SPARC-Auburn/IEEE-SoutheastCon-2009/Mechanical/Sorting Rack/SR-ASSY.jpg

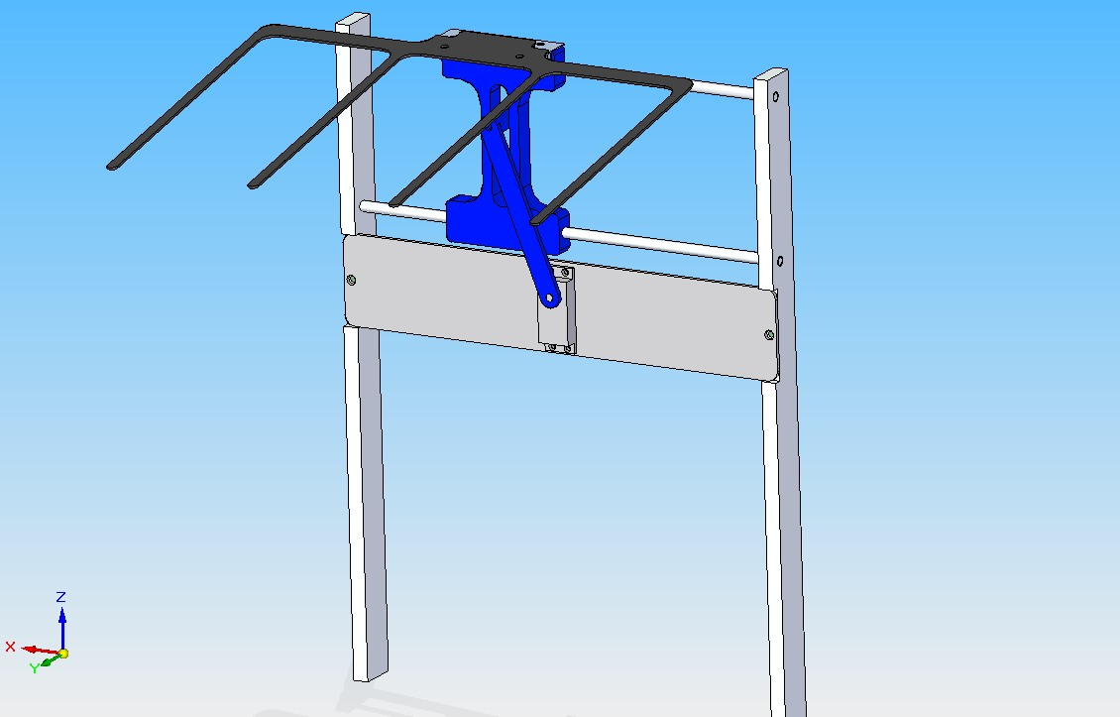
Mechanical/Sorting Rack/SR-ASSY.jpg
