SPARC-Auburn/IEEE-SoutheastCon-2009/README.md

# IEEE-SoutheastCon-2009


</br>
2009 IEEE Southeastern Conference Hardware Competition
Auburn wins First Place. Completely autonomous (no human control) robots pick up and sort plastic bottles, glass bottles, and aluminum cans. </br> </br>
<h3>Youtube links</h3>
Finals Rounds 1 and 2: https://www.youtube.com/watch?v=hqzZF7xkqyw&ab_channel=ThaddeusRoppel</br>
Finals Round 2: https://www.youtube.com/watch?v=y-UYFPOnJFw&ab_channel=SoutheastCon2009</br><br/>

<br/>
For more photos visit: https://www.flickr.com/photos/jckhamken/sets/72157614361313436/
