SPARC-Auburn/IEEE-SoutheastCon-2009/Mechanical/Sorting Rack/Sorting Rack Movement.xlsx

 | Total Servo Rotation
Crank Length (in) | degrees | radians | Block Traversal (in) | Distance from center (in)
4.00 | 140.00 | 2.44 | 7.52 | 3.76
