SPARC-Auburn/IEEE-SoutheastCon-2009/Code/Utilities/Dashboard/sorterImageA.gif

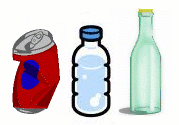
Code/Utilities/Dashboard/sorterImageA.gif
