SPARC-Auburn/IEEE-SoutheastCon-2009/Mechanical/ARM CONCEPT - ALUMINUM CAN.jpg

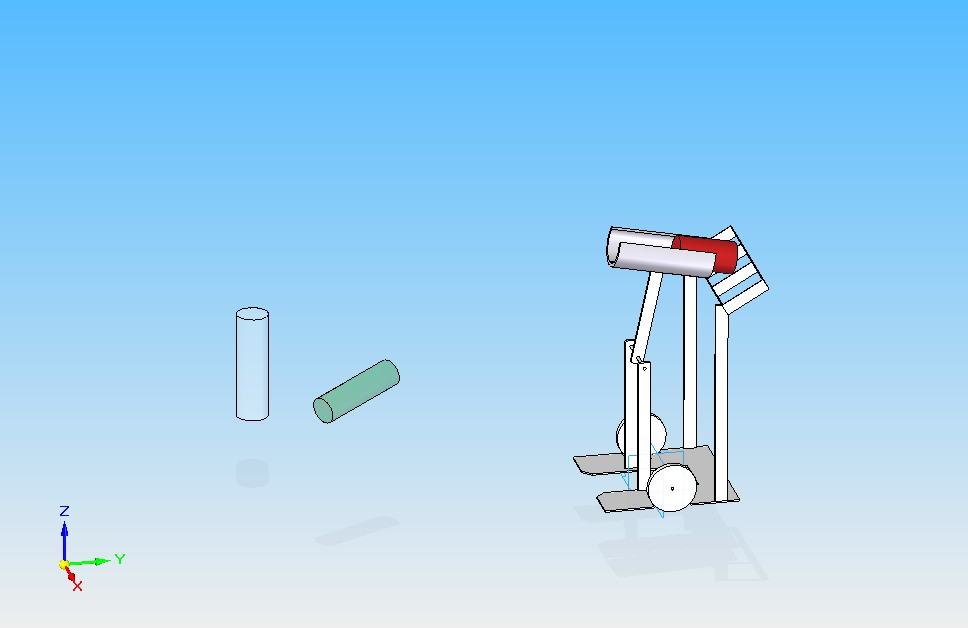
Mechanical/ARM CONCEPT - ALUMINUM CAN.jpg
