SPARC-Auburn/IEEE-SoutheastCon-2009/Mechanical/ARM CONCEPT - CLOSED.jpg

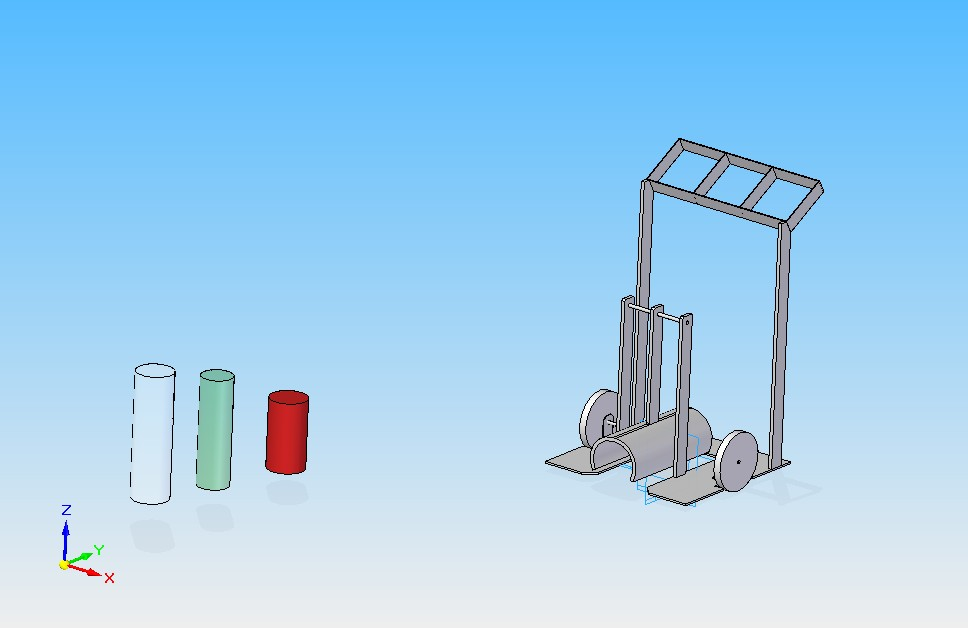
Mechanical/ARM CONCEPT - CLOSED.jpg
