SPARC-Auburn/IEEE-SoutheastCon-2009/Mechanical/ARM CONCEPT - EXTENDED.jpg

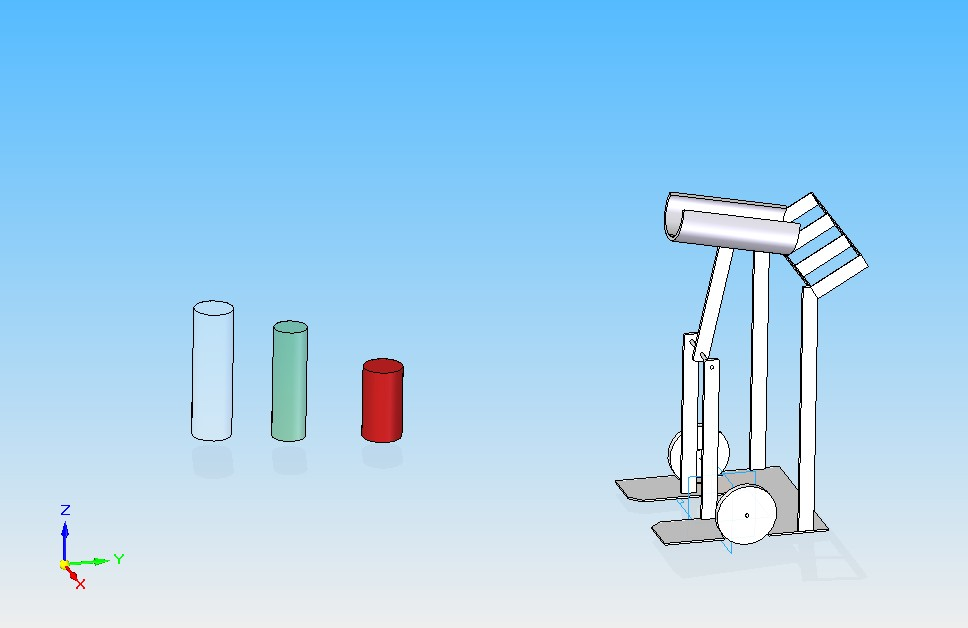
Mechanical/ARM CONCEPT - EXTENDED.jpg
