SPARC-Auburn/IEEE-SoutheastCon-2009/Mechanical/ARM CONCEPT - GLASS BOTTLE.jpg

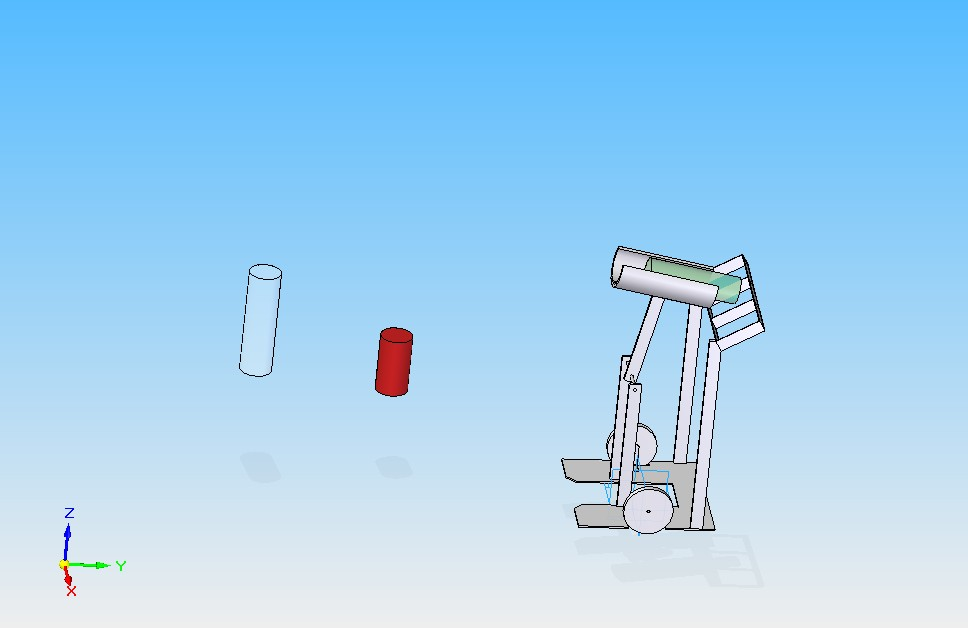
Mechanical/ARM CONCEPT - GLASS BOTTLE.jpg
