SPARC-Auburn/IEEE-SoutheastCon-2009/Mechanical/Chassis/Chassis Model Images/CHAS-SR-ASSY-BOARDMOUNTED.jpg

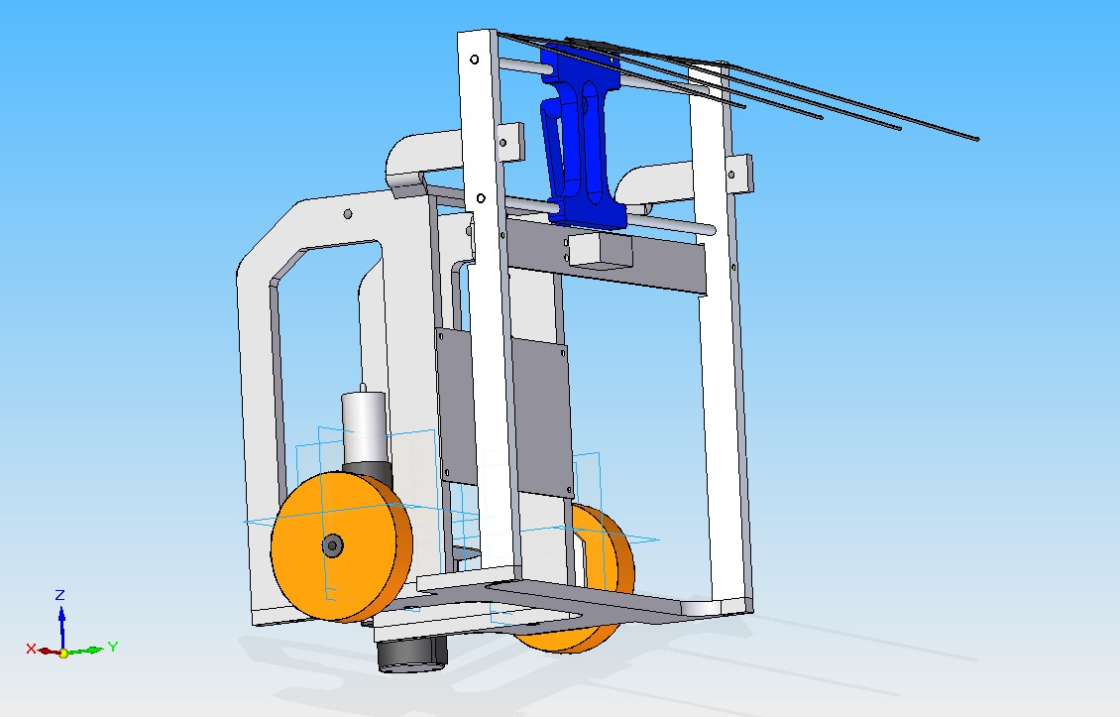
Mechanical/Chassis/Chassis Model Images/CHAS-SR-ASSY-BOARDMOUNTED.jpg
