SPARC-Auburn/IEEE-SoutheastCon-2009/Mechanical/Chassis/Chassis Model Images/CHAS-SR-ASSY-BOTTOM.jpg

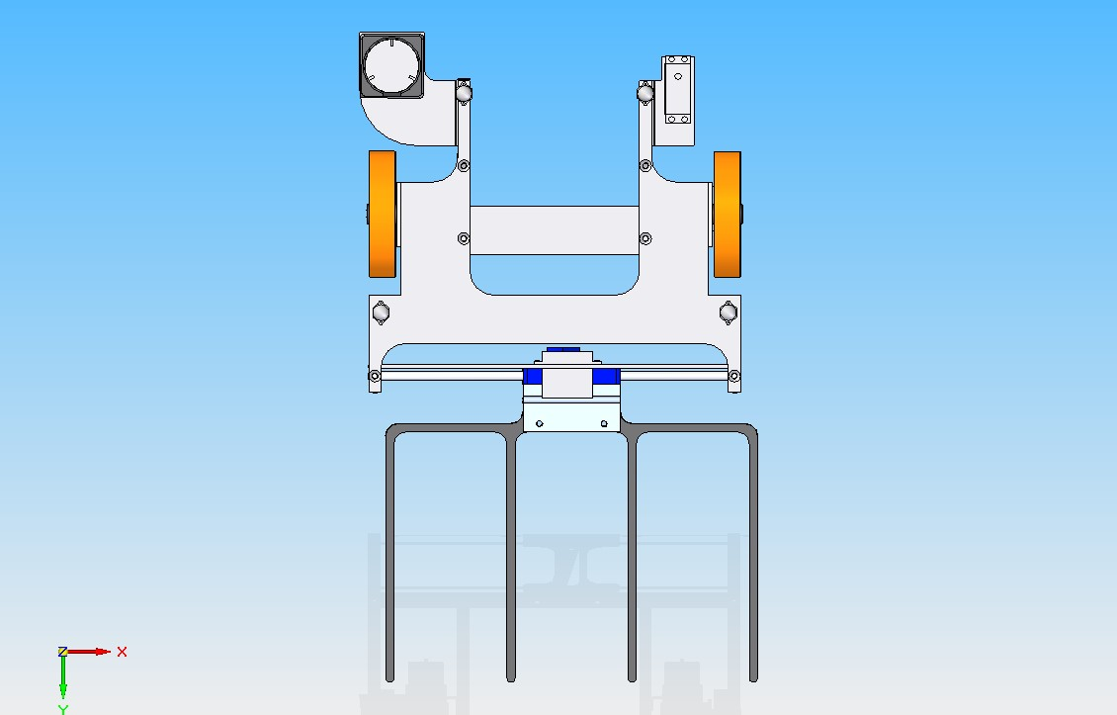
Mechanical/Chassis/Chassis Model Images/CHAS-SR-ASSY-BOTTOM.jpg
