SPARC-Auburn/IEEE-SoutheastCon-2009/Mechanical/Chassis/Hardware References/IG32RGMa.gif

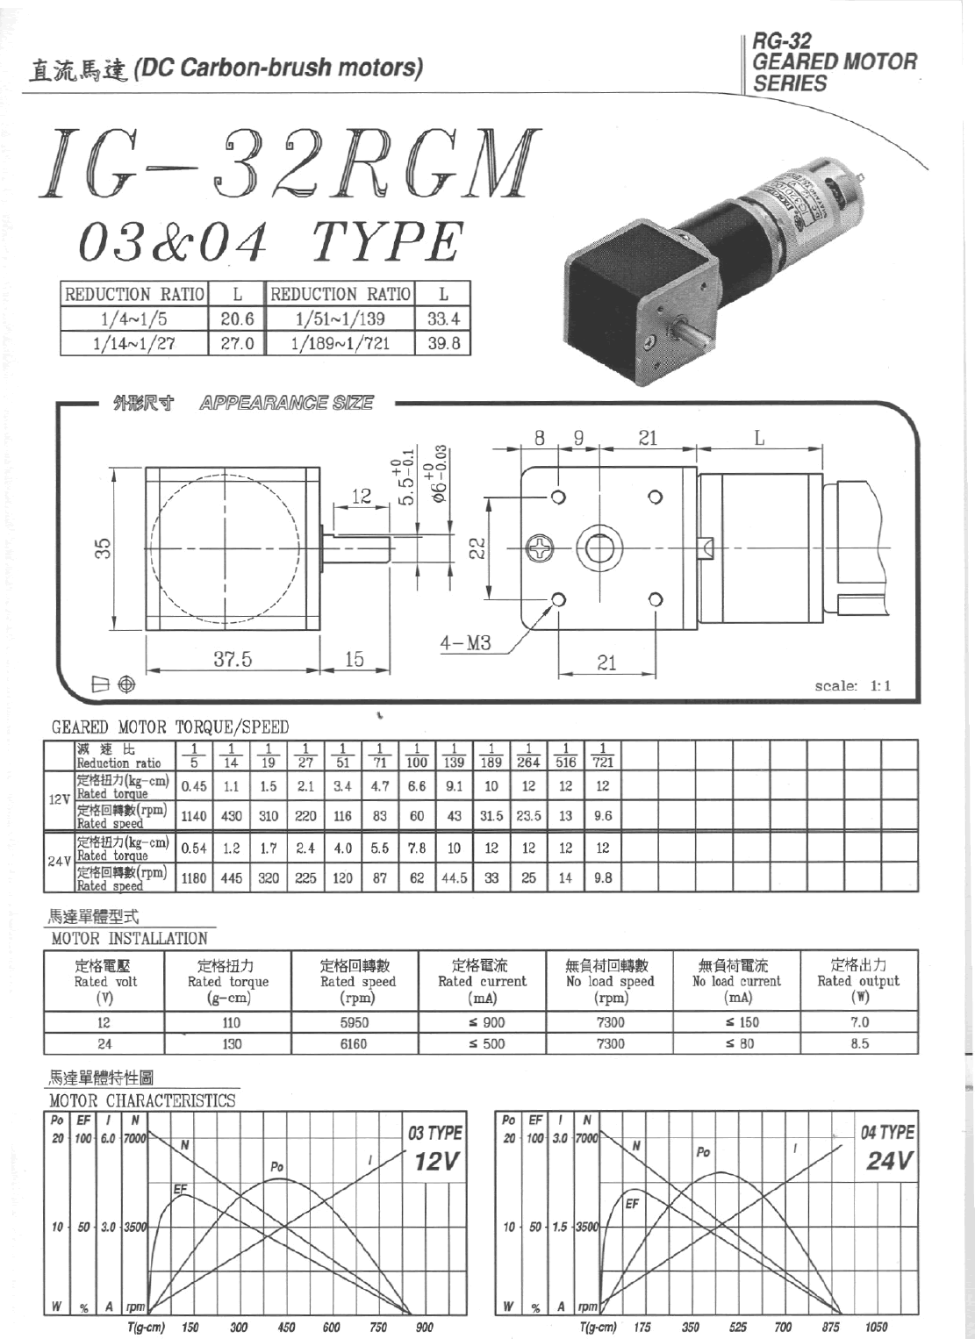
Mechanical/Chassis/Hardware References/IG32RGMa.gif
