SPARC-Auburn/IEEE-SoutheastCon-2009/Mechanical/Chassis/Hardware References/PololuCasters.jpg

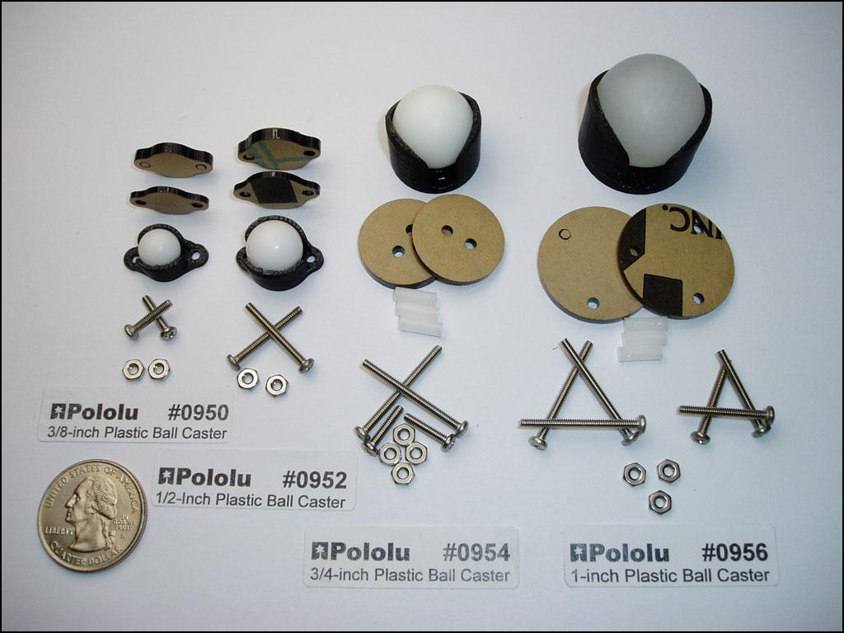
Mechanical/Chassis/Hardware References/PololuCasters.jpg
