SPARC-Auburn/IEEE-SoutheastCon-2009/Mechanical/Chassis/OBJECT DETECTION 1.jpg

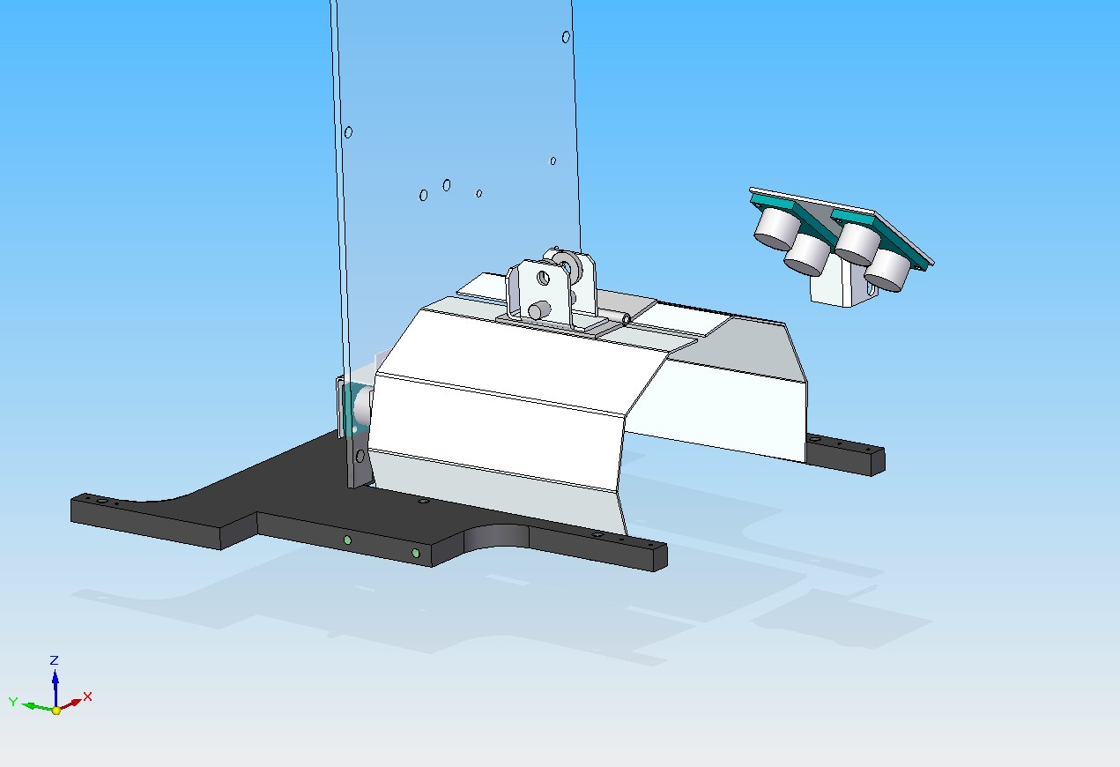
Mechanical/Chassis/OBJECT DETECTION 1.jpg
