SPARC-Auburn/IEEE-SoutheastCon-2009/Mechanical/Chassis/OBJECT DETECTION 2.jpg

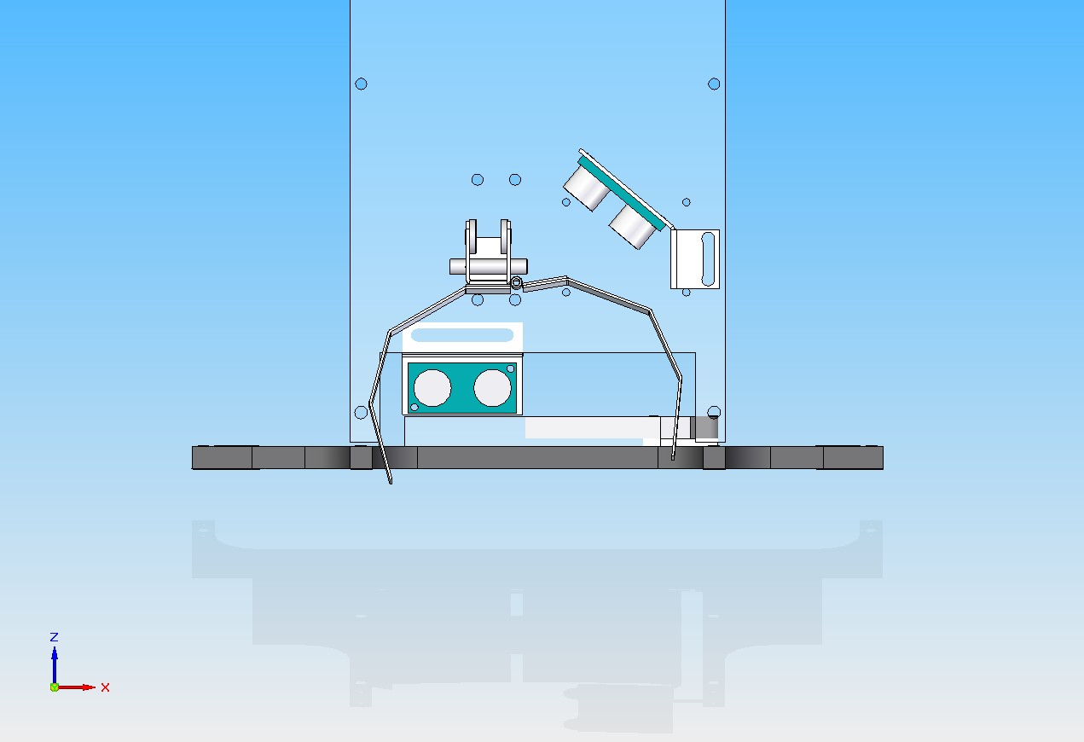
Mechanical/Chassis/OBJECT DETECTION 2.jpg
