SPARC-Auburn/IEEE-SoutheastCon-2009/Mechanical/Chassis/OBJECT DETECTION 5.jpg

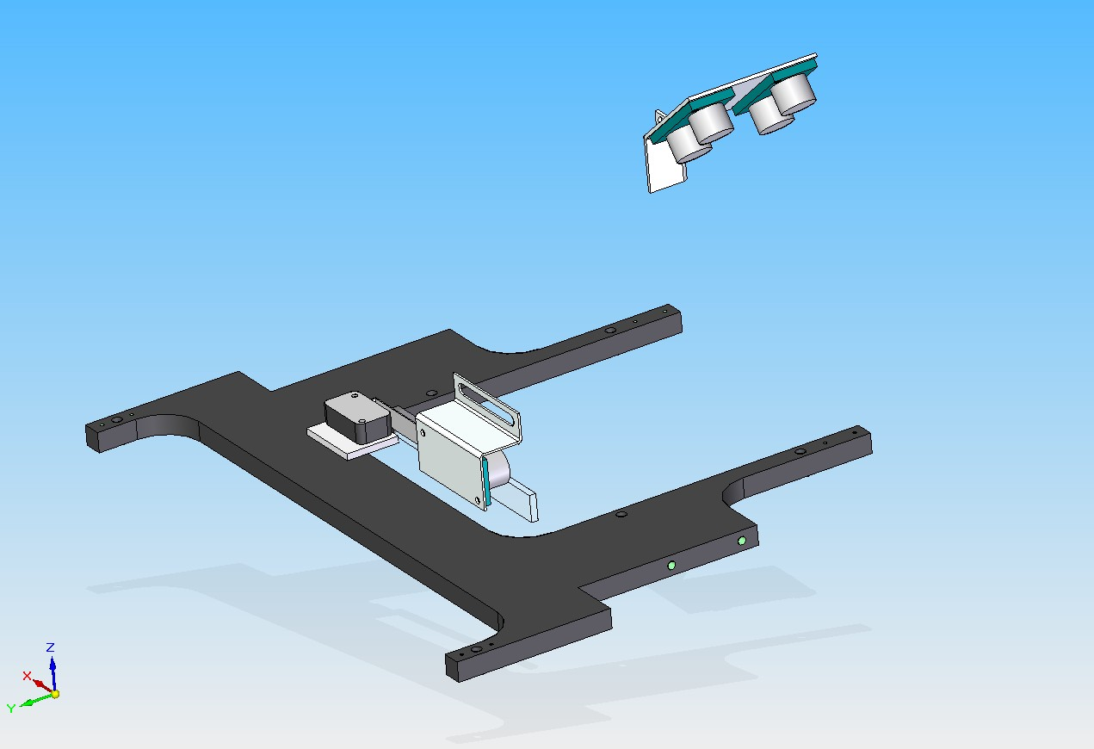
Mechanical/Chassis/OBJECT DETECTION 5.jpg
