SPARC-Auburn/IEEE-SoutheastCon-2009/Mechanical/Chassis/OBJECT DETECTION 6.jpg

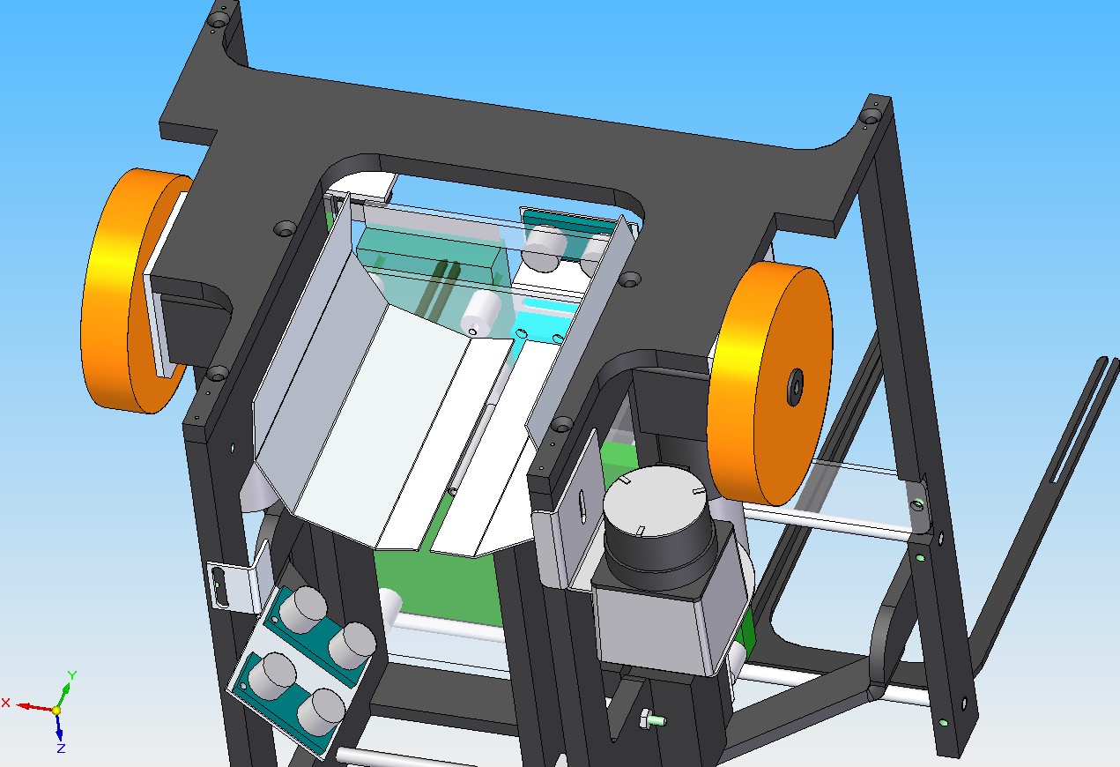
Mechanical/Chassis/OBJECT DETECTION 6.jpg
