SPARC-Auburn/IEEE-SoutheastCon-2009/Mechanical/Concepts/Arm-Gripper/gripper-closed.jpg

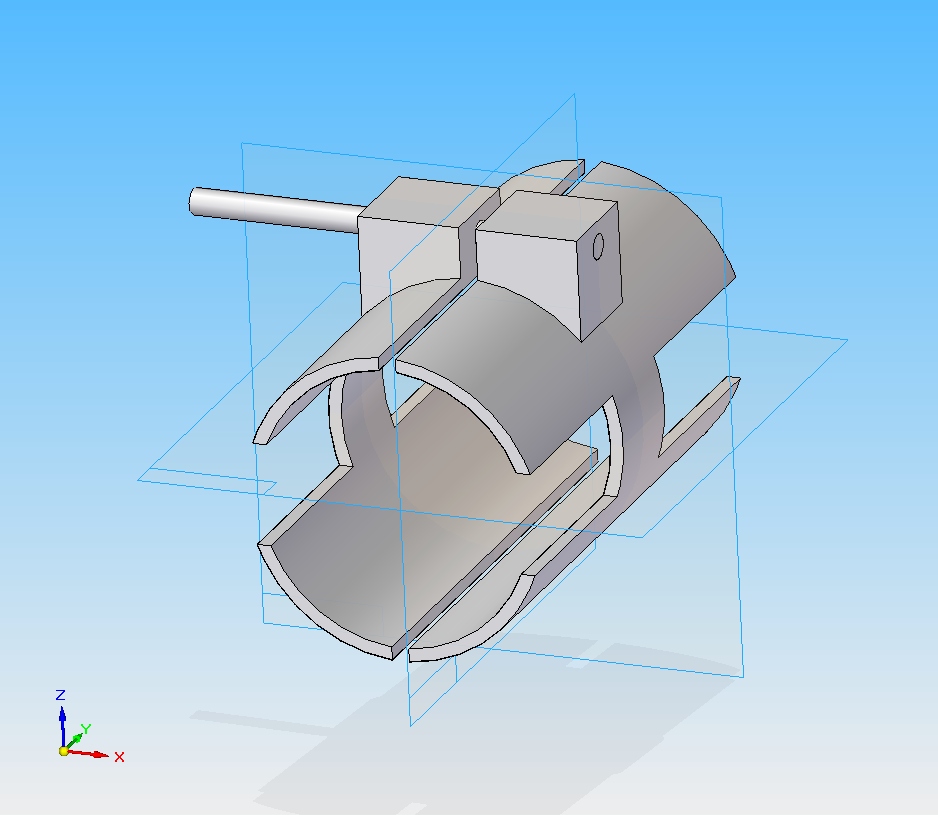
Mechanical/Concepts/Arm-Gripper/gripper-closed.jpg
