SPARC-Auburn/IEEE-SoutheastCon-2009/Mechanical/Concepts/Arm-Gripper/gripper-open.jpg

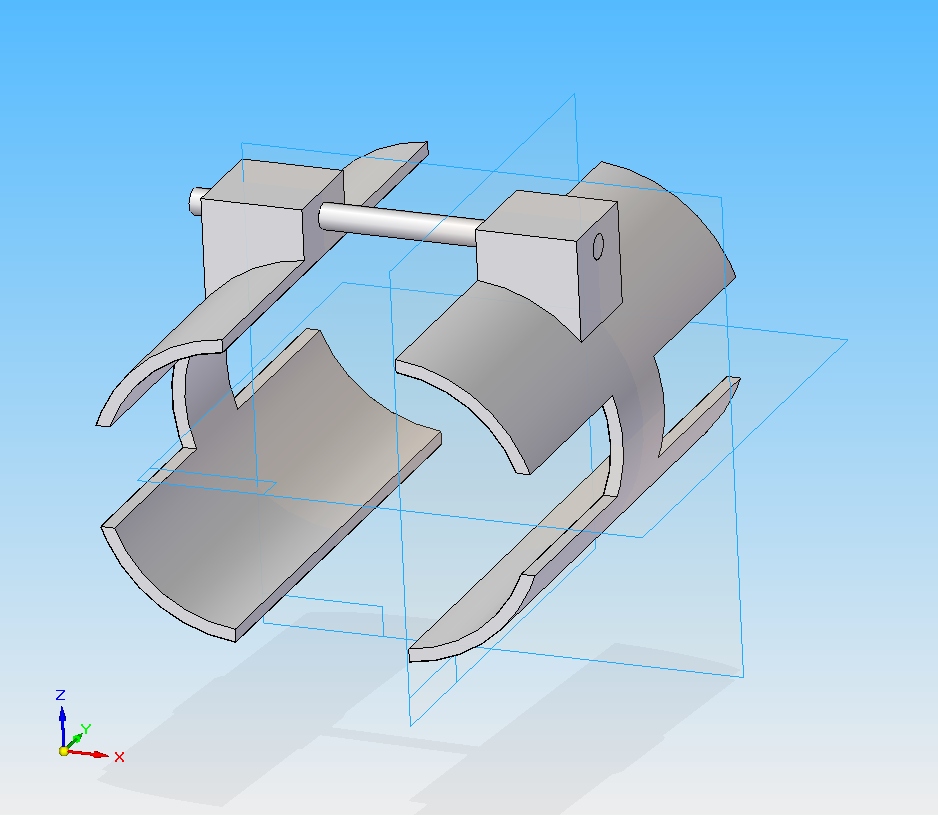
Mechanical/Concepts/Arm-Gripper/gripper-open.jpg
