SPARC-Auburn/IEEE-SoutheastCon-2009/Mechanical/Concepts/End Effector/Scoop.jpg

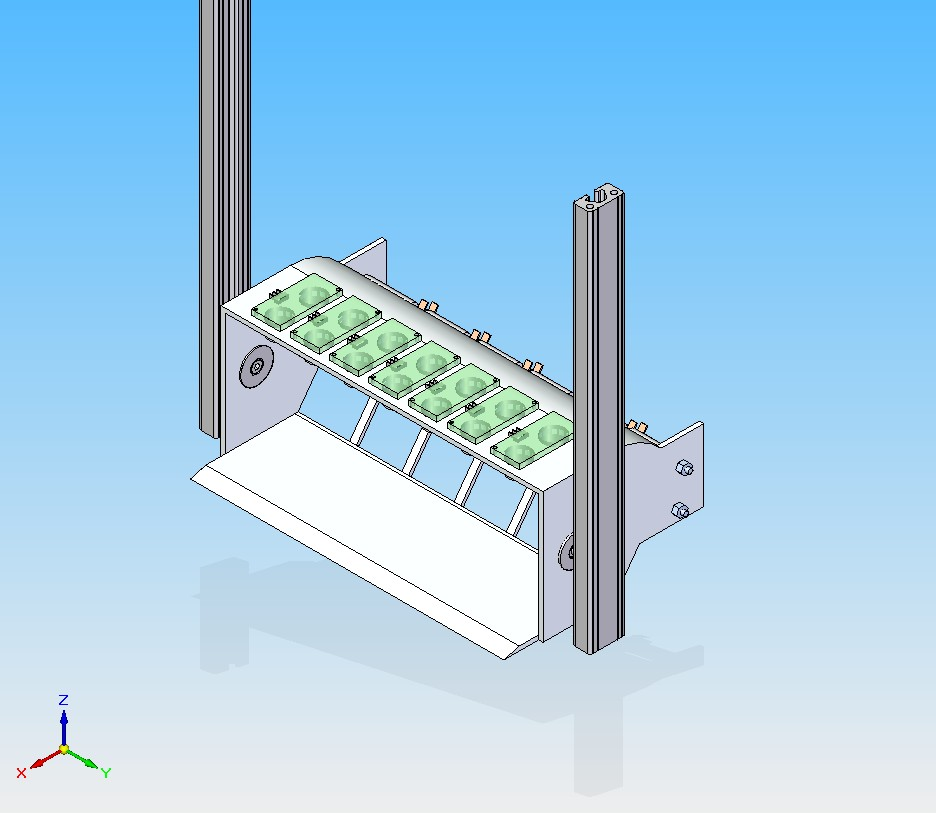
Mechanical/Concepts/End Effector/Scoop.jpg
