SPARC-Auburn/IEEE-SoutheastCon-2009/Mechanical/Concepts/End Effector/Scoop_back.jpg

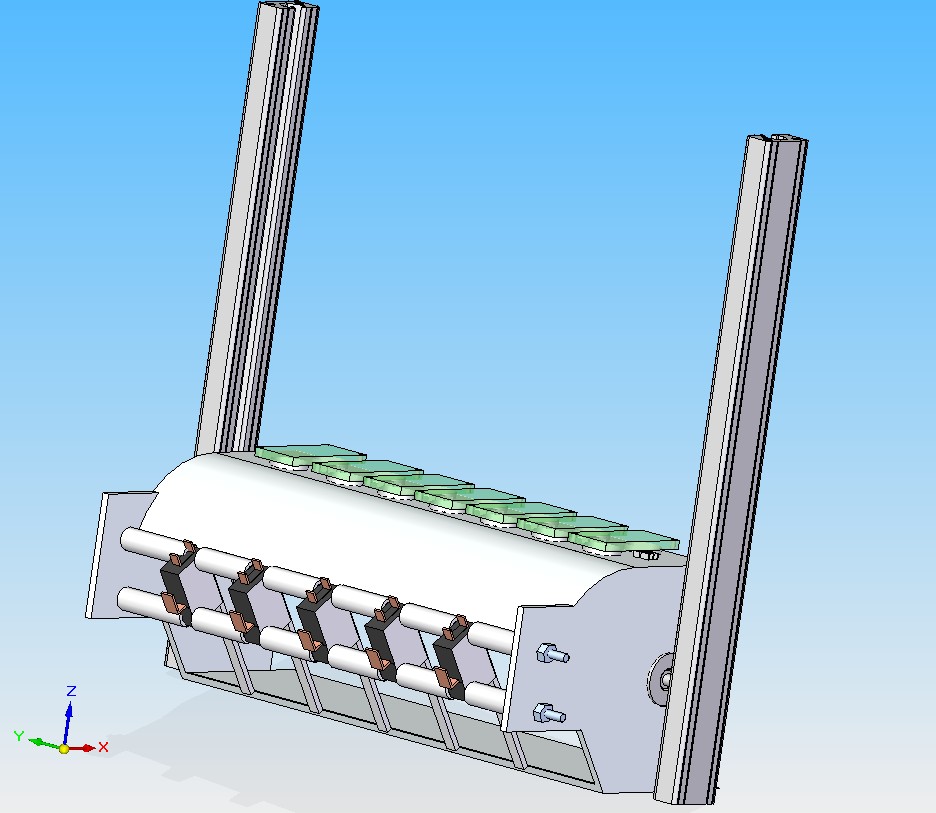
Mechanical/Concepts/End Effector/Scoop_back.jpg
