SPARC-Auburn/IEEE-SoutheastCon-2009/Mechanical/Sorting Rack/SR-5-ASSY.jpg

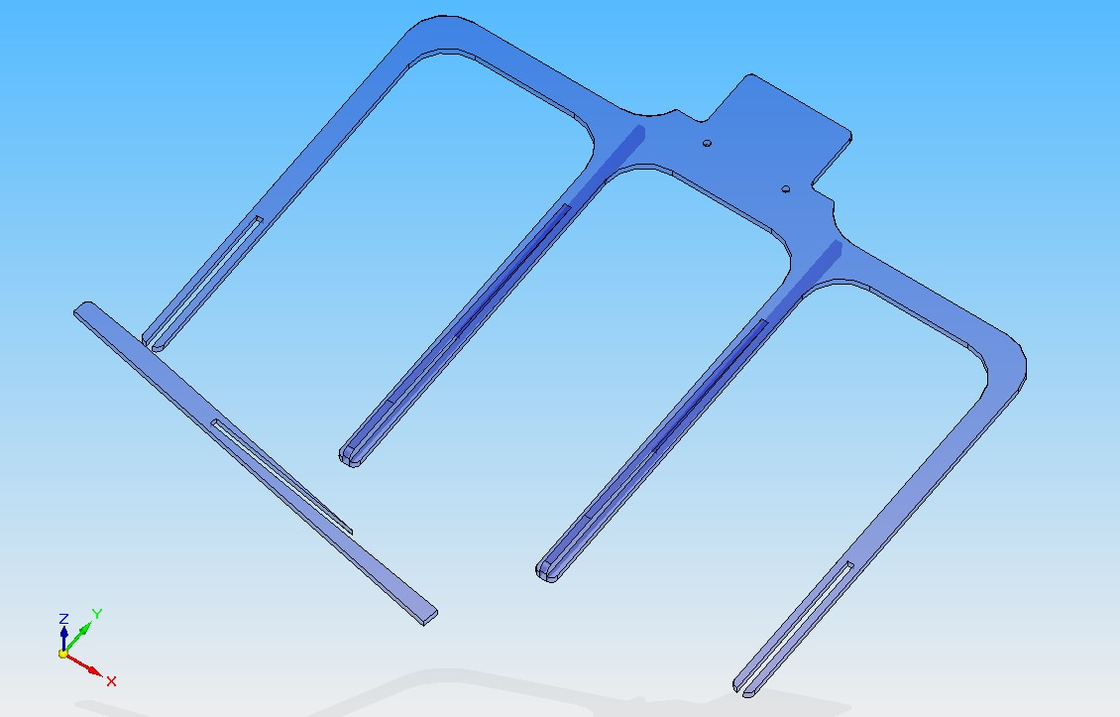
Mechanical/Sorting Rack/SR-5-ASSY.jpg
