SPARC-Auburn/IEEE-SoutheastCon-2009/Mechanical/Sorting Rack/SR-15.jpg

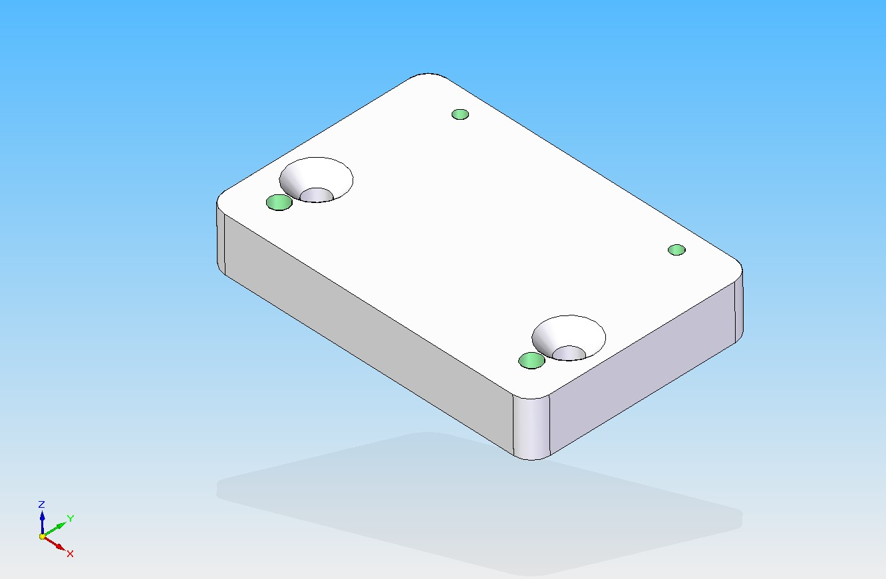
Mechanical/Sorting Rack/SR-15.jpg
