SPARC-Auburn/IEEE-SoutheastCon-2009/Mechanical/Sorting Rack/SR-17.jpg

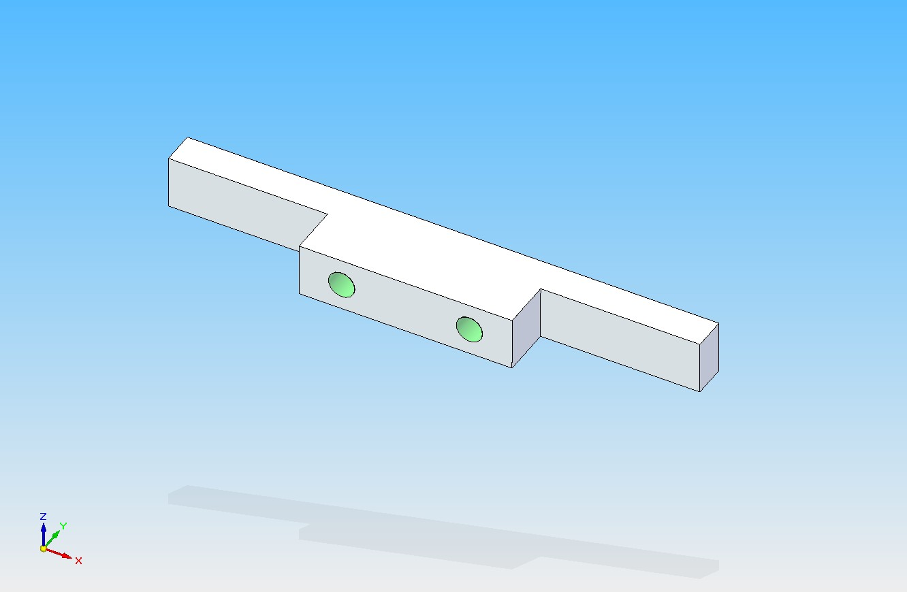
Mechanical/Sorting Rack/SR-17.jpg
