SPARC-Auburn/IEEE-SoutheastCon-2009/Mechanical/Sorting Rack/SR-chassis-2.jpg

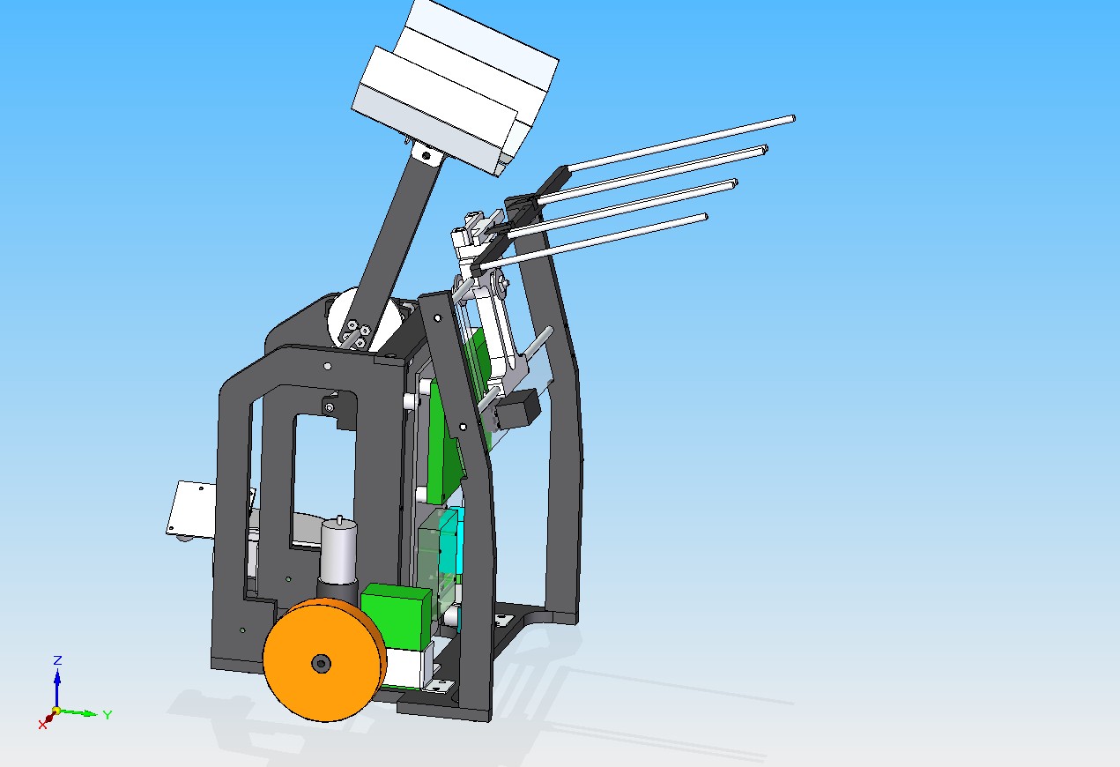
Mechanical/Sorting Rack/SR-chassis-2.jpg
