SPARC-Auburn/IEEE-SoutheastCon-2009/Mechanical/Sorting Rack/SR-chassis.jpg

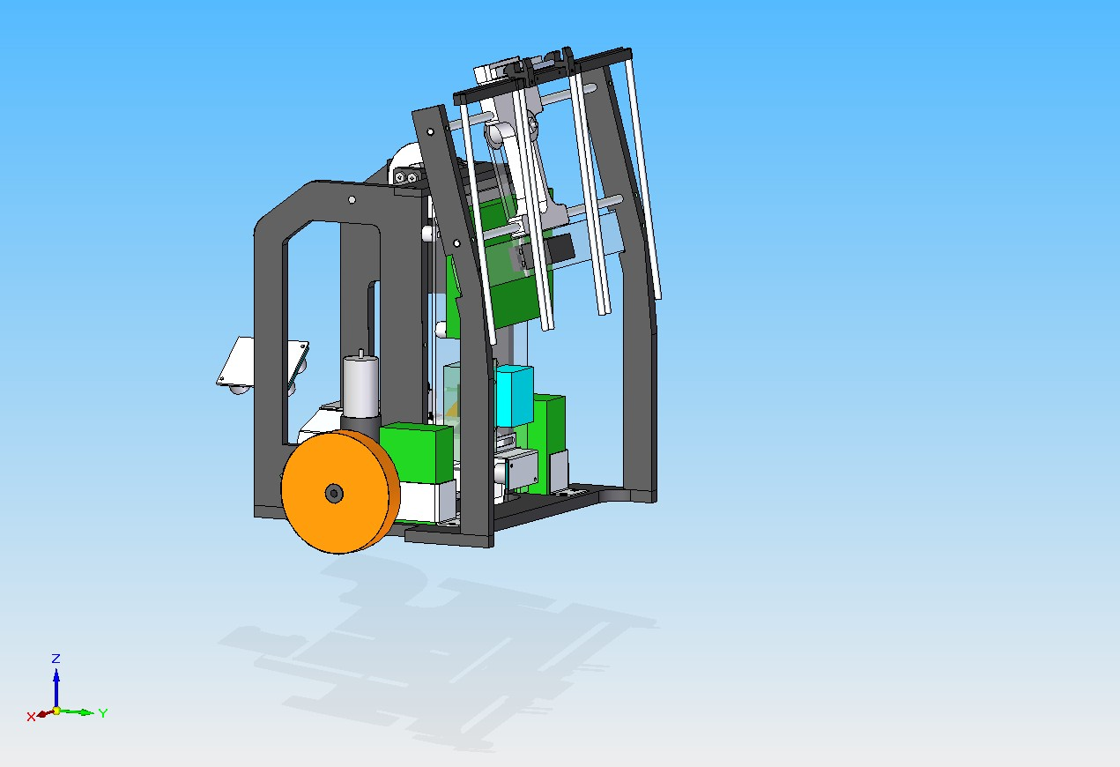
Mechanical/Sorting Rack/SR-chassis.jpg
