SPARC-Auburn/IEEE-SoutheastCon-2009/Mechanical/Sorting Rack/SR-LOCKING.jpg

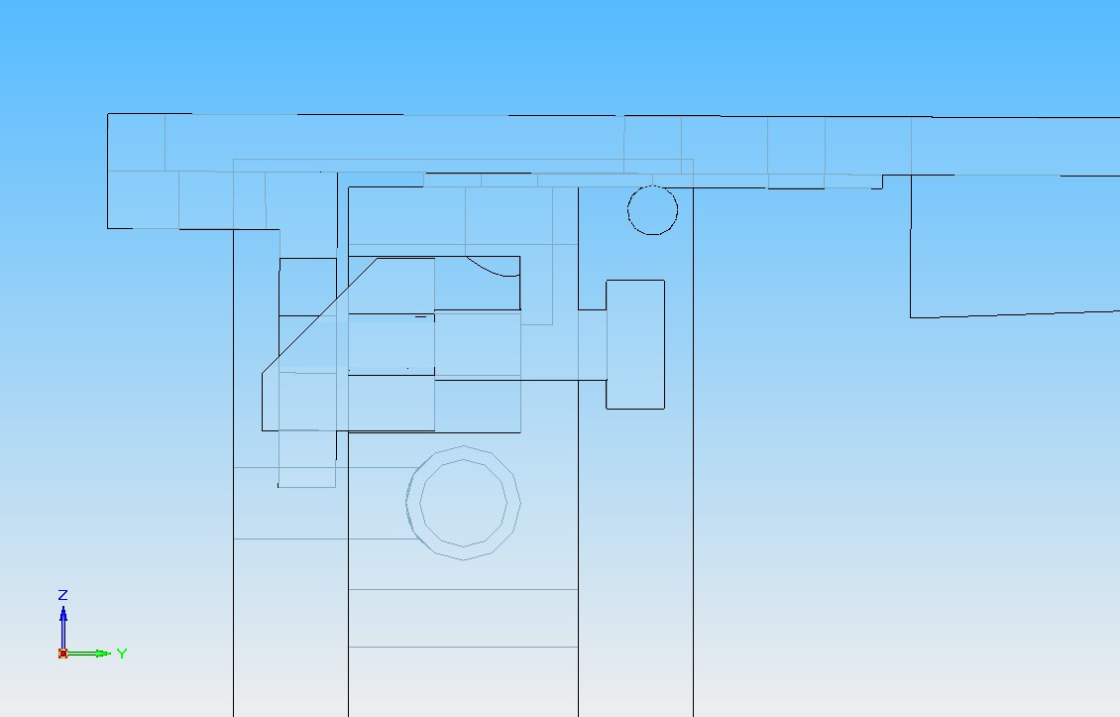
Mechanical/Sorting Rack/SR-LOCKING.jpg
