SPARC-Auburn/IEEE-SoutheastCon-2009/Mechanical/Sorting Rack/SR-strut.jpg

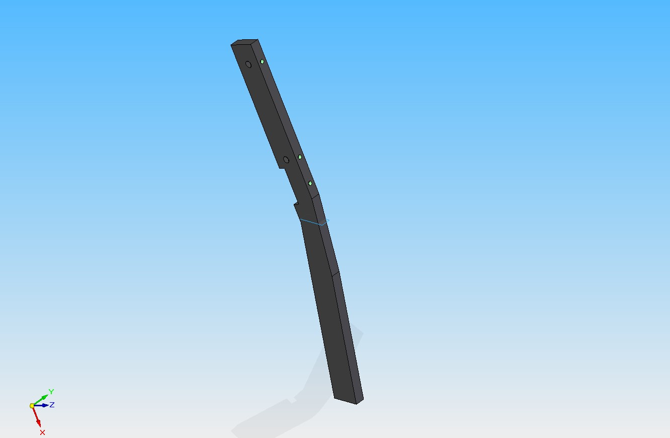
Mechanical/Sorting Rack/SR-strut.jpg
