SPARC-Auburn/IEEE-SoutheastCon-2009/Photos/3046214849_23b4dd4981_o.jpg

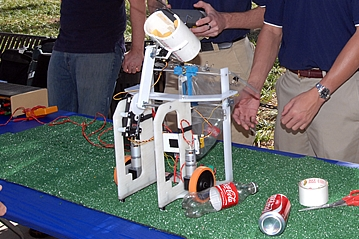
Photos/3046214849_23b4dd4981_o.jpg
