SPARC-Auburn/IEEE-SoutheastCon-2009/Photos/3047049482_58ed21244e_o.jpg

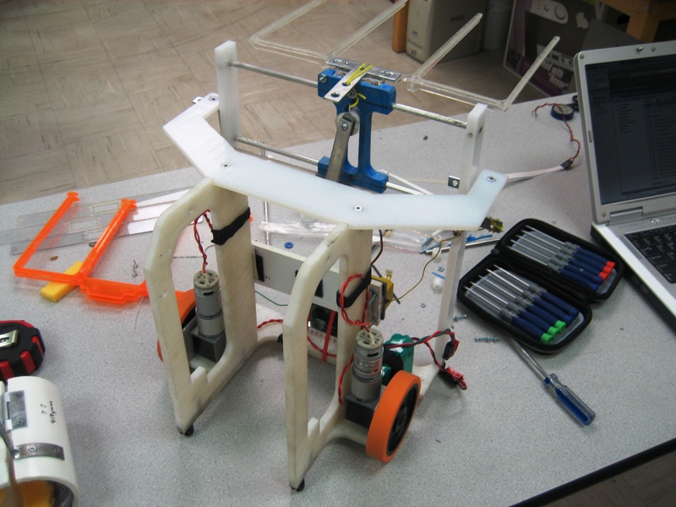
Photos/3047049482_58ed21244e_o.jpg
