SPARC-Auburn/IEEE-SoutheastCon-2009/Photos/3309738992_0ff4b380c9_o.jpg

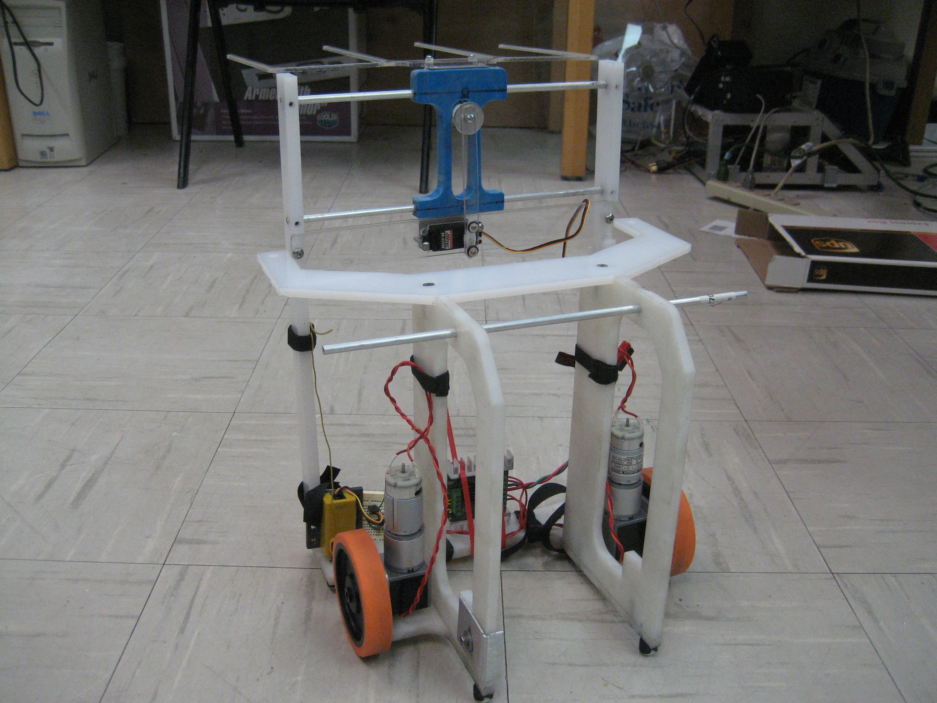
Photos/3309738992_0ff4b380c9_o.jpg
