SPARC-Auburn/IEEE-SoutheastCon-2009/Photos/3341780934_8ddb304d2c_o.jpg

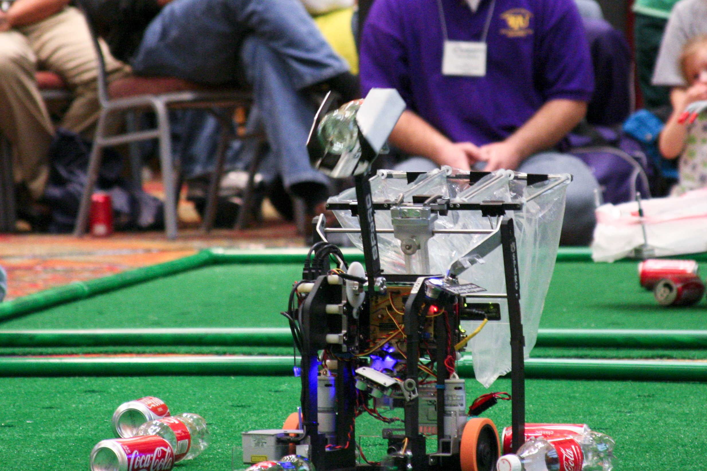
Photos/3341780934_8ddb304d2c_o.jpg
