SPARC-Auburn/IEEE-SoutheastCon-2009/Mechanical/BOMs/Chassis BOM - Rev 2.xlsx

Bill of Materials for Chassis
Item |  | Part Number | Quantity | Unit Price | Shipping | Total Price | Vender | Website
Delrin Sheet - 3/8" x 24" x 12" Rectangle Sheet - Black |  | 8575K216 | 1 | $66.01 | $0.00 | $66.01 | McMaster-Carr
 |  |  | 1 | $0.00 | $0.00 | $0.00
 |  |  | 1 | $0.00 | $0.00 | $0.00
 |  |  | 1 | $0.00 | $0.00 | $0.00
 |  |  | 1 | $0.00 | $0.00 | $0.00
 |  |  | 1 | $0.00 | $0.00 | $0.00
 |  |  | 1 | $0.00 | $0.00 | $0.00
 |  |  | 1 | $0.00 | $0.00 | $0.00
 | TE-091-210 |  | 1 | $0.00 | $0.00 | $0.00
 |  |  | 1 | $0.00 | $0.00 | $0.00
GRAND TOTAL: |  |  |  |  |  | $66.01
