SPARC-Auburn/IEEE-SoutheastCon-2009/Mechanical/BOMs/Sorting Rack BOM - Rev 2.xlsx

Bill of Materials for Sorting Rack
Item | Part Number | Quantity | Unit Price | Shipping | Total Price | Vender
Alloy Steel Precision Hex Socket Shoulder Screw 5/32" Shoulder Dia, 3/8" Shoulder Length, 6-32 Thread | 92012A527 | 2 | $3.40 | $0.00 | $6.80 | McMaster-Carr
Music wire torsion springe 270 deg angle, 0.187 coil OD, 0.023 wire, CW,LH; pack of 6 | 9271K452 | 1 | $5.90 | $0.00 | $5.90 | McMaster-Carr
 |  | 1 | $0.00 | $0.00 | $0.00
 |  | 1 | $0.00 | $0.00 | $0.00
GRAND TOTAL: |  |  |  |  | $12.70
