SPARC-Auburn/IEEE-SoutheastCon-2009/Mechanical/BOMs/Arm and End Effector BOM.xls

Bill of Materials for Arm and End Effector (TENTATIVE)
Item | Part Number | Quantity | Unit Price | Shipping | Total Price | Vender | Website
#6 x .750" PLASTIC SPACER | 94639A515 | 6 | $10.68 | $0.00 | $10.68 | MCMASTER-CARR | www.mcmaster.com
#6-32 x 1.625 PHMS | 91772A159 | 6 | $11.31 | $0.00 | $11.31 | MCMASTER-CARR | www.mcmaster.com
#6-32 HEX NUT | 90480A007 | 6 | $1.30 | $0.00 | $1.30 | MCMASTER-CARR | www.mcmaster.com
.375" ALUMINUM HUB | 3172CH | 1 | $7.95 | $0.00 | $7.95 | SERVOCITY | http://www.servocity.com/html/clamping_hubs.html
COTTER PIN, 1-9/32" TOTAL LENGTH | 93890A421 | 1 | $3.08 | $0.00 | $3.08 | MCMASTER-CARR | www.mcmaster.com
2" x 1.5" SURFACE MOUNT HINGE | 1624A62 | 1 | $3.08 | $0.00 | $3.08 | MCMASTER-CARR | www.mcmaster.com
NEOPRENE RUBBER STRIP, ADHESIVE BACKED, .5" X .375" X 25' | 8694K82 | 1 | $8.08 | $0.00 | $8.08 | MCMASTER-CARR | www.mcmaster.com
12" x 12" ALUMINUM SHEET | 1651T21 | 1 | $22.76 | $0.00 | $22.76 | MCMASTER-CARR | www.mcmaster.com
GRAND TOTAL: |  |  |  |  | $68.24
