SPARC-Auburn/IEEE-SoutheastCon-2009/Mechanical/End Effector/END-01.dxf

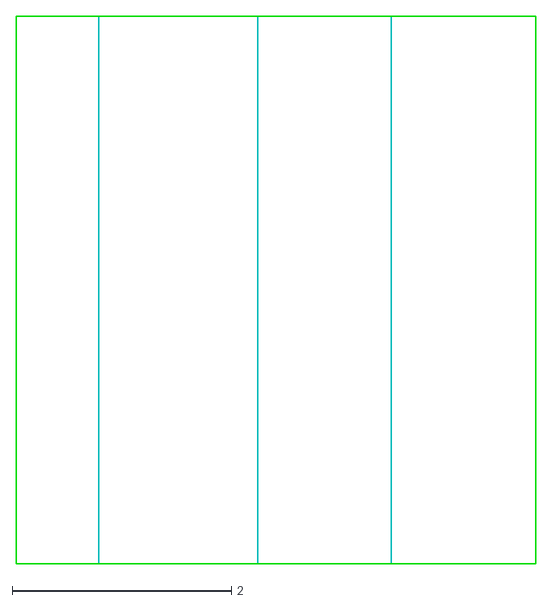
[picture p42: CAD file, 2008-11-13]
Mechanical/End Effector/END-01.dxf
4.74 x 5.00
