SPARC-Auburn/IEEE-SoutheastCon-2009/(list of files, cad)

Other CAD files:
Mechanical/CHASSIS - MOTOR BRACKET.psm
Mechanical/Chassis/BATTERY MOUNT L.psm
Mechanical/Chassis/BATTERY MOUNT R.psm
Mechanical/Chassis/CHAS-03a-L.psm
Mechanical/Chassis/CHAS-03a-R.psm
Mechanical/Chassis/CHAS-03a.psm
Mechanical/Chassis/CHAS-06.psm
Mechanical/Chassis/CHAS-07.psm
Mechanical/Chassis/REAR SONAR MOUNT.psm
Mechanical/Chassis/SONAR MOUNT.psm
Mechanical/Chassis/WHEEL ENCODER MOUNT.psm
Mechanical/End Effector/END-01.psm
Mechanical/End Effector/END-01a.psm
Mechanical/End Effector/END-02.psm
Mechanical/End Effector/END-02a.psm
Mechanical/End Effector/END-03.psm
Mechanical/End Effector/END-03a.psm
Mechanical/End Effector/END-04.psm
Mechanical/End Effector/END-04a.psm
