SPARC-Auburn/IEEE-SoutheastCon-2009/Mechanical/Chassis/ROBOT ASSEMBLY, ARM DEPOSITING ISO VIEW.jpg

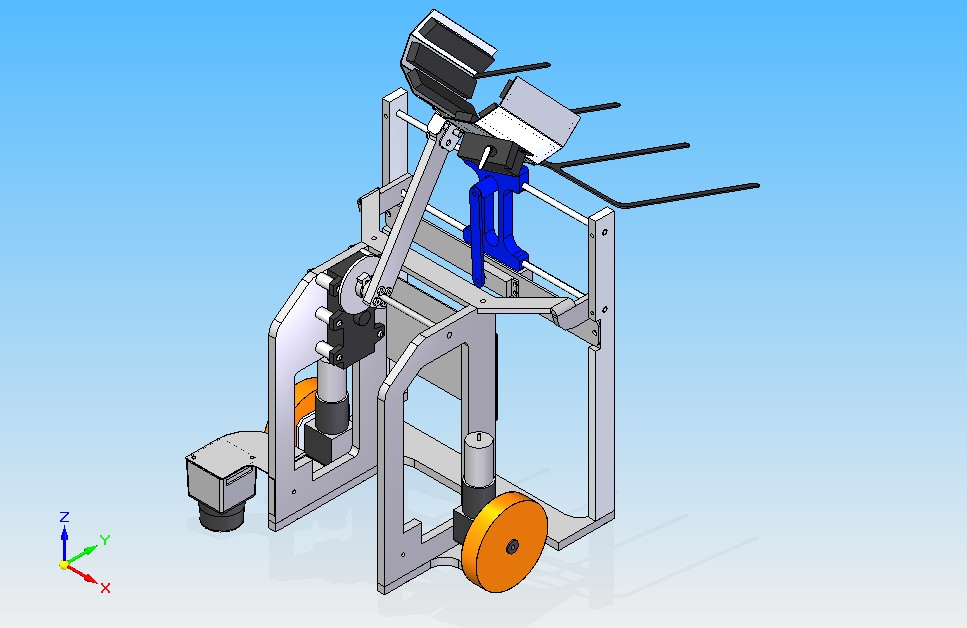
Mechanical/Chassis/ROBOT ASSEMBLY, ARM DEPOSITING ISO VIEW.jpg
