SPARC-Auburn/IEEE-SoutheastCon-2009/Mechanical/Chassis/ROBOT ASSEMBLY, ARM DEPOSITING SIDE VIEW.jpg

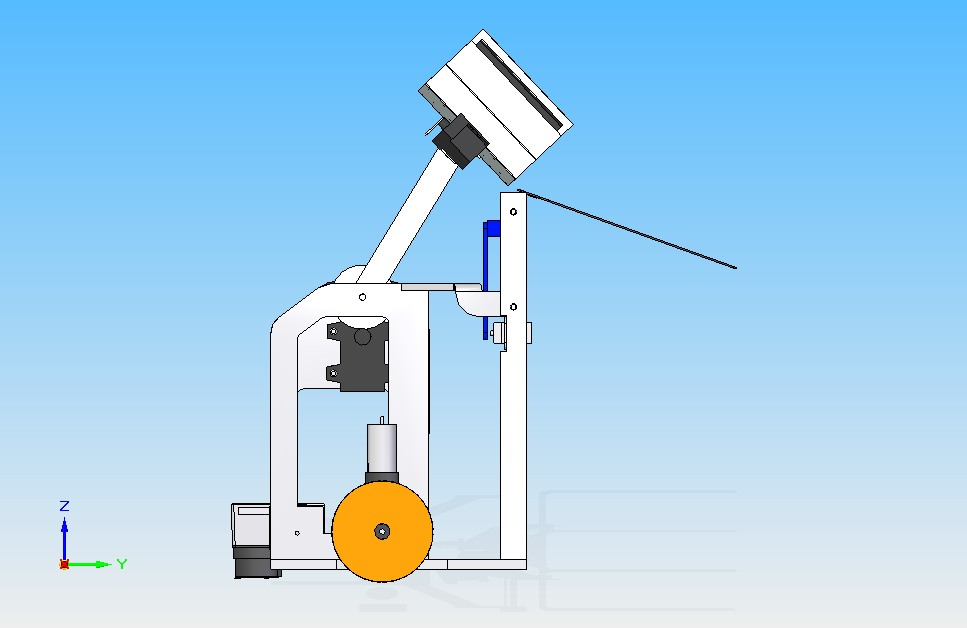
Mechanical/Chassis/ROBOT ASSEMBLY, ARM DEPOSITING SIDE VIEW.jpg
