SPARC-Auburn/IEEE-SoutheastCon-2009/Mechanical/Chassis/ROBOT ASSEMBLY, ARM STOWED.jpg

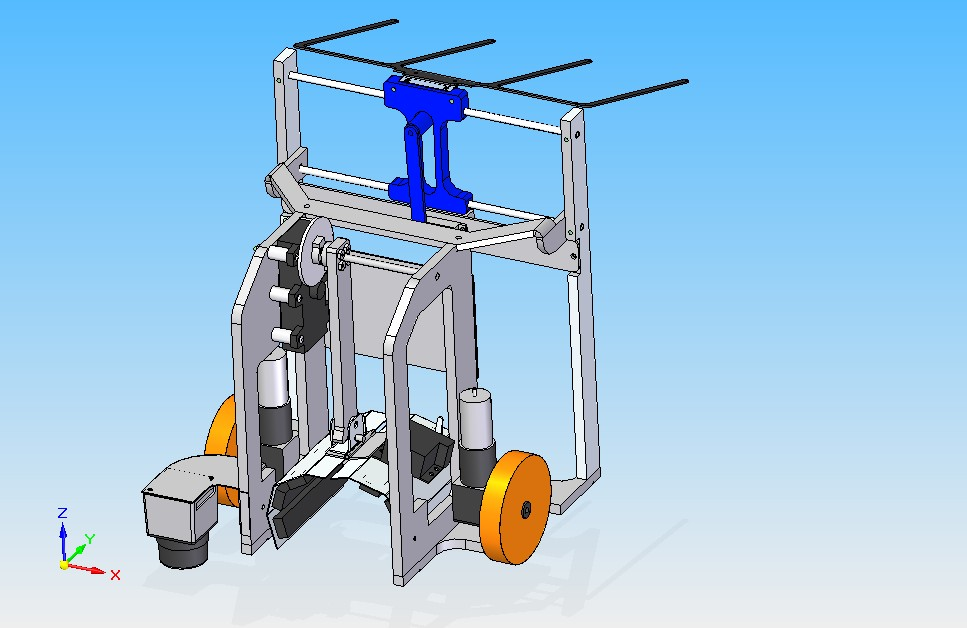
Mechanical/Chassis/ROBOT ASSEMBLY, ARM STOWED.jpg
