SPARC-Auburn/IEEE-SoutheastCon-2009/Code/Sensor Testing Documentation/Experimental Data from Antennas.xls

Experimental Data From Antenna Array Mounted on Robot (A-to-D Readings)
Front Antenna
 | Reading 1 | Reading 2 | Reading 3 | Reading 4 | Average Reading | difference from calibration
8" from front of ferrite | 153 | 170 | 168 | 166 | 164.25
1" from front of ferrite | 200 | 214 | 187 | 175 | 194 | 29.75
front edge of ferrite | 206 | 239 | 193 | 186 | 206 | 41.75
front edge of coil | 210 | 234 | 244 | 203 | 222.75 | 58.5
middle of coil | 247 | 274 | 300 | 262 | 270.75 | 106.5
back edge of coil | 205 | 233 | 248 | 206 | 223 | 58.75
back edge of ferrite | 184 | 170 | 166 | 198 | 179.5 | 15.25
1" from back of ferrite | 146 | 158 | 168 | 144 | 154 | -10.25
Left Antenna
 | Reading 1 | Reading 2 | Reading 3 | Reading 4 | Average Reading | difference from calibration
8" from left of ferrite | 143 | 138 | 144 | 137 | 140.5
1" from left of ferrite | 149 | 139 | 145 | 140 | 143.25 | 2.75
left edge of ferrite | 163 | 173 | 170 | 163 | 167.25 | 26.75
left edge of coil | 196 | 186 | 206 | 183 | 192.75 | 52.25
middle of coil | 243 | 256 | 259 | 243 | 250.25 | 109.75
right edge of coil | 187 | 192 | 201 | 184 | 191 | 50.5
right edge of ferrite | 163 | 173 | 171 | 158 | 166.25 | 25.75
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
