SPARC-Auburn/IEEE-SoutheastCon-2009/Mechanical/Concepts/End Effector/wheel problem.jpg

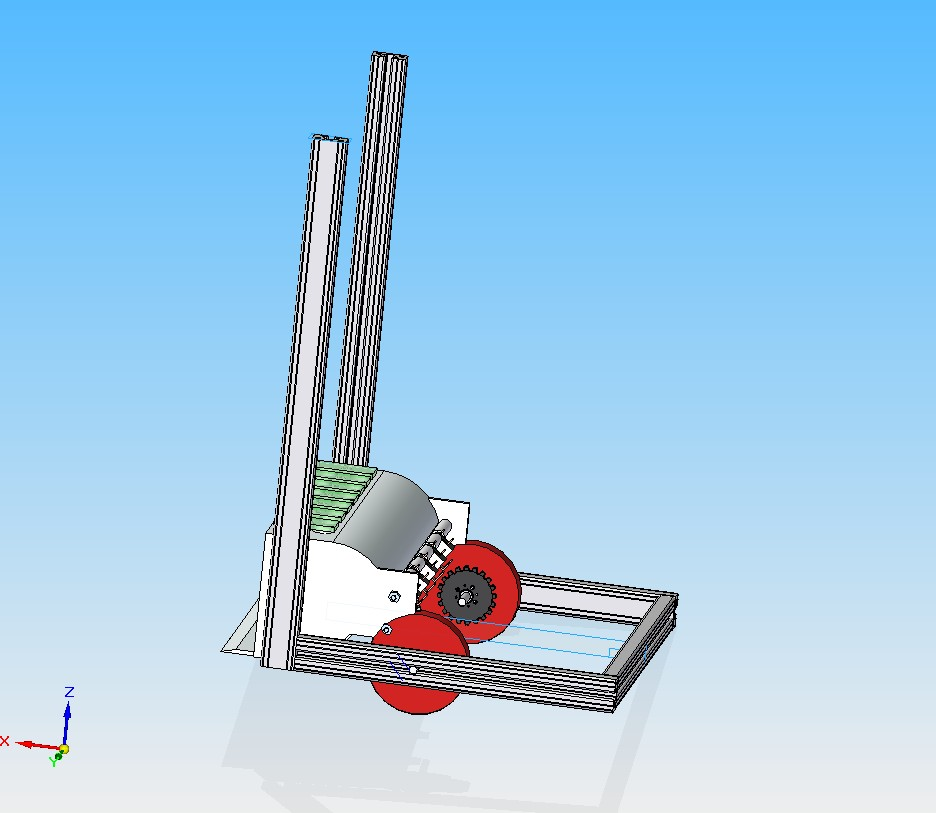
Mechanical/Concepts/End Effector/wheel problem.jpg
