SPARC-Auburn/IEEE-SoutheastCon-2009/Mechanical/End Effector/END-02a.pdf

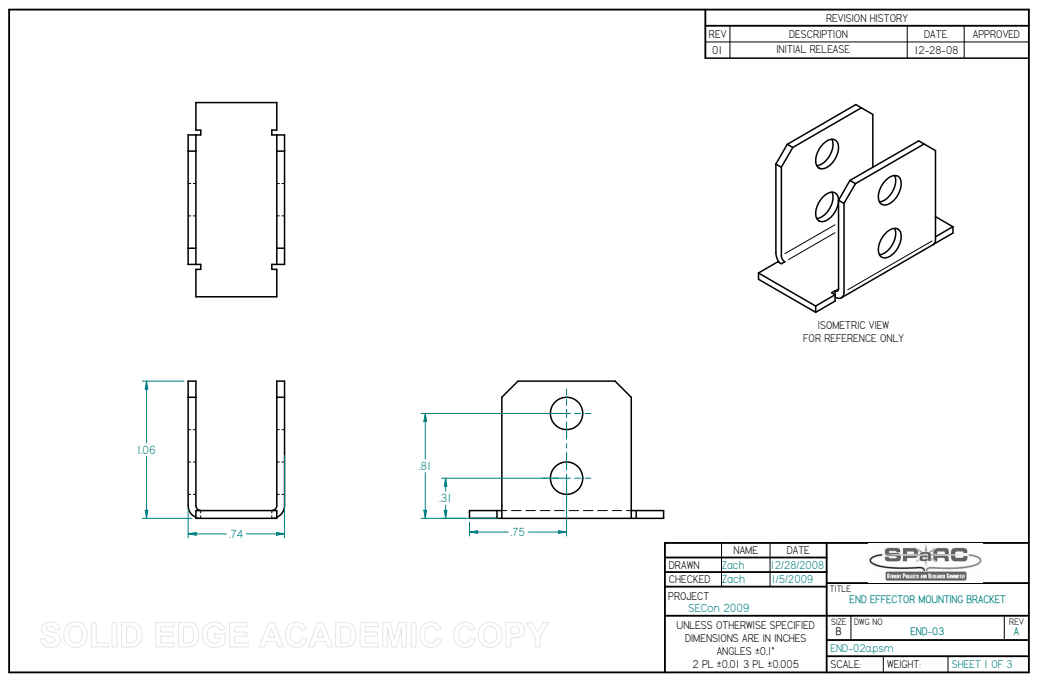
[picture p47: page 1]
SIZE B; DWG NO; END-03; REV A; END-02a.psm; SCALE:; WEIGHT:; SHEET 1 OF 3

REVISION HISTORY

REV | DESCRIPTION | DATE | APPROVED
01 | INITIAL RELEASE | 12-28-08

ISOMETRIC VIEW
FOR REFERENCE ONLY

NAME | DATE

DRAWN | Zach | 12/28/2008
CHECKED | Zach | 1/5/2009

TITLE
END EFFECTOR MOUNTING BRACKET

PROJECT
SECon 2009
UNLESS OTHERWISE SPECIFIED
DIMENSIONS ARE IN INCHES
ANGLES ±0.1°

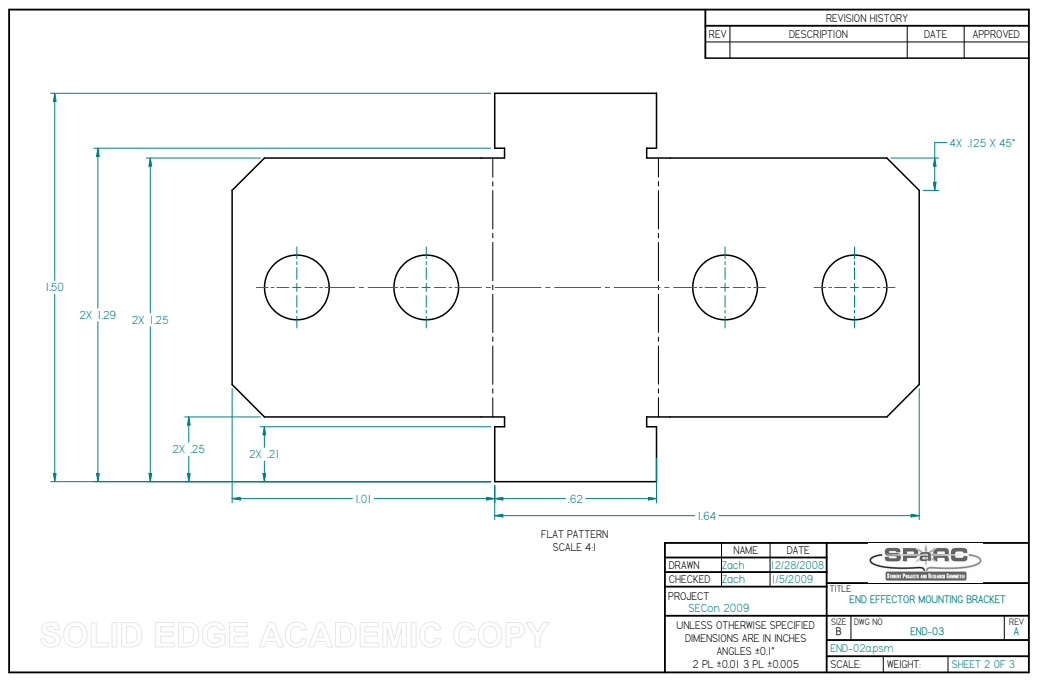
[picture p48: page 2]
SIZE B; DWG NO; END-03; REV A; FLAT PATTERN SCALE 4:1

NAME | DATE

DRAWN | Zach | 12/28/2008
CHECKED | Zach | 1/5/2009

TITLE
END EFFECTOR MOUNTING BRACKET

PROJECT
SECon 2009
UNLESS OTHERWISE SPECIFIED
DIMENSIONS ARE IN INCHES

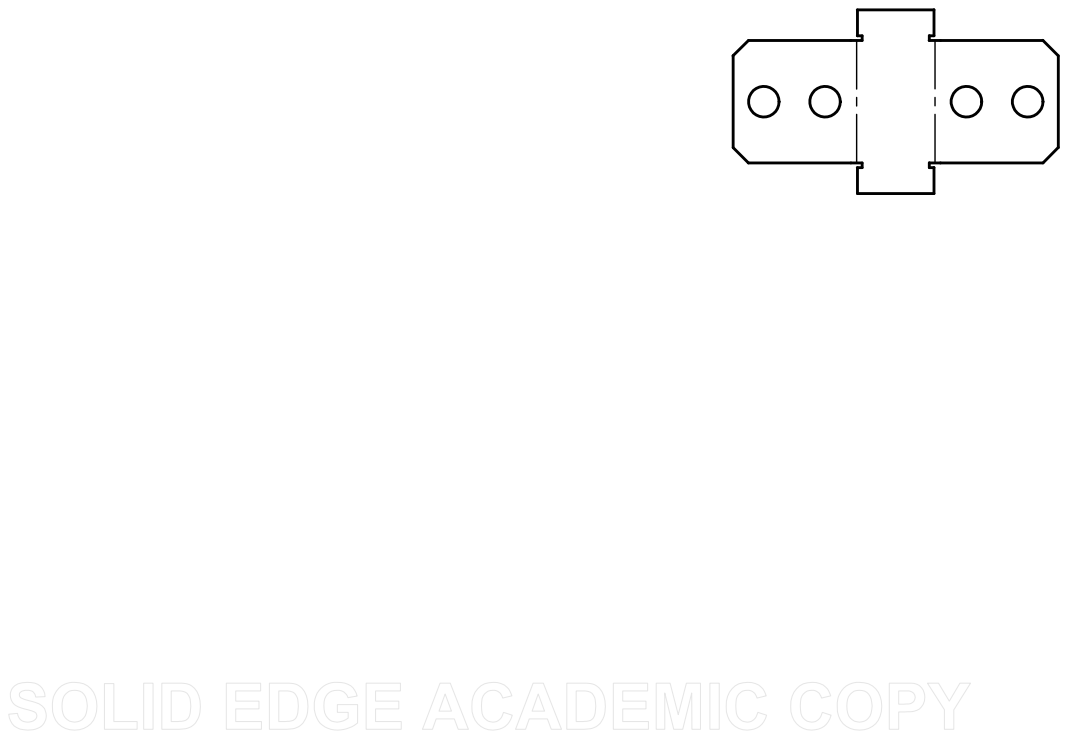
[picture p49: page 3]
SIZE B; DWG NO; END-03; REV A

NAME | DATE

DRAWN | Zach | 12/28/2008
CHECKED | Zach | 1/5/2009

TITLE
END EFFECTOR MOUNTING BRACKET

PROJECT
SECon 2009
UNLESS OTHERWISE SPECIFIED
DIMENSIONS ARE IN INCHES
