SPARC-Auburn/IEEE-SoutheastCon-2009/Mechanical/Chassis/REAR SONAR MOUNT.pdf

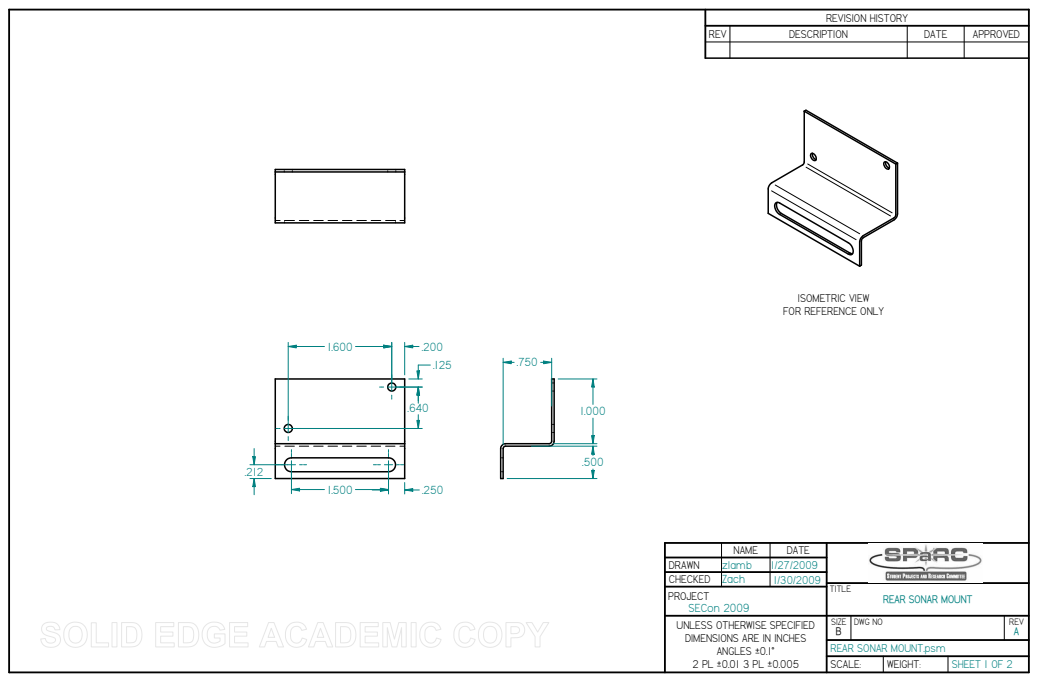
[picture p50: page 1]
TITLE; DWG NO; REV; SCALE:; WEIGHT:; SHEET 1 OF 2

REVISION HISTORY

REV | DESCRIPTION | DATE | APPROVED

ISOMETRIC VIEW
FOR REFERENCE ONLY

NAME | DATE

DRAWN | zlamb | 1/27/2009
CHECKED | Zach | 1/30/2009

PROJECT
SECon 2009
UNLESS OTHERWISE SPECIFIED
DIMENSIONS ARE IN INCHES
ANGLES ±0.1°

REAR SONAR MOUNT

SIZE
REAR SONAR MOUNT.psm

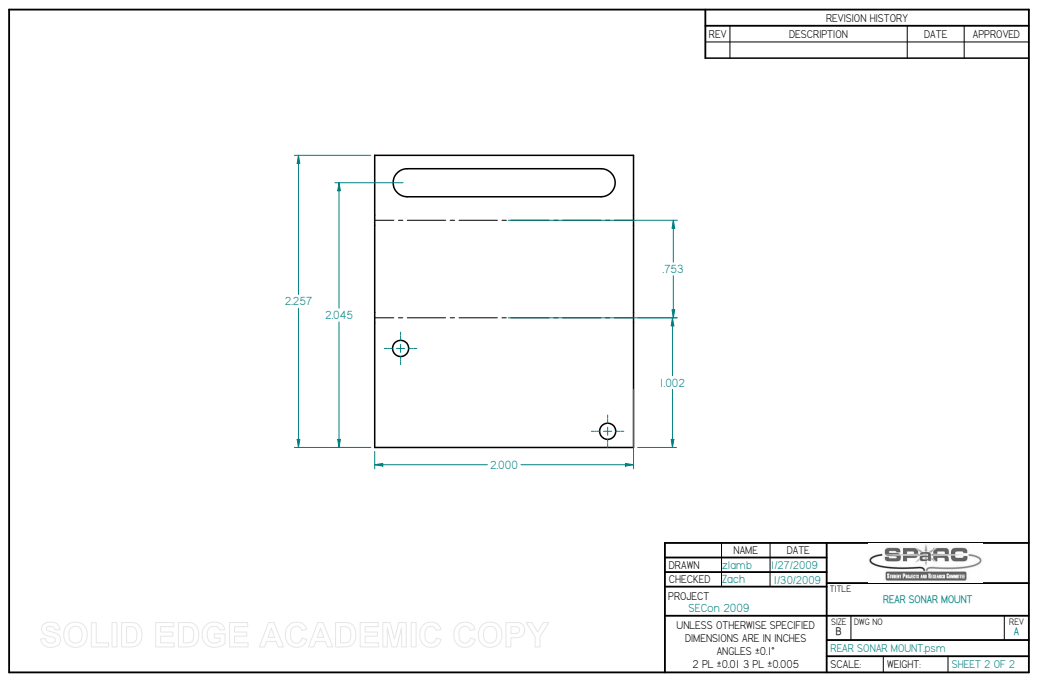
[picture p51: page 2]
TITLE; DWG NO; REV; SCALE:; WEIGHT:; SHEET 2 OF 2

REVISION HISTORY

REV | DESCRIPTION | DATE | APPROVED

NAME | DATE

DRAWN | zlamb | 1/27/2009
CHECKED | Zach | 1/30/2009

PROJECT
SECon 2009
UNLESS OTHERWISE SPECIFIED
DIMENSIONS ARE IN INCHES
ANGLES ±0.1°

REAR SONAR MOUNT

SIZE
REAR SONAR MOUNT.psm
