SPARC-Auburn/IEEE-SoutheastCon-2009/Mechanical/Chassis/SONAR MOUNT.pdf

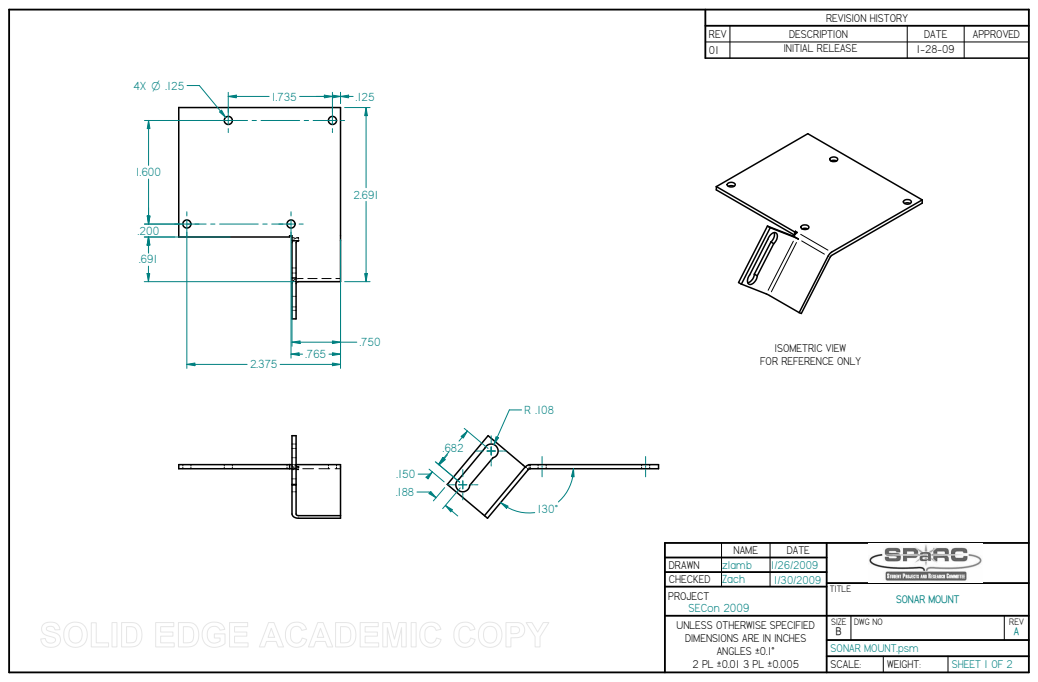
[picture p52: page 1]
TITLE; SONAR MOUNT; SIZE B; DWG NO; REV; SONAR MOUNT.psm; SCALE:; WEIGHT:; SHEET 1 OF 2

REVISION HISTORY

REV | DESCRIPTION | DATE | APPROVED
01 | INITIAL RELEASE | 1-28-09

ISOMETRIC VIEW
FOR REFERENCE ONLY

NAME | DATE

DRAWN | zlamb | 1/26/2009
CHECKED | Zach | 1/30/2009

PROJECT
SECon 2009
UNLESS OTHERWISE SPECIFIED
DIMENSIONS ARE IN INCHES
ANGLES ±0.1°

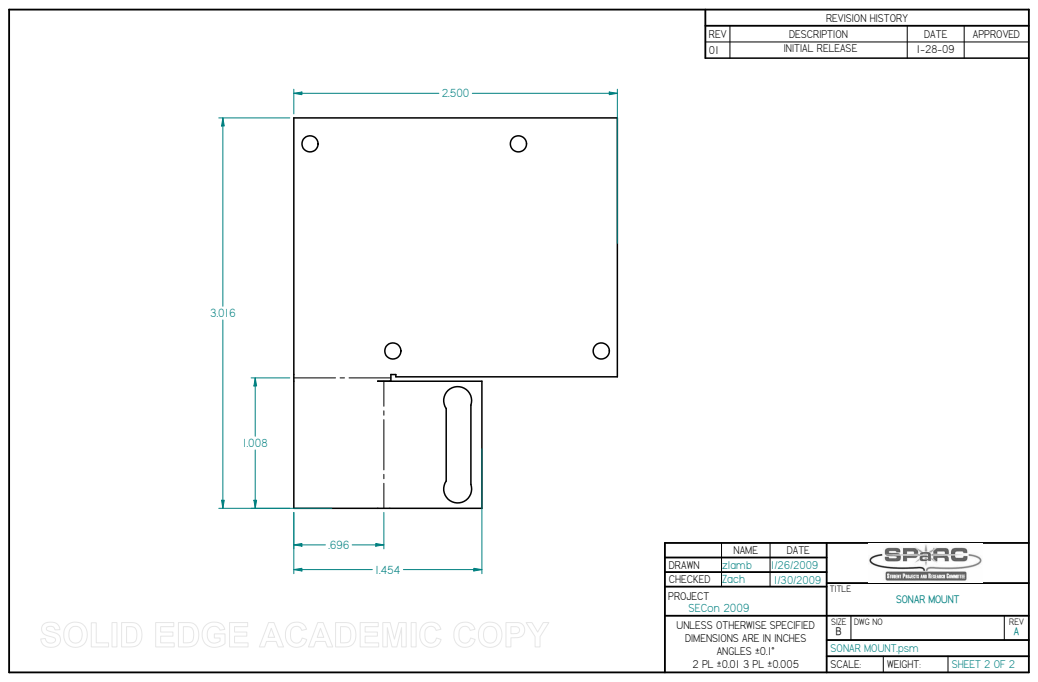
[picture p53: page 2]
TITLE; SONAR MOUNT; SIZE B; DWG NO; REV; SONAR MOUNT.psm; SCALE:; WEIGHT:; SHEET 2 OF 2

REVISION HISTORY

REV | DESCRIPTION | DATE | APPROVED
01 | INITIAL RELEASE | 1-28-09

NAME | DATE

DRAWN | zlamb | 1/26/2009
CHECKED | Zach | 1/30/2009

PROJECT
SECon 2009
UNLESS OTHERWISE SPECIFIED
DIMENSIONS ARE IN INCHES
ANGLES ±0.1°
