SPARC-Auburn/IEEE-SoutheastCon-2009/Mechanical/Chassis/DRAFTS -- PDF/CHAS-02b.pdf

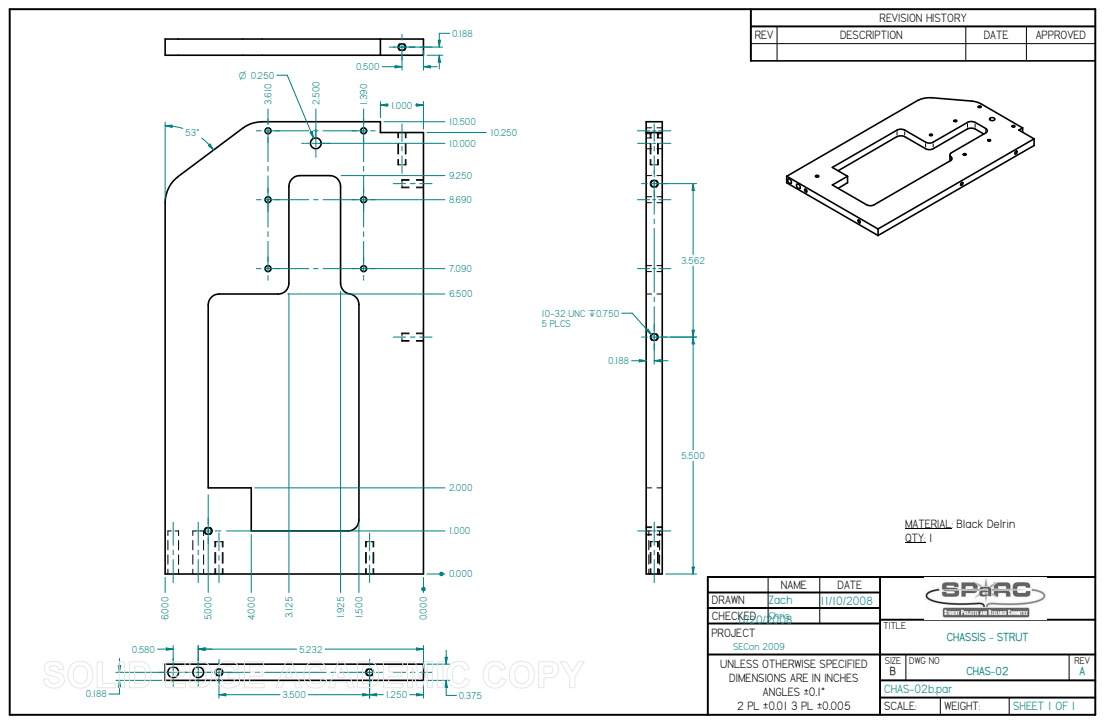
[picture p54: page 1]
TITLE; CHASSIS - STRUT; SIZE B; DWG NO; CHAS-02; REV A; CHAS-02b.par; SCALE:; WEIGHT:; SHEET 1 OF 1; 10-32 UNC `0.750 5 PLCS

REVISION HISTORY

REV | DESCRIPTION | DATE | APPROVED

MATERIAL: Black Delrin
QTY: 1

NAME | DATE

DRAWN | Zach | 11/10/2008
CHECKED | Chris 11/20/2008

PROJECT
SECon 2009
UNLESS OTHERWISE SPECIFIED
DIMENSIONS ARE IN INCHES
ANGLES ±0.1°
