SPARC-Auburn/IEEE-SoutheastCon-2009/Mechanical/Sorting Rack/DRAFTS -- PDF/SR-CRANK-ARM.pdf

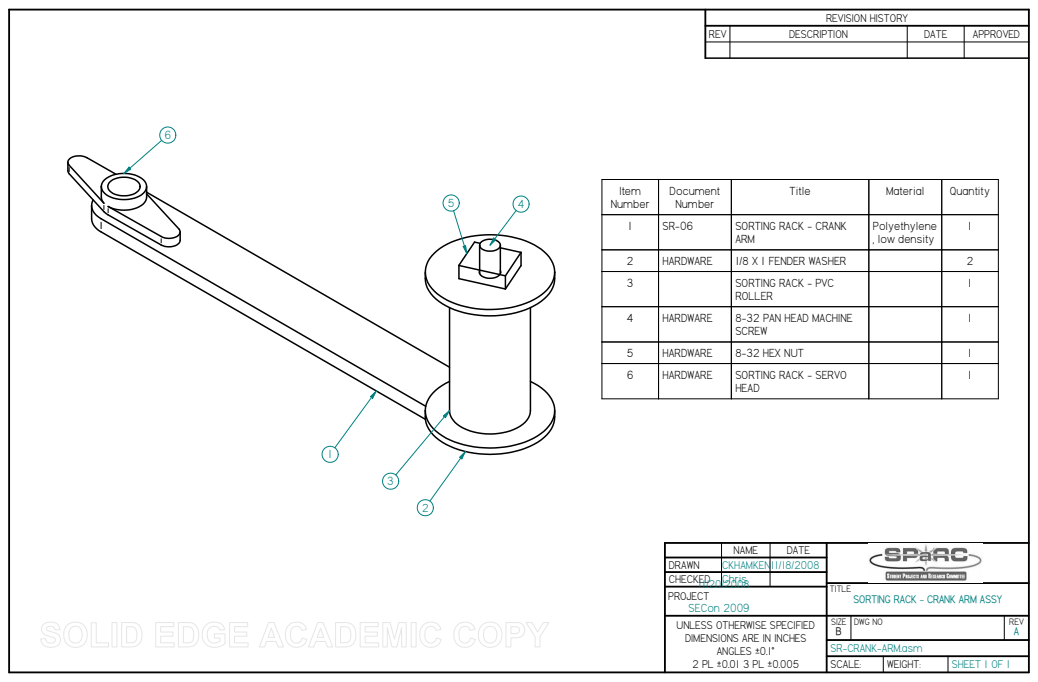
[picture p55: page 1]
DWG NO; REV; SCALE:; WEIGHT:; SHEET 1 OF 1

REVISION HISTORY

REV | DESCRIPTION | DATE | APPROVED

Item Number | Document Number | Title | Material | Quantity

1 | SR-06 | SORTING RACK - CRANK ARM | Polyethylene , low density | 1

2 | HARDWARE | 1/8 X 1 FENDER WASHER | | 2
3 | | SORTING RACK - PVC ROLLER | | 1

4 | HARDWARE | 8-32 PAN HEAD MACHINE SCREW | | 1

5 | HARDWARE | 8-32 HEX NUT | | 1
6 | HARDWARE | SORTING RACK - SERVO HEAD | | 1

NAME | DATE

DRAWN | CKHAMKEN | 11/18/2008
CHECKED | Chris 11/20/2008

TITLE
SORTING RACK - CRANK ARM ASSY

PROJECT
SECon 2009
UNLESS OTHERWISE SPECIFIED
DIMENSIONS ARE IN INCHES
ANGLES ±0.1°

SIZE
SR-CRANK-ARM.asm
