SPARC-Auburn/IEEE-SoutheastCon-2009/Mechanical/Sorting Rack/DRAFTS -- PDF/SR-02.pdf

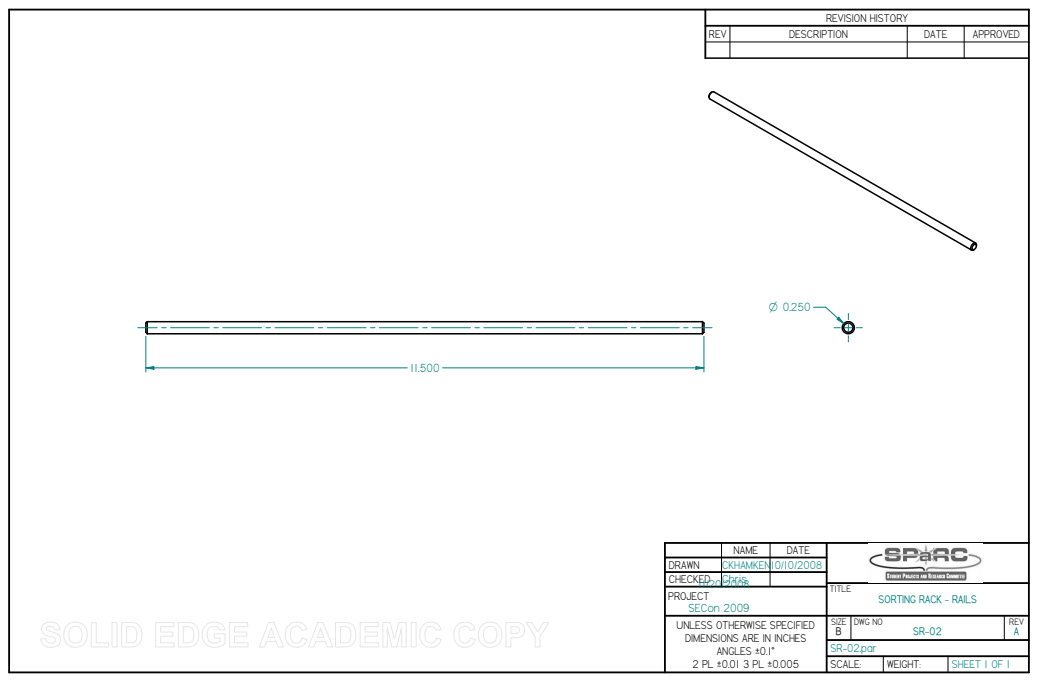
[picture p56: page 1]
TITLE; SIZE B; DWG NO; REV A; SR-02.par; SCALE:; WEIGHT:; SHEET 1 OF 1

REVISION HISTORY

REV | DESCRIPTION | DATE | APPROVED

NAME | DATE

DRAWN | CKHAMKEN | 10/10/2008
CHECKED | Chris 11/20/2008

PROJECT
SECon 2009
UNLESS OTHERWISE SPECIFIED
DIMENSIONS ARE IN INCHES
ANGLES ±0.1°

SORTING RACK - RAILS
