SPARC-Auburn/IEEE-SoutheastCon-2009/Mechanical/Sorting Rack/DRAFTS -- PDF/SR-04.pdf

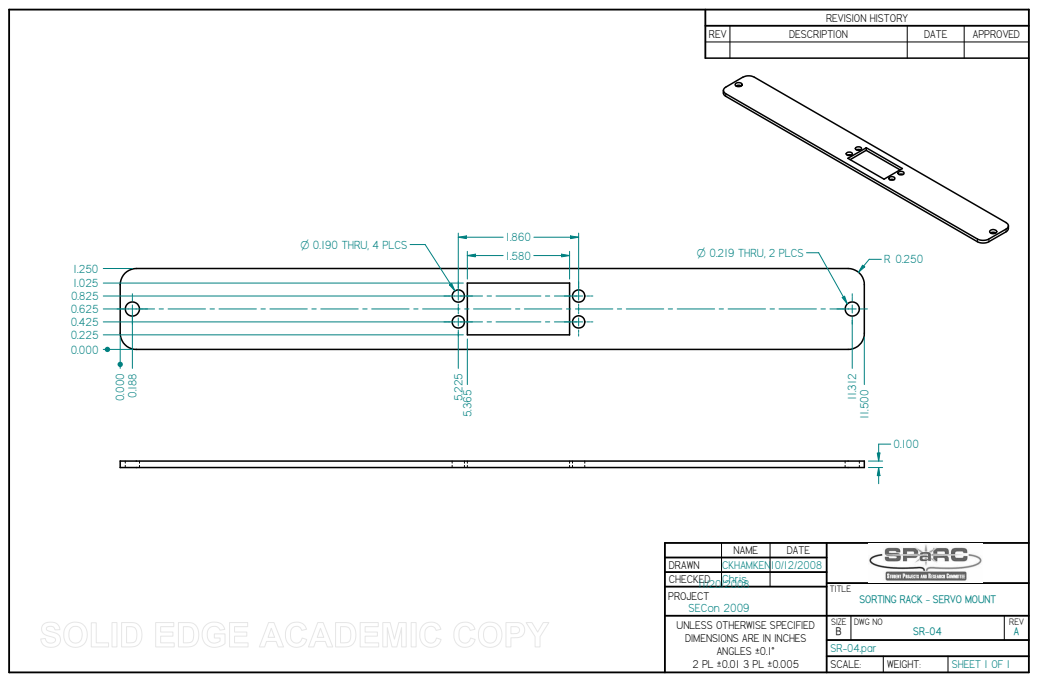
[picture p57: page 1]
SIZE B; DWG NO; REV A; SR-04.par; SCALE:; WEIGHT:; SHEET 1 OF 1; O 0.219 THRU, 2 PLCS; O 0.190 THRU, 4 PLCS

REVISION HISTORY

REV | DESCRIPTION | DATE | APPROVED

NAME | DATE

DRAWN | CKHAMKEN | 10/12/2008
CHECKED | Chris 11/20/2008

TITLE
SORTING RACK - SERVO MOUNT

PROJECT
SECon 2009
UNLESS OTHERWISE SPECIFIED
DIMENSIONS ARE IN INCHES
ANGLES ±0.1°
