SPARC-Auburn/IEEE-SoutheastCon-2009/Mechanical/Sorting Rack/DRAFTS -- PDF/SR-06.pdf

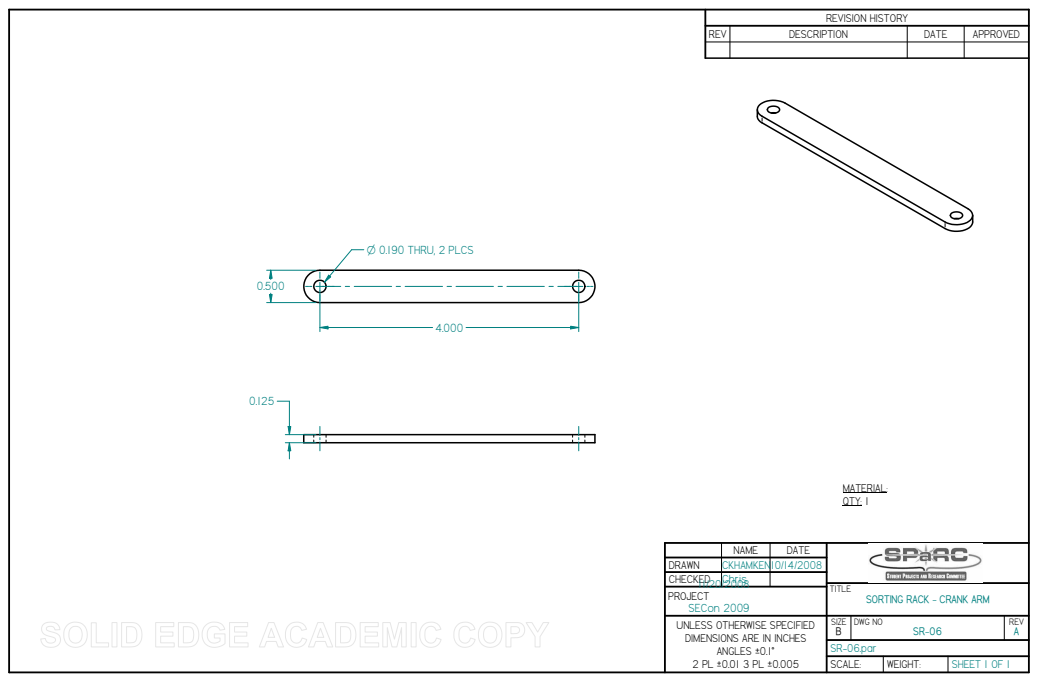
[picture p58: page 1]
TITLE; SIZE B; DWG NO; REV A; SR-06.par; SCALE:; WEIGHT:; SHEET 1 OF 1; O 0.190 THRU, 2 PLCS; MATERIAL: QTY: 1

REVISION HISTORY

REV | DESCRIPTION | DATE | APPROVED

NAME | DATE

DRAWN | CKHAMKEN | 10/14/2008
CHECKED | Chris 11/20/2008

PROJECT
SECon 2009
UNLESS OTHERWISE SPECIFIED
DIMENSIONS ARE IN INCHES
ANGLES ±0.1°

SORTING RACK - CRANK ARM
