SPARC-Auburn/IEEE-SoutheastCon-2009/Mechanical/Sorting Rack/DRAFTS -- PDF/SR-ASSY.pdf

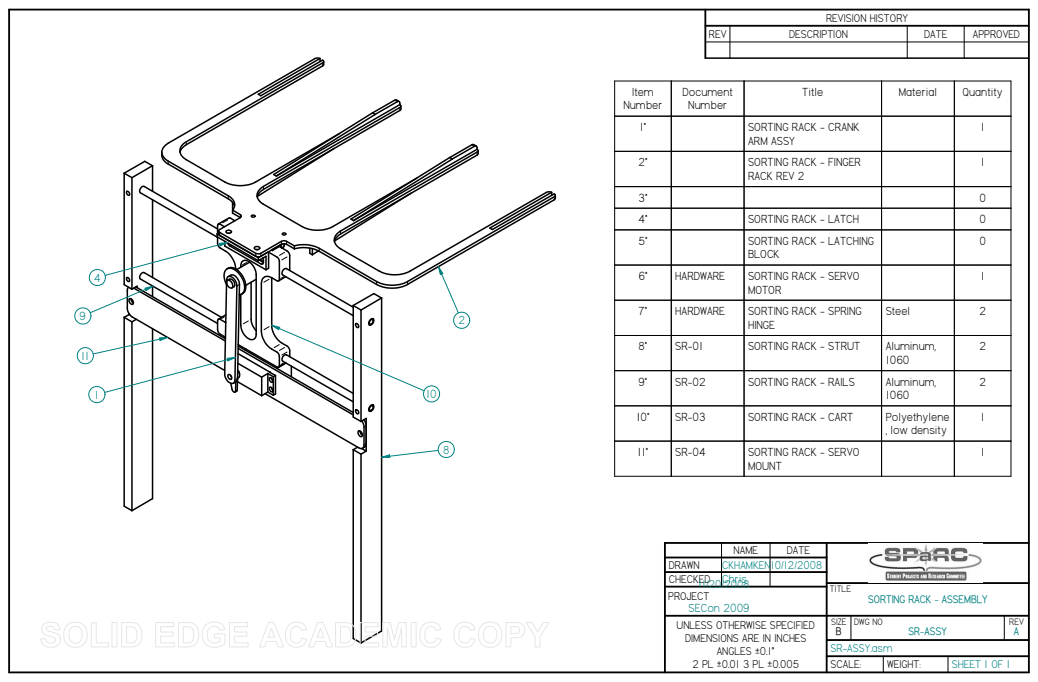
[picture p59: page 1]
TITLE; SIZE B; DWG NO; SR-ASSY; REV A; SR-ASSY.asm; SCALE:; WEIGHT:; SHEET 1 OF 1

REVISION HISTORY

REV | DESCRIPTION | DATE | APPROVED

Item Number | Document Number | Title | Material | Quantity

1* | | SORTING RACK - CRANK ARM ASSY | | 1

2* | | SORTING RACK - FINGER RACK REV 2 | | 1

3* | | | | 0
4* | | SORTING RACK - LATCH | | 0
5* | | SORTING RACK - LATCHING BLOCK | | 0

6* | HARDWARE | SORTING RACK - SERVO MOTOR | | 1

7* | HARDWARE | SORTING RACK - SPRING HINGE | Steel | 2

8* | SR-01 | SORTING RACK - STRUT | Aluminum, 1060 | 2

9* | SR-02 | SORTING RACK - RAILS | Aluminum, 1060 | 2

10* | SR-03 | SORTING RACK - CART | Polyethylene , low density | 1

11* | SR-04 | SORTING RACK - SERVO MOUNT

NAME | DATE

DRAWN | CKHAMKEN | 10/12/2008
CHECKED | Chris 11/20/2008

PROJECT
SECon 2009
UNLESS OTHERWISE SPECIFIED
DIMENSIONS ARE IN INCHES
ANGLES ±0.1°

SORTING RACK - ASSEMBLY
