SPARC-Auburn/IEEE-SoutheastCon-2009/Mechanical/Chassis/DRAFTS -- PDF/CHAS-01.pdf

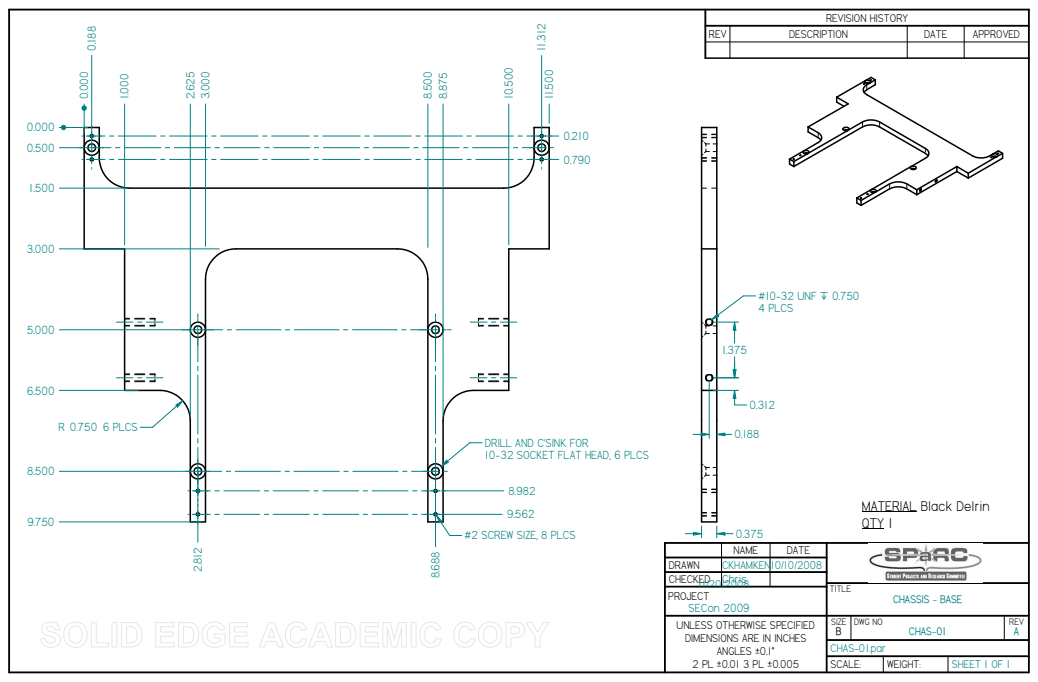
[picture p60: page 1]
TITLE; CHASSIS - BASE; SIZE B; DWG NO; CHAS-01; REV A; CHAS-01.par; SCALE:; WEIGHT:; SHEET 1 OF 1; #10-32 UNF ` 0.750 4 PLCS; R 0.750 6 PLCS

REVISION HISTORY

REV | DESCRIPTION | DATE | APPROVED

DRILL AND C'SINK FOR
10-32 SOCKET FLAT HEAD, 6 PLCS

MATERIAL Black Delrin
QTY 1

#2 SCREW SIZE, 8 PLCS

NAME | DATE

DRAWN | CKHAMKEN | 10/10/2008
CHECKED | Chris 11/20/2008

PROJECT
SECon 2009
UNLESS OTHERWISE SPECIFIED
DIMENSIONS ARE IN INCHES
ANGLES ±0.1°
