SPARC-Auburn/IEEE-SoutheastCon-2009/Mechanical/Chassis/DRAFTS -- PDF/CHAS-02.pdf

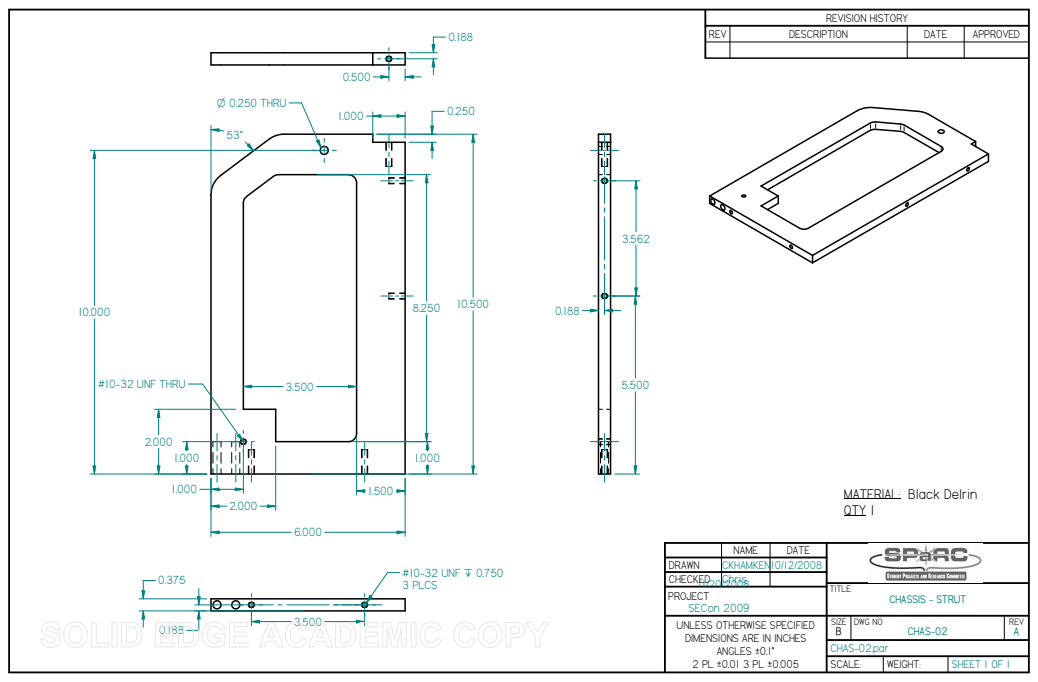
[picture p61: page 1]
TITLE; CHASSIS - STRUT; SIZE B; DWG NO; CHAS-02; REV A; CHAS-02.par; SCALE:; WEIGHT:; SHEET 1 OF 1; #10-32 UNF ` 0.750 3 PLCS; #10-32 UNF THRU; O 0.250 THRU

REVISION HISTORY

REV | DESCRIPTION | DATE | APPROVED

MATERIAL: Black Delrin
QTY 1

NAME | DATE

DRAWN | CKHAMKEN | 10/12/2008
CHECKED | Chris 11/20/2008

PROJECT
SECon 2009
UNLESS OTHERWISE SPECIFIED
DIMENSIONS ARE IN INCHES
ANGLES ±0.1°
