SPARC-Auburn/IEEE-SoutheastCon-2009/Mechanical/Chassis/DRAFTS -- PDF/CHAS-04.pdf

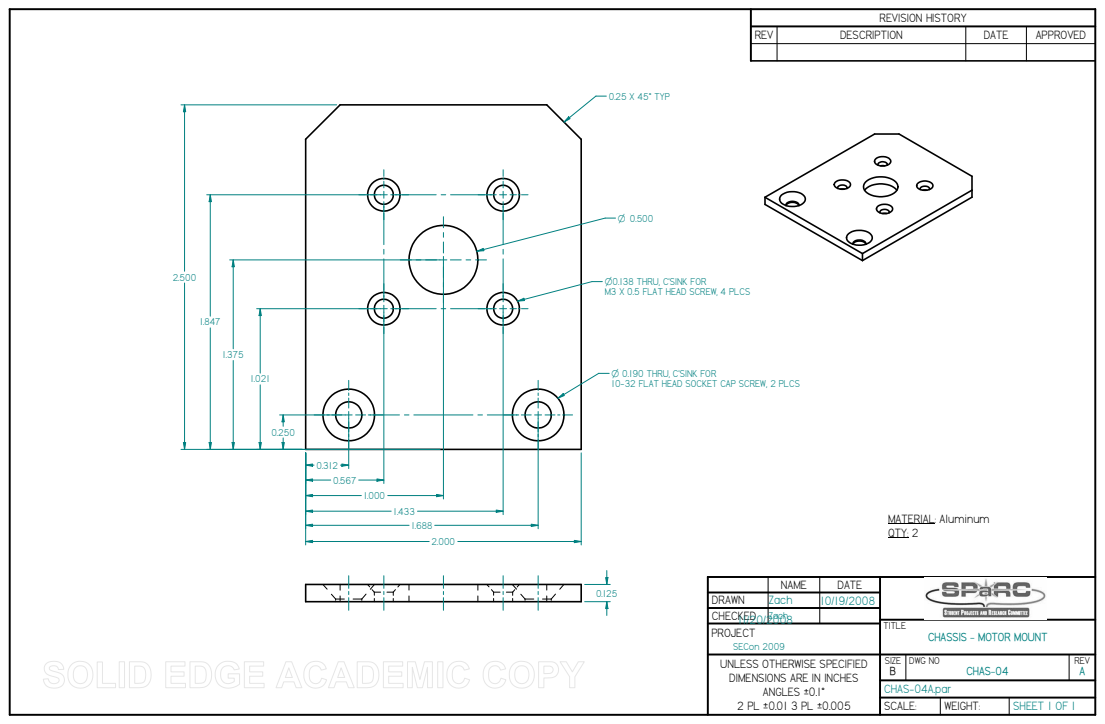
[picture p62: page 1]
TITLE; SIZE B; DWG NO; CHAS-04; REV A; CHAS-04A.par; SCALE:; WEIGHT:; SHEET 1 OF 1; 0.25 X 45v TYP; MATERIAL: Aluminum QTY: 2

REVISION HISTORY

REV | DESCRIPTION | DATE | APPROVED

O0.138 THRU, C'SINK FOR
M3 X 0.5 FLAT HEAD SCREW, 4 PLCS

O 0.190 THRU, C'SINK FOR
10-32 FLAT HEAD SOCKET CAP SCREW, 2 PLCS

NAME | DATE

DRAWN | Zach | 10/19/2008
CHECKED | Zach 11/20/2008

PROJECT
SECon 2009
UNLESS OTHERWISE SPECIFIED
DIMENSIONS ARE IN INCHES
ANGLES ±0.1°

CHASSIS - MOTOR MOUNT
