SPARC-Auburn/IEEE-SoutheastCon-2009/Mechanical/Chassis/DRAFTS -- PDF/CHAS-03.pdf

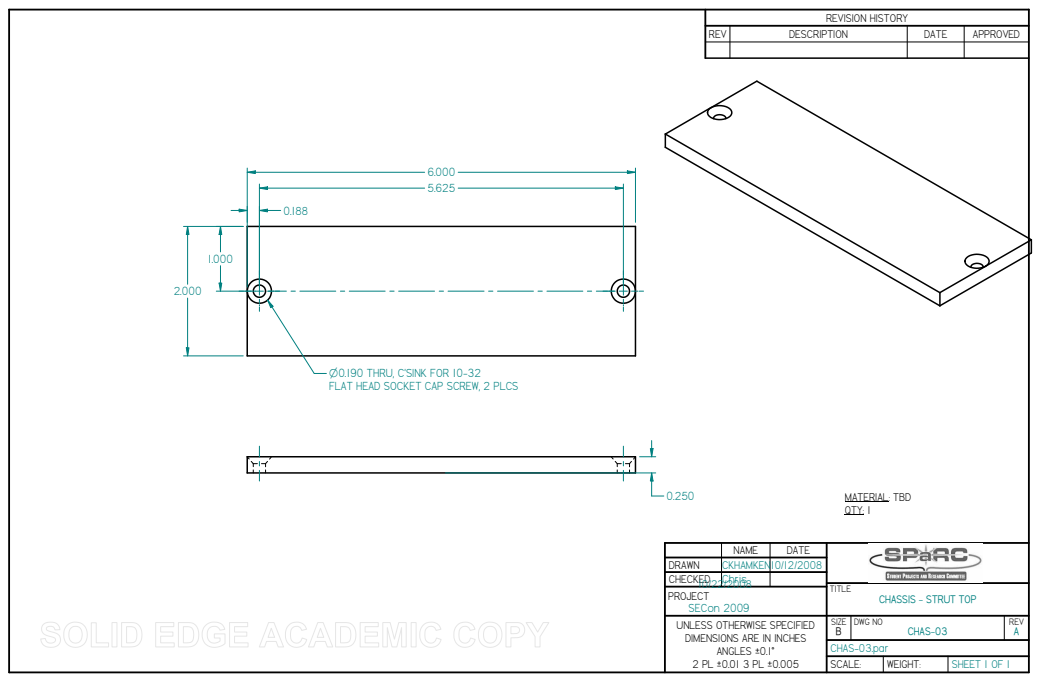
[picture p63: page 1]
TITLE; SIZE B; DWG NO; CHAS-03; REV A; CHAS-03.par; SCALE:; WEIGHT:; SHEET 1 OF 1; MATERIAL: TBD QTY: 1

REVISION HISTORY

REV | DESCRIPTION | DATE | APPROVED

O0.190 THRU, C'SINK FOR 10-32
FLAT HEAD SOCKET CAP SCREW, 2 PLCS

NAME | DATE

DRAWN | CKHAMKEN | 10/12/2008
CHECKED | Chris 10/22/2008

PROJECT
SECon 2009
UNLESS OTHERWISE SPECIFIED
DIMENSIONS ARE IN INCHES
ANGLES ±0.1°

CHASSIS - STRUT TOP
