SPARC-Auburn/IEEE-SoutheastCon-2009/Mechanical/Chassis/DRAFTS -- PDF/CHAS-06.pdf

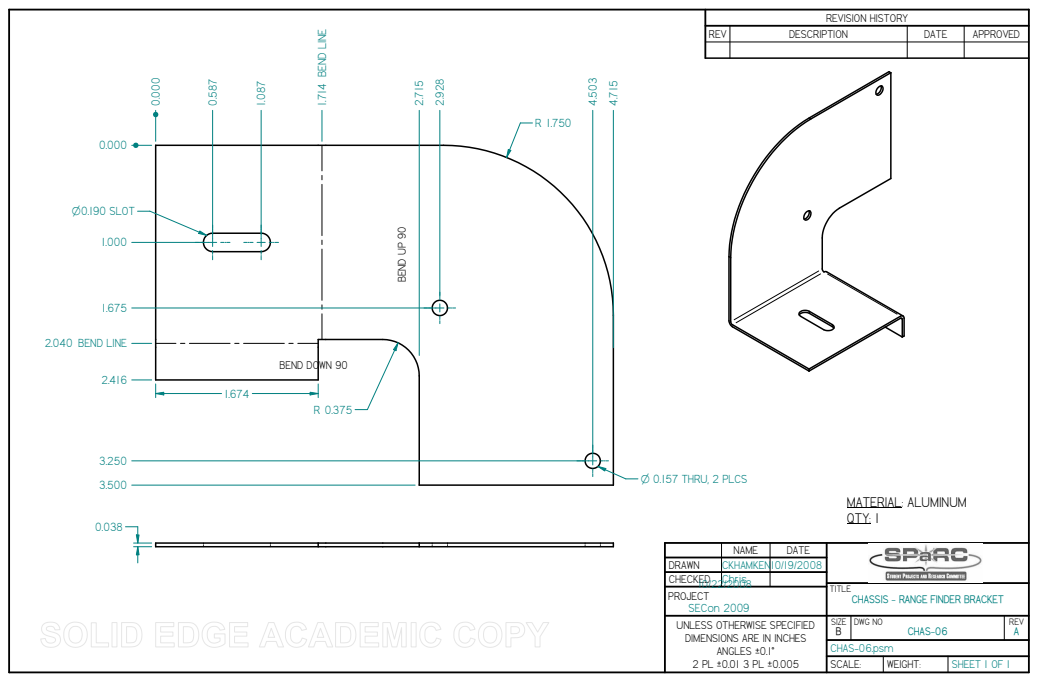
[picture p64: page 1]
SIZE B; DWG NO; CHAS-06; REV A; CHAS-06.psm; SCALE:; WEIGHT:; SHEET 1 OF 1; 1.714 BEND LINE; 2.040 BEND LINE; O 0.157 THRU, 2 PLCS; O0.190 SLOT; BEND DOWN 90; BEND UP 90; MATERIAL: ALUMINUM QTY: 1 0.038

REVISION HISTORY

REV | DESCRIPTION | DATE | APPROVED

NAME | DATE

DRAWN | CKHAMKEN | 10/19/2008
CHECKED | Chris 10/22/2008

TITLE
CHASSIS - RANGE FINDER BRACKET

PROJECT
SECon 2009
UNLESS OTHERWISE SPECIFIED
DIMENSIONS ARE IN INCHES
ANGLES ±0.1°
