SPARC-Auburn/IEEE-SoutheastCon-2009/Mechanical/Chassis/DRAFTS -- PDF/CHAS-ASSY.pdf

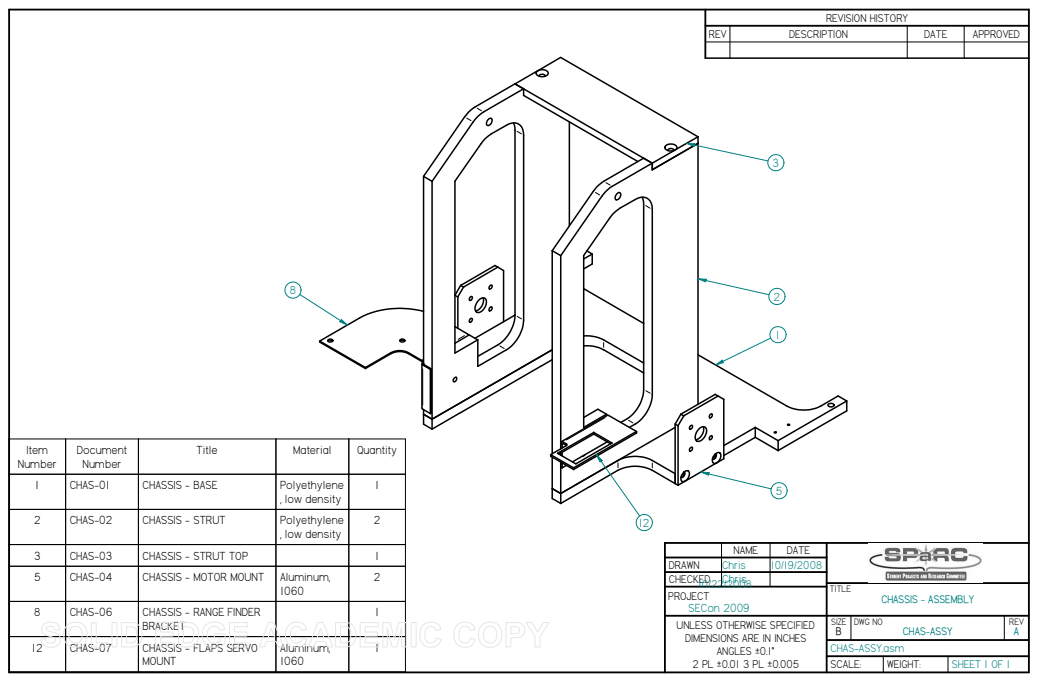
[picture p65: page 1]
NAME; DATE; TITLE; CHASSIS - ASSEMBLY; SIZE B; DWG NO; CHAS-ASSY; REV A; CHAS-ASSY.asm; CHAS-03; CHASSIS - STRUT TOP

REVISION HISTORY

REV | DESCRIPTION | DATE | APPROVED

Item Number | Document Number | Title | Material | Quantity

1 | CHAS-01 | CHASSIS - BASE | Polyethylene , low density | 1

2 | CHAS-02 | CHASSIS - STRUT | Polyethylene , low density | 2

DRAWN | Chris | 10/19/2008
CHECKED | Chris 10/22/2008

5 | CHAS-04 | CHASSIS - MOTOR MOUNT | Aluminum, 1060 | 2

PROJECT
SECon 2009
UNLESS OTHERWISE SPECIFIED
DIMENSIONS ARE IN INCHES
ANGLES ±0.1°

8 | CHAS-06 | CHASSIS - RANGE FINDER BRACKET | | 1

12 | CHAS-07 | CHASSIS - FLAPS SERVO MOUNT | Aluminum, 1060 | 1

SCALE: | WEIGHT: | SHEET 1 OF 1
