SPARC-Auburn/IEEE-SoutheastCon-2009/Mechanical/Sorting Rack/DRAFTS -- PDF/Sorting_Rack_Detail_Drawings.pdf

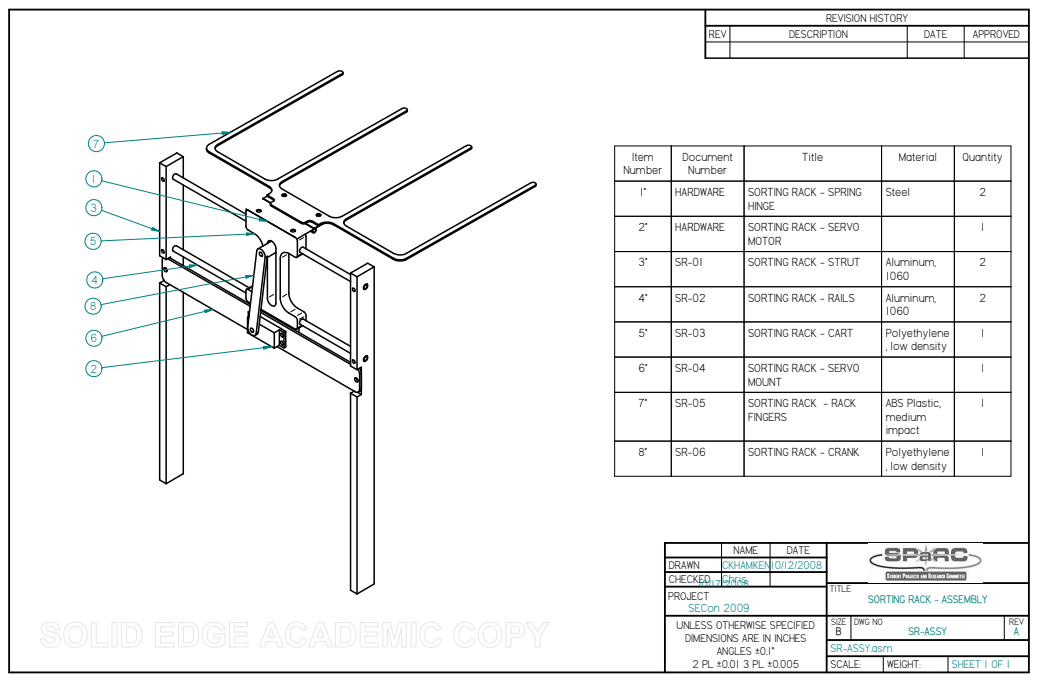
[picture p66: page 1]
TITLE; SIZE B; DWG NO; SR-ASSY; REV A; SR-ASSY.asm; SCALE:; WEIGHT:; SHEET 1 OF 1

REVISION HISTORY

REV | DESCRIPTION | DATE | APPROVED

Item Number | Document Number | Title | Material | Quantity

1* | HARDWARE | SORTING RACK - SPRING HINGE | Steel | 2

2* | HARDWARE | SORTING RACK - SERVO MOTOR | | 1

3* | SR-01 | SORTING RACK - STRUT | Aluminum, 1060 | 2

4* | SR-02 | SORTING RACK - RAILS | Aluminum, 1060 | 2

5* | SR-03 | SORTING RACK - CART | Polyethylene , low density | 1

6* | SR-04 | SORTING RACK - SERVO MOUNT | | 1

7* | SR-05 | SORTING RACK - RACK FINGERS | ABS Plastic, medium impact | 1

8* | SR-06 | SORTING RACK - CRANK | Polyethylene , low density | 1

NAME | DATE

DRAWN | CKHAMKEN | 10/12/2008
CHECKED | Chris 10/17/2008

PROJECT
SECon 2009
UNLESS OTHERWISE SPECIFIED
DIMENSIONS ARE IN INCHES
ANGLES ±0.1°

SORTING RACK - ASSEMBLY

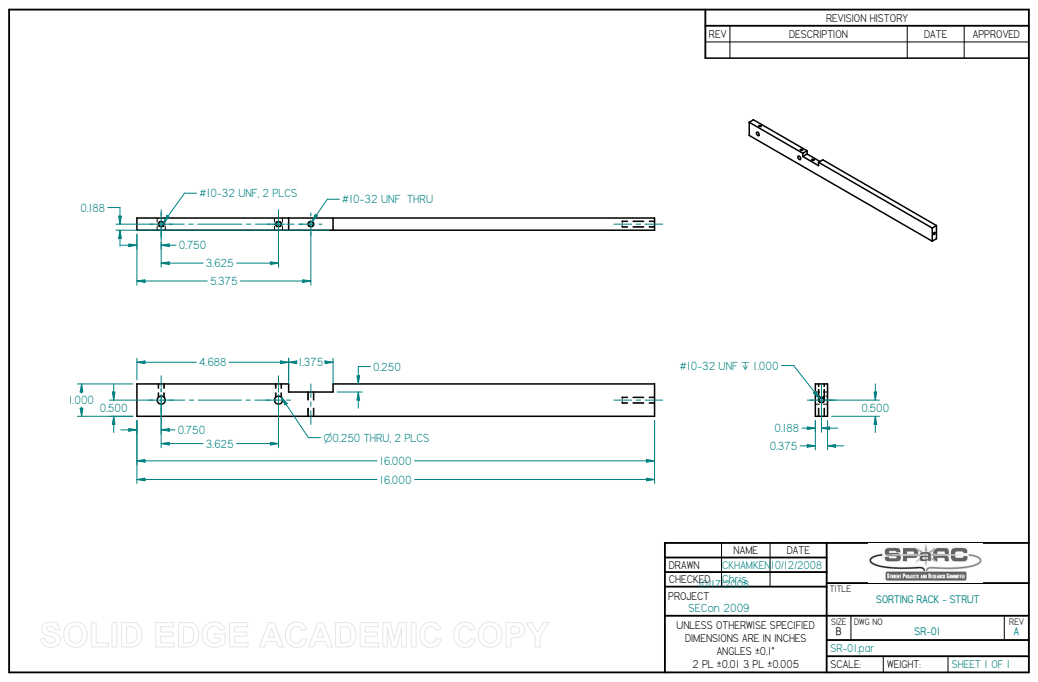
[picture p67: page 2]
TITLE; SIZE B; DWG NO; REV A; SR-01.par; O0.250 THRU, 2 PLCS; #10-32 UNF, 2 PLCS; #10-32 UNF ` 1.000; #10-32 UNF THRU

NAME | DATE

DRAWN | CKHAMKEN | 10/12/2008
CHECKED | Chris 10/17/2008

PROJECT
SECon 2009
UNLESS OTHERWISE SPECIFIED
DIMENSIONS ARE IN INCHES

SORTING RACK - STRUT

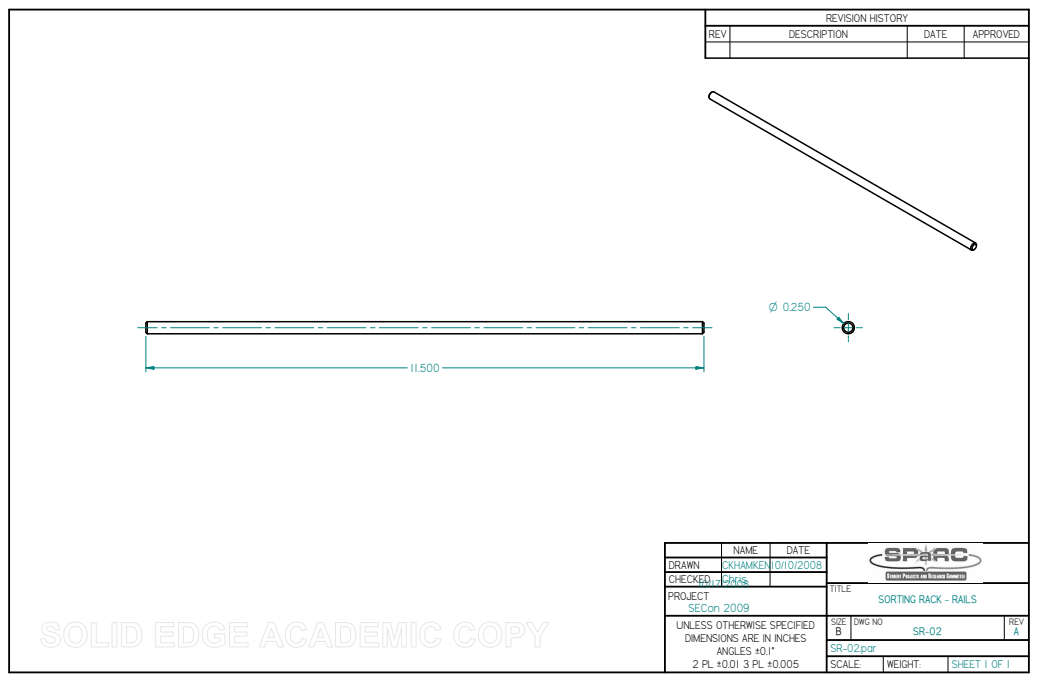
[picture p68: page 3]
TITLE; SIZE B; DWG NO; REV A; SR-02.par

NAME | DATE

DRAWN | CKHAMKEN | 10/10/2008
CHECKED | Chris 10/17/2008

PROJECT
SECon 2009
UNLESS OTHERWISE SPECIFIED
DIMENSIONS ARE IN INCHES

SORTING RACK - RAILS

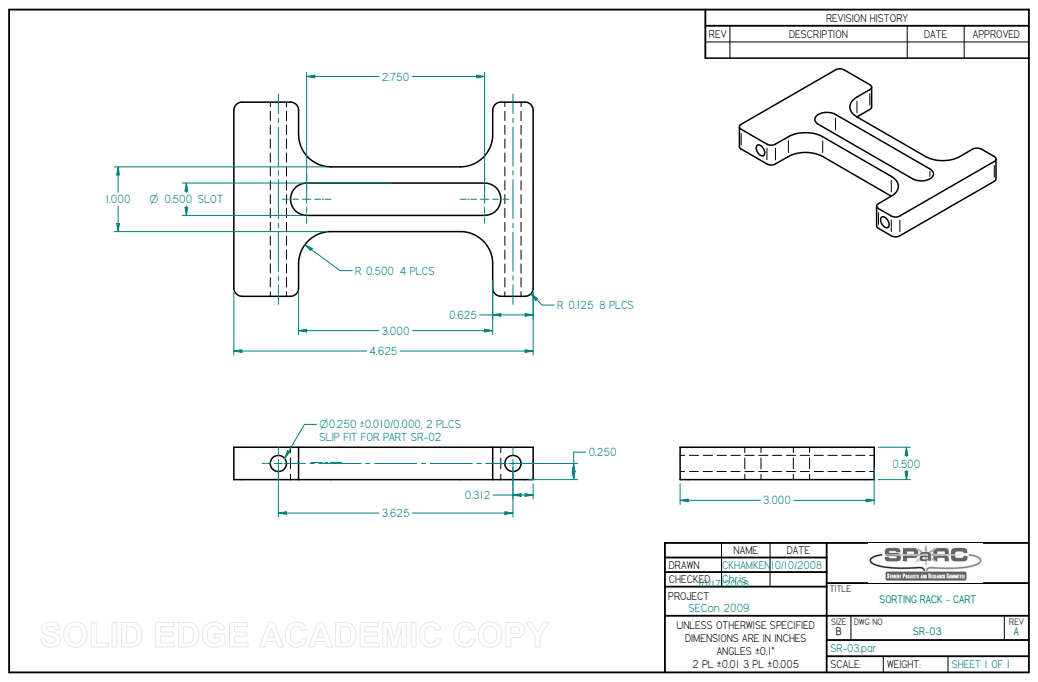
[picture p69: page 4]
TITLE; SIZE B; DWG NO; REV A; SR-03.par; O 0.500 SLOT; R 0.500 4 PLCS; R 0.125 8 PLCS

O0.250 u0.010/0.000, 2 PLCS
SLIP FIT FOR PART SR-02

NAME | DATE

DRAWN | CKHAMKEN | 10/10/2008
CHECKED | Chris 10/17/2008

PROJECT
SECon 2009
UNLESS OTHERWISE SPECIFIED
DIMENSIONS ARE IN INCHES

SORTING RACK - CART

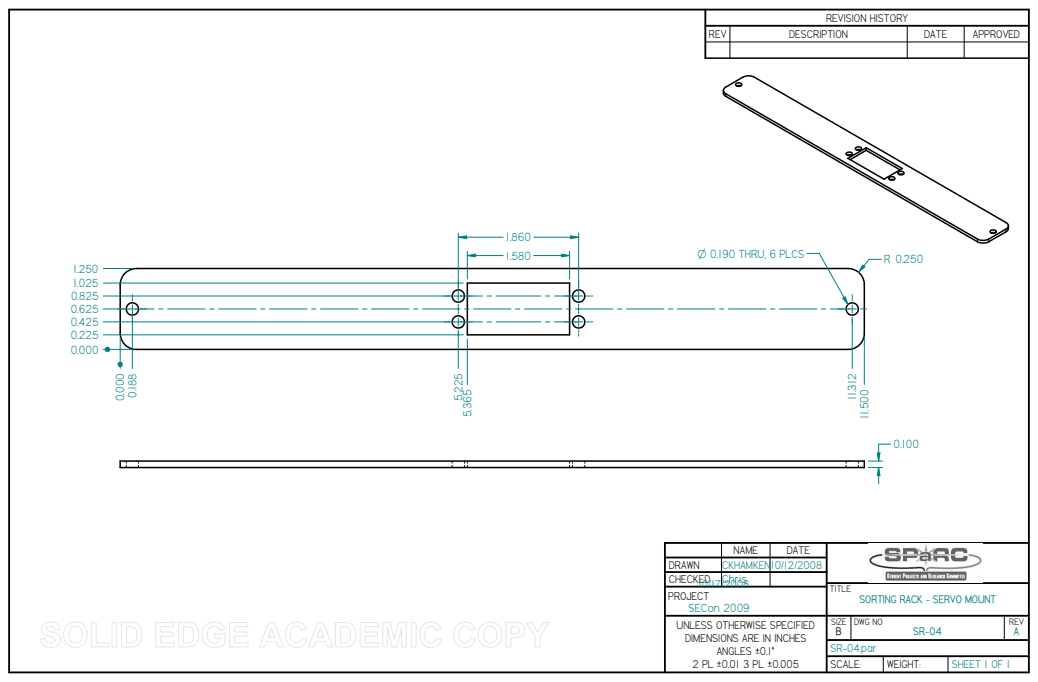
[picture p70: page 5]
SIZE B; DWG NO; REV A; SR-04.par; O 0.190 THRU, 6 PLCS

NAME | DATE

DRAWN | CKHAMKEN | 10/12/2008
CHECKED | Chris 10/17/2008

TITLE
SORTING RACK - SERVO MOUNT

PROJECT
SECon 2009
UNLESS OTHERWISE SPECIFIED
DIMENSIONS ARE IN INCHES

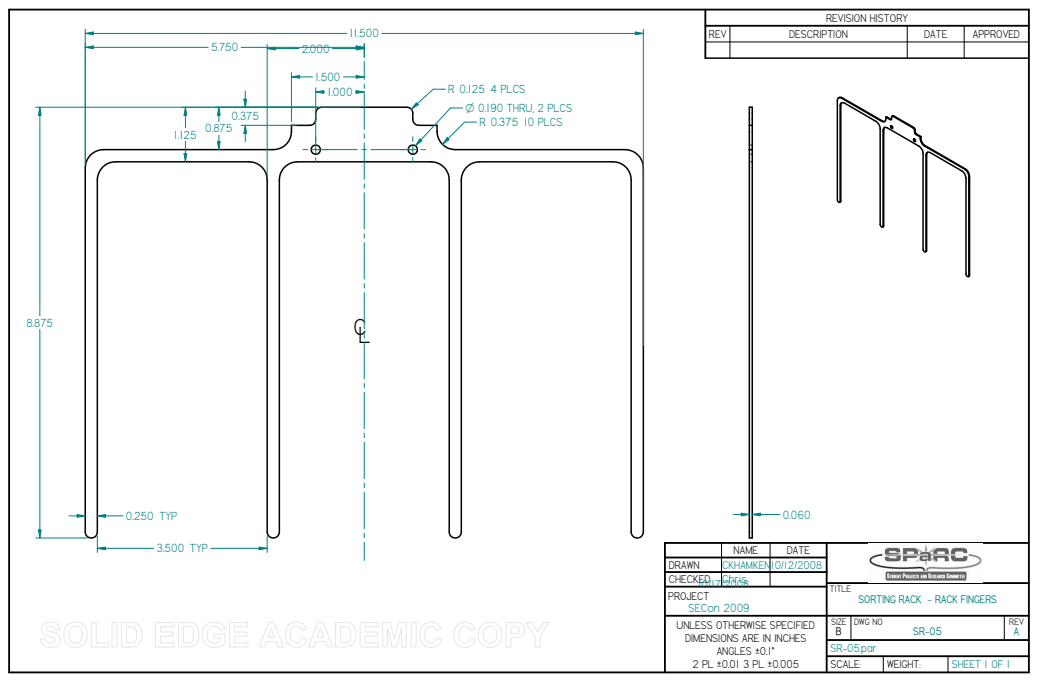
[picture p71: page 6]
SIZE B; DWG NO; REV A; SR-05.par; 0.250 TYP; 3.500 TYP; O 0.190 THRU, 2 PLCS R 0.375 10 PLCS; R 0.125 4 PLCS

NAME | DATE

DRAWN | CKHAMKEN | 10/12/2008
CHECKED | Chris 10/17/2008

TITLE
SORTING RACK - RACK FINGERS

PROJECT
SECon 2009
UNLESS OTHERWISE SPECIFIED
DIMENSIONS ARE IN INCHES

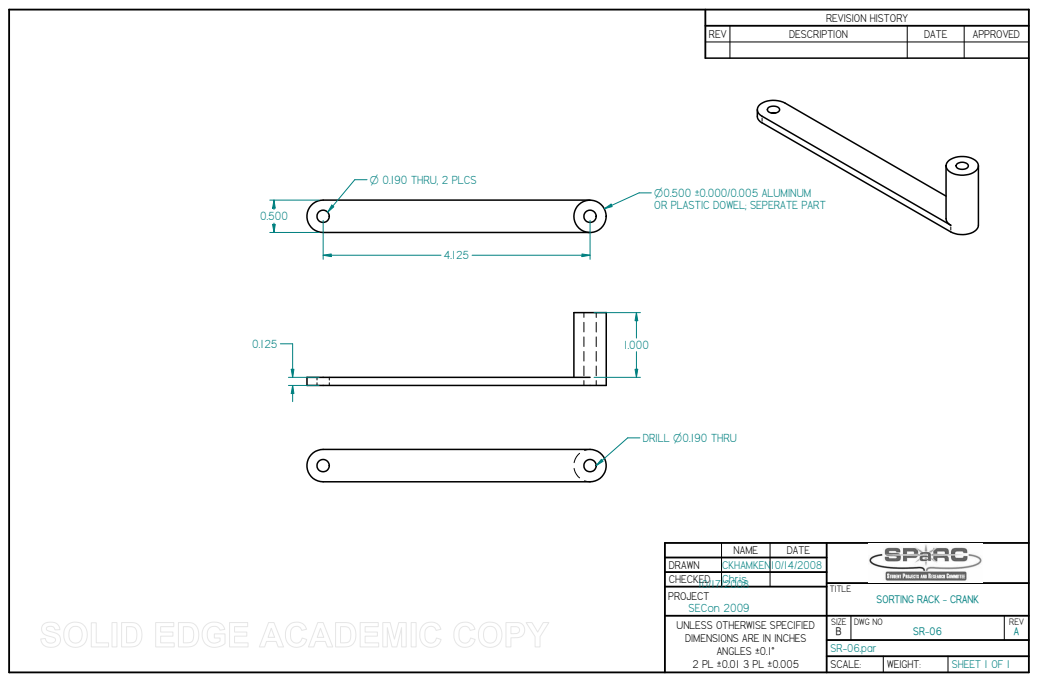
[picture p72: page 7]
TITLE; SIZE B; DWG NO; REV A; SR-06.par; O 0.190 THRU, 2 PLCS; DRILL O0.190 THRU

O0.500 u0.000/0.005 ALUMINUM
OR PLASTIC DOWEL; SEPERATE PART

NAME | DATE

DRAWN | CKHAMKEN | 10/14/2008
CHECKED | Chris 10/17/2008

PROJECT
SECon 2009
UNLESS OTHERWISE SPECIFIED
DIMENSIONS ARE IN INCHES

SORTING RACK - CRANK
