SPARC-Auburn/IEEE-SoutheastCon-2009/Mechanical/SPaRC Draft Template.pdf

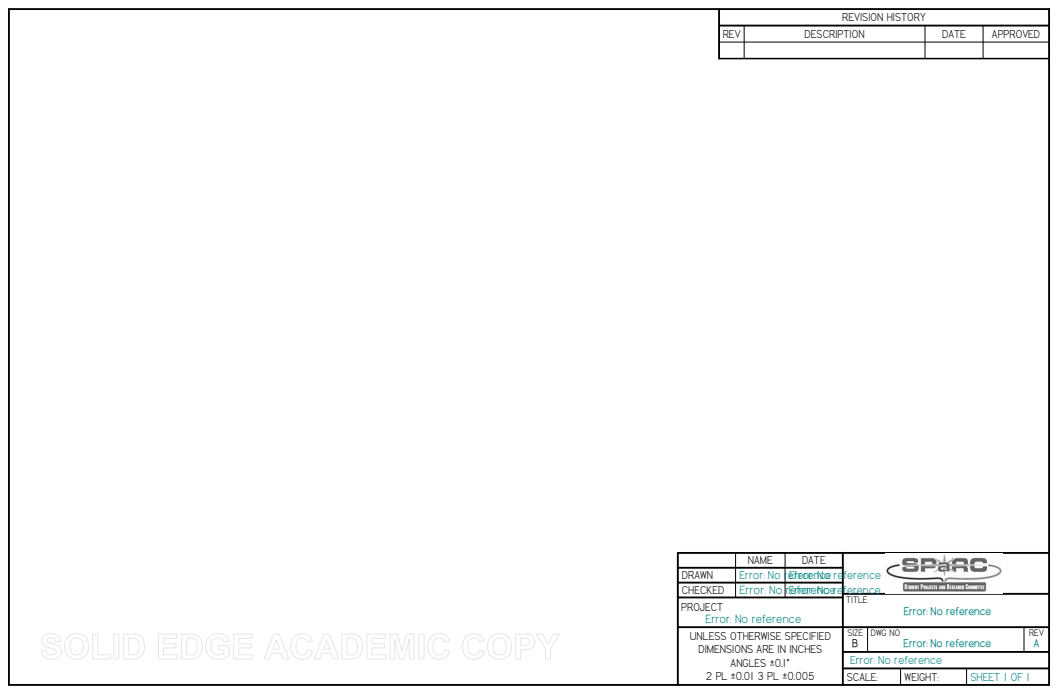
[picture p73: page 1]
TITLE; SIZE B; DWG NO; REV A; Error: No reference; SCALE:; WEIGHT:; SHEET 1 OF 1

REVISION HISTORY

REV | DESCRIPTION | DATE | APPROVED

NAME | DATE

DRAWN | Error: No reference | Error: No reference
CHECKED | Error: No reference

PROJECT
Error: No reference
UNLESS OTHERWISE SPECIFIED
DIMENSIONS ARE IN INCHES
ANGLES ±0.1°
