SPARC-Auburn/IEEE-SoutheastCon-2009/Mechanical/End Effector/END-01a.pdf

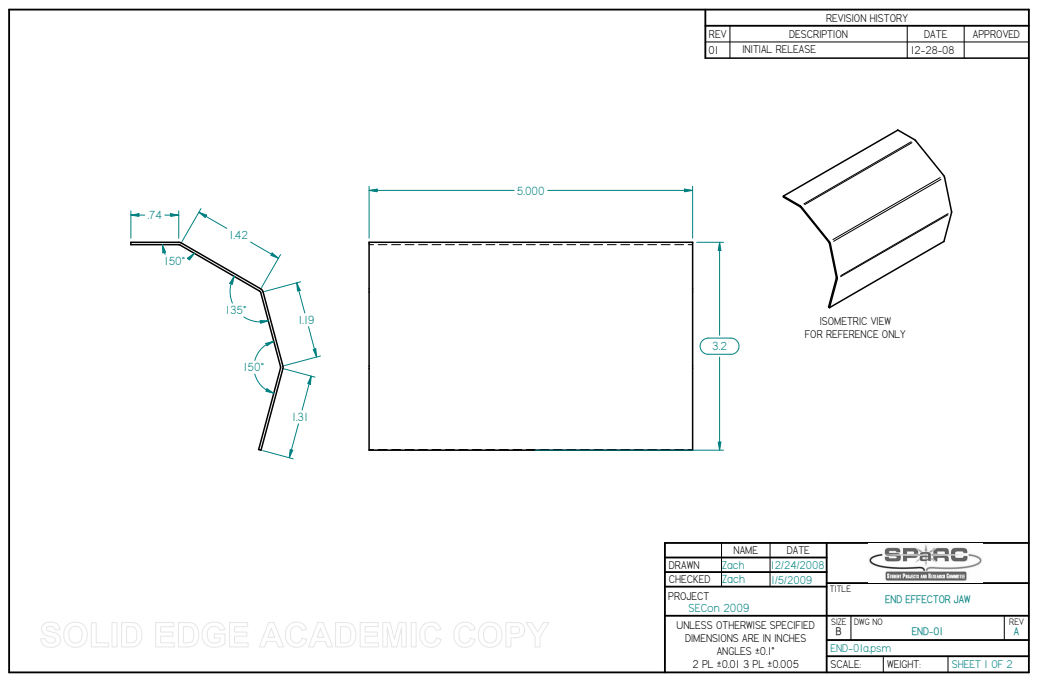
[picture p74: page 1]
TITLE; SIZE B; DWG NO; END-01; REV A; END-01a.psm; SCALE:; WEIGHT:; SHEET 1 OF 2

REVISION HISTORY

REV | DESCRIPTION | DATE | APPROVED
01 | INITIAL RELEASE | 12-28-08

ISOMETRIC VIEW
FOR REFERENCE ONLY

NAME | DATE

DRAWN | Zach | 12/24/2008
CHECKED | Zach | 1/5/2009

PROJECT
SECon 2009
UNLESS OTHERWISE SPECIFIED
DIMENSIONS ARE IN INCHES
ANGLES ±0.1°

END EFFECTOR JAW

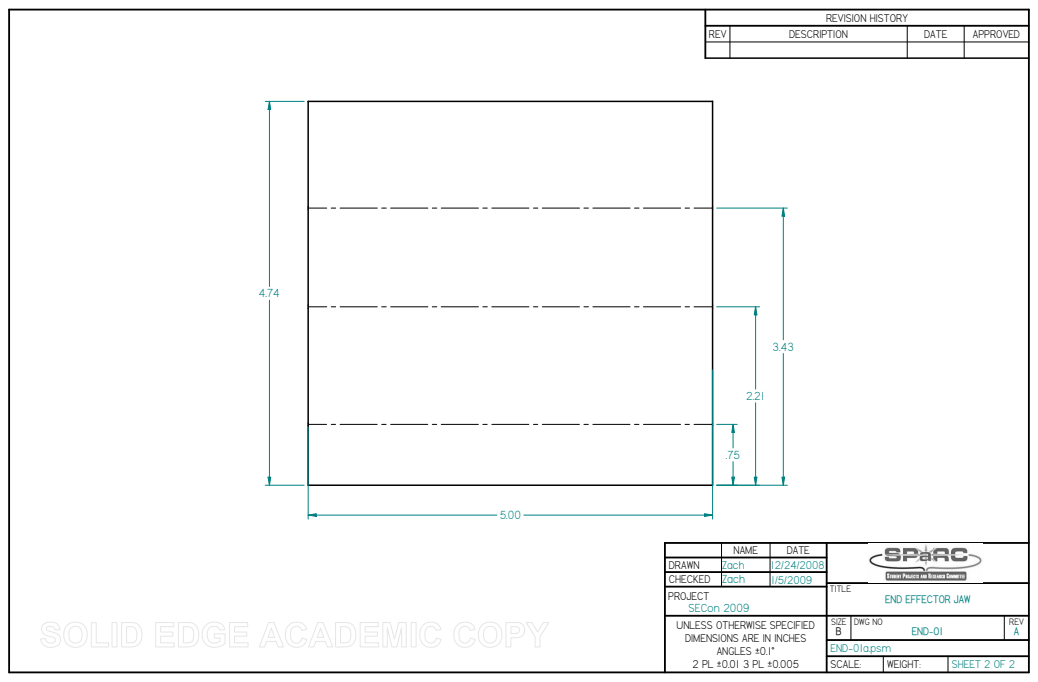
[picture p75: page 2]
TITLE; SIZE B; DWG NO; END-01; REV A; END-01a.psm; SCALE:; WEIGHT:; SHEET 2 OF 2

REVISION HISTORY

REV | DESCRIPTION | DATE | APPROVED

NAME | DATE

DRAWN | Zach | 12/24/2008
CHECKED | Zach | 1/5/2009

PROJECT
SECon 2009
UNLESS OTHERWISE SPECIFIED
DIMENSIONS ARE IN INCHES
ANGLES ±0.1°

END EFFECTOR JAW
