SPARC-Auburn/IEEE-SoutheastCon-2009/Mechanical/Sorting Rack/DRAFTS -- PDF/SR-06a.pdf

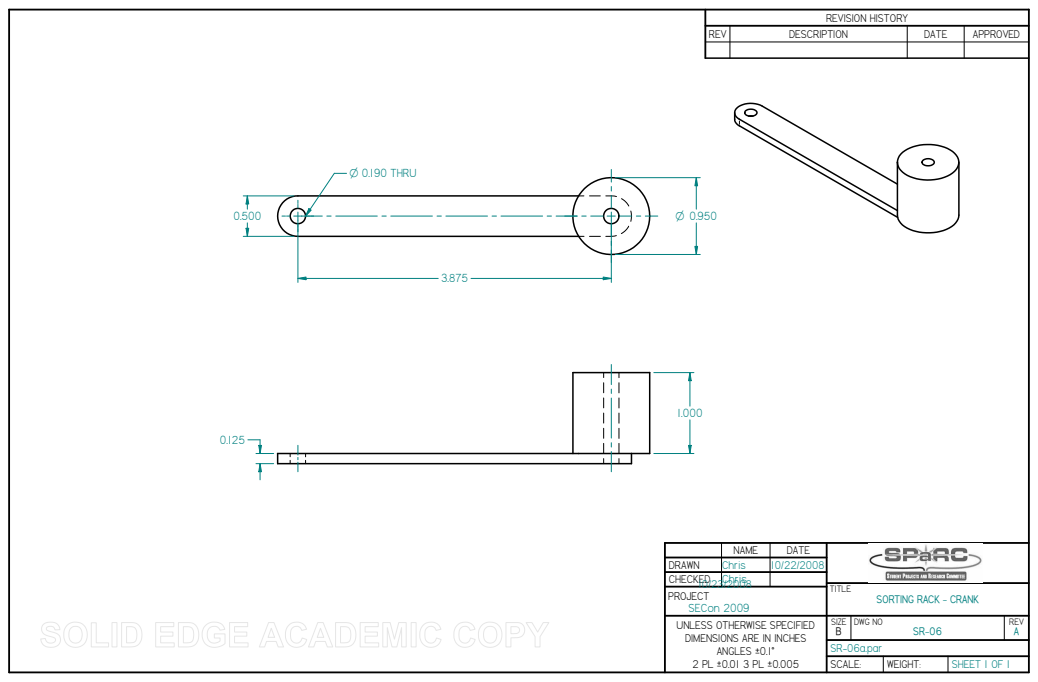
[picture p76: page 1]
TITLE; SIZE B; DWG NO; REV A; SR-06a.par; SCALE:; WEIGHT:; SHEET 1 OF 1; O 0.190 THRU

REVISION HISTORY

REV | DESCRIPTION | DATE | APPROVED

NAME | DATE

DRAWN | Chris | 10/22/2008
CHECKED | Chris 10/23/2008

PROJECT
SECon 2009
UNLESS OTHERWISE SPECIFIED
DIMENSIONS ARE IN INCHES
ANGLES ±0.1°

SORTING RACK - CRANK
