SPARC-Auburn/IEEE-SoutheastCon-2009/Mechanical/Sorting Rack/DRAFTS -- PDF/SR-01.pdf

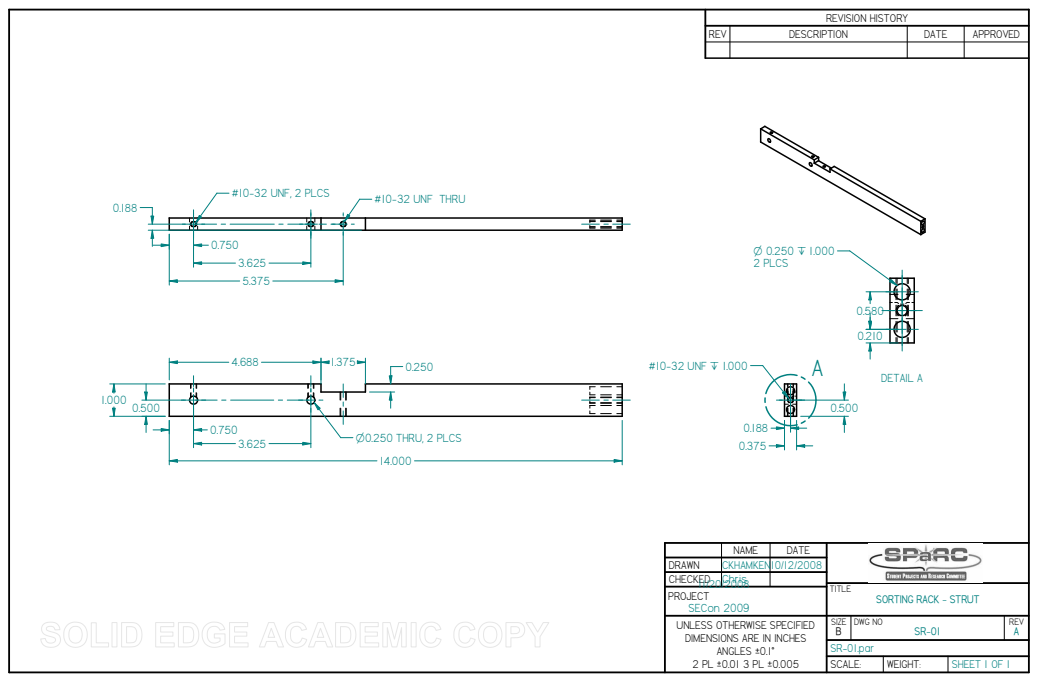
[picture p77: page 1]
TITLE; SIZE B; DWG NO; REV A; SR-01.par; SCALE:; WEIGHT:; SHEET 1 OF 1; O0.250 THRU, 2 PLCS; #10-32 UNF ` 1.000; DETAIL A; O 0.250 ` 1.000 2 PLCS

#10-32 UNF, 2 PLCS #10-32 UNF THRU | REVISION HISTORY

REV | DESCRIPTION | DATE | APPROVED

NAME | DATE

DRAWN | CKHAMKEN | 10/12/2008
CHECKED | Chris 11/20/2008

PROJECT
SECon 2009
UNLESS OTHERWISE SPECIFIED
DIMENSIONS ARE IN INCHES
ANGLES ±0.1°

SORTING RACK - STRUT
