SPARC-Auburn/IEEE-SoutheastCon-2009/Mechanical/Sorting Rack/DRAFTS -- PDF/SR-03.pdf

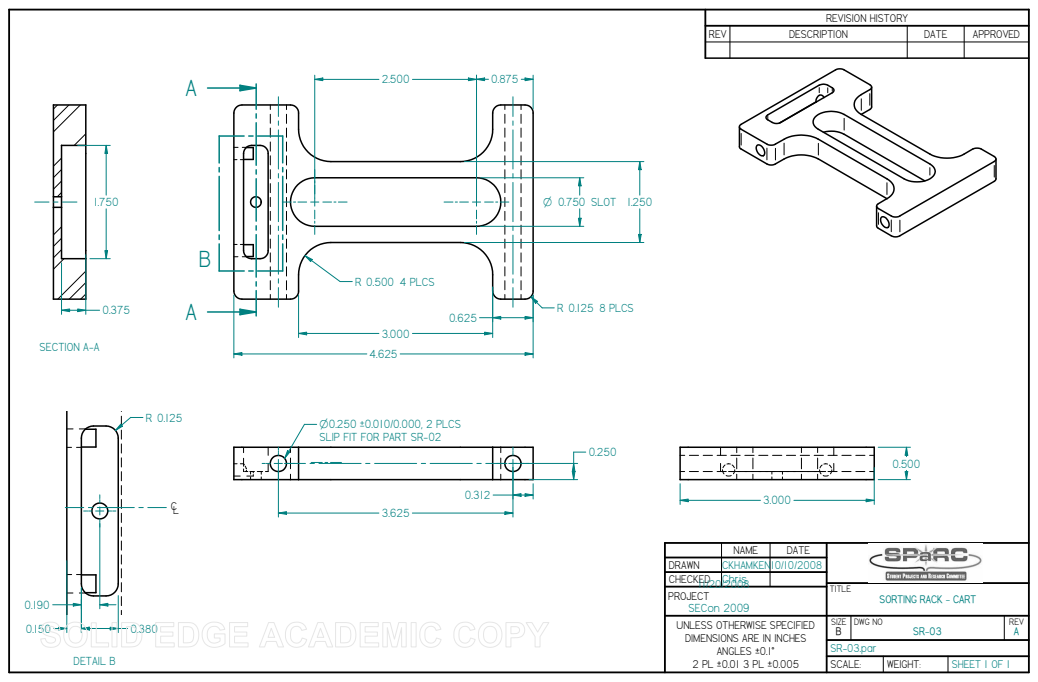
[picture p78: page 1]
TITLE; SIZE B; DWG NO; REV A; SR-03.par; SCALE:; WEIGHT:; SHEET 1 OF 1; R 0.500 4 PLCS; R 0.125 8 PLCS; O 0.750 SLOT 1.250; SECTION A-A; DETAIL B

REVISION HISTORY

REV | DESCRIPTION | DATE | APPROVED

O0.250 u0.010/0.000, 2 PLCS
SLIP FIT FOR PART SR-02

NAME | DATE

DRAWN | CKHAMKEN | 10/10/2008
CHECKED | Chris 11/20/2008

PROJECT
SECon 2009
UNLESS OTHERWISE SPECIFIED
DIMENSIONS ARE IN INCHES
ANGLES ±0.1°

SORTING RACK - CART
