SPARC-Auburn/IEEE-SoutheastCon-2009/Mechanical/Sorting Rack/DRAFTS -- PDF/SR-05.pdf

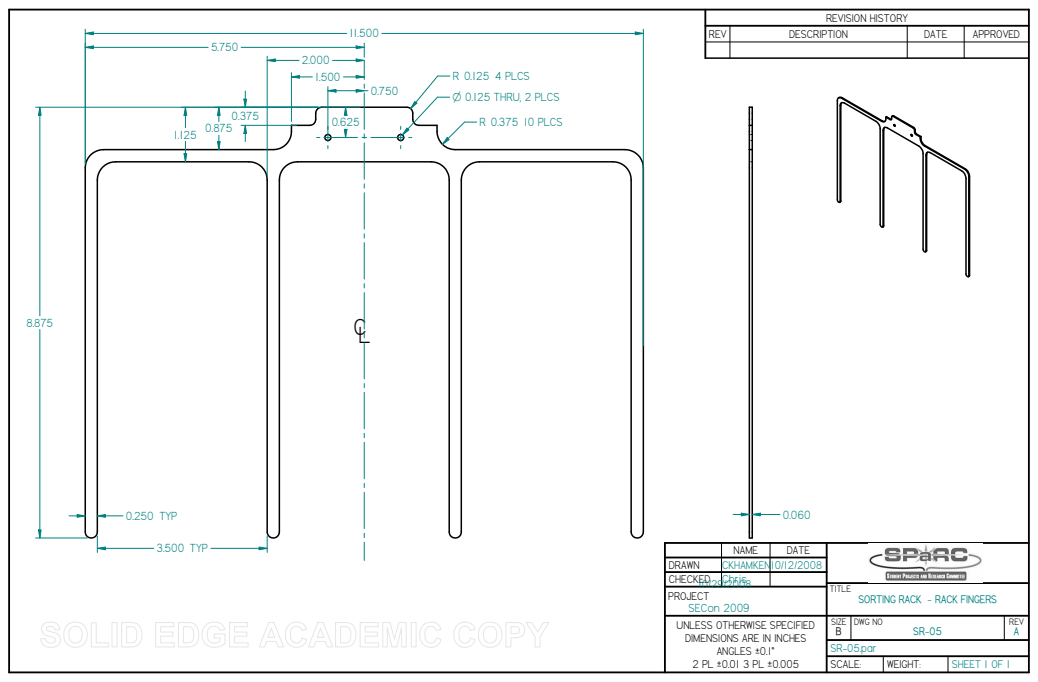
[picture p79: page 1]
SIZE B; DWG NO; REV A; SR-05.par; SCALE:; WEIGHT:; SHEET 1 OF 1; 0.250 TYP; 3.500 TYP; O 0.125 THRU, 2 PLCS; R 0.375 10 PLCS; R 0.125 4 PLCS

REVISION HISTORY

REV | DESCRIPTION | DATE | APPROVED

NAME | DATE

DRAWN | CKHAMKEN | 10/12/2008
CHECKED | Chris 10/29/2008

TITLE
SORTING RACK - RACK FINGERS

PROJECT
SECon 2009
UNLESS OTHERWISE SPECIFIED
DIMENSIONS ARE IN INCHES
ANGLES ±0.1°
