SPARC-Auburn/IEEE-SoutheastCon-2009/(list of files, drawings)

Other design files:
Schematics/Antenna Array Schematics/DOG_FENCE_DETECTOR_ANTENNA_ARRAY.DSN
Schematics/Antenna Array Schematics/Dog_Fence_Detector_Antenna_Array.opj
Schematics/Antenna Array Schematics/LIBRARY1.OLB
Schematics/LIBRARY1.OLB
Schematics/MASTER_NODE.DSN
Schematics/Master_Node.opj
