SPARC-Auburn/IEEE-SoutheastCon-2009/Code/Firmware/PIC/SERVO/main.c

//************************************************************************************************
//	Node:		Servo Controller
//	Author:		Michael Carroll
//				m@auburn.edu
//	
//	Purpose:	Control 4 hobby servos using a version of PWM.
//
//	Command Format:
//		<byte 0>	Servo Number (1-4)
//		<byte 1>	Servo position high byte
//		<byte 2>	Servo position low byte
//
//	Connections:
//		Pin 2 (PORTA_PIN0)	-	Servo 1
//		Pin 3 (PORTA_PIN1)	-	Servo 2
//		Pin 4 (PORTA_PIN2)	-	Servo 3
//		Pin 5 (PORTA_PIN3)	-	Servo 4
//************************************************************************************************

#include "main.h"
#include "init.h"
#include "serial.h"
#include "hardware.h"
#include "queue.h"

// Use Internal Oscillator, Watchdog Timer, MCLR, and Brown Out Detect
#pragma config OSC = IRCIO67
#pragma config WDT = ON, WDTPS=32768
#pragma config MCLRE = ON


#pragma code high_vector=0x08
void high_vec(void)
{
	_asm goto high_isr _endasm
}


#pragma code low_vector=0x18
void low_vec (void)
{
   _asm goto low_isr _endasm
}

#pragma code

// Define Variables
union Servo servo[4];
unsigned int timer1_reload, timer3_reload;
unsigned char timer1_mask, timer3_mask;

unsigned char pwm_deadband = 15;		// Default value, can be varied through serial

//***************************************************************************************************************
//							high_isr
//***************************************************************************************************************

#pragma interrupt high_isr
void high_isr(void)
{
	if(PIR1bits.TXIF || PIR1bits.RCIF)
	{
		SerialISR();
	}	
}

//***************************************************************************************************************
//							low_isr
//***************************************************************************************************************

#pragma interruptlow low_isr
void low_isr (void)
{	
	if(PIR1bits.TMR1IF)
	{
		LATA &= timer1_mask;
		if(timer1_reload != 0)
		{
			WriteTimer1(timer1_reload);
			timer1_mask = SERVO0 & SERVO1;
		}	
		else
		{
			T1CONbits.TMR1ON = 0;
			timer1_reload = 0;
		}	
		PIR1bits.TMR1IF = 0;
		return;
	}
	else if(PIR2bits.TMR3IF)
	{
		LATA &= timer3_mask;
		if(timer3_reload != 0)
		{
			WriteTimer3(timer3_reload);
			timer3_mask = SERVO2 & SERVO3;
		}	
		else
		{
			T3CONbits.TMR3ON = 0;
			timer3_reload = 0;
		}	
		PIR2bits.TMR3IF = 0;
		return;
	}	
	else if(INTCONbits.TMR0IF)	// If - Timer 0
	{
		if(servo[0].lt > (servo[1].lt + pwm_deadband))
		{
			WriteTimer1(0xFFFF - servo[1].lt);
			timer1_reload = 0xFFFF - (servo[0].lt - servo[1].lt);
			timer1_mask = SERVO1; 
		}
		else if(servo[1].lt > (servo[0].lt + pwm_deadband))
		{
			WriteTimer1(0xFFFF - servo[0].lt);
			timer1_reload = 0xFFFF - (servo[1].lt - servo[0].lt);
			timer1_mask = SERVO0;	
		}	
		else
		{
			WriteTimer1(0xFFFF - servo[0].lt);
			timer1_reload = 0;
			timer1_mask = SERVO0 & SERVO1;	
		}
		
		if(servo[2].lt > (servo[3].lt + pwm_deadband))
		{
			WriteTimer3(0xFFFF - servo[3].lt);
			timer3_reload = 0xFFFF - (servo[2].lt - servo[3].lt);
			timer3_mask = SERVO3; 
		}
		else if(servo[3].lt > (servo[2].lt + pwm_deadband))
		{
			WriteTimer3(0xFFFF - servo[2].lt);
			timer3_reload = 0xFFFF - (servo[3].lt - servo[2].lt);
			timer3_mask = SERVO2;	
		}	
		else
		{
			WriteTimer3(0xFFFF - servo[2].lt);
			timer3_reload = 0;
			timer3_mask = SERVO2 & SERVO3;	
		}	
		
		LATA = 0x0F;
		TMR0L = 100;
		
		INTCONbits.TMR0IF = 0;
		PIR1bits.TMR1IF = 0;
		PIR2bits.TMR3IF = 0;
		
		T0CONbits.TMR0ON = 1;
		T1CONbits.TMR1ON = 1;
		T3CONbits.TMR3ON = 1;
		return;
	}
				
}

//***************************************************************************************************************
//							main
//***************************************************************************************************************

void main (void)
{
	unsigned char c;
	unsigned char pointer = 0, count = 0;
	union Servo temp;
	
	Init();
	initQueue();

	Delay10KTCYx(10);		// Build in a delay to prevent weird serial characters

	servo[0].lt = 1500;
	servo[1].lt = 1500;
	servo[2].lt = 1500;
	servo[3].lt = 1500;
	
	if(isWDTTO())
	{
		TXString("RST SERVO - WDT\x0A\x0D");
	}
	else if(isMCLR())
	{
		TXString("RST SERVO - MCLR\x0A\x0D");	
	}
	else if(isPOR())	
	{
		TXString("RST SERVO - POR\x0A\x0D");
	}
	else if(isBOR())
	{
		TXString("RST SERVO - BOR\x0A\x0D");
	}
	else
	{
		TXString("RST SERVO\x0A\x0D");	
	}	
	StatusReset();
	
	while(1)
	{
		ClrWdt();
		if(!isRXEmpty())
		{
			popRXQueue(&c);
			
			if(count == 0 && c < 5 && c > 0)
			{
				pointer = c - 1;
				count++;
			}
			else if(count == 1)
			{
				temp.bt[1] = c; 
				count++;
			}
			else if(count == 2)
			{
				temp.bt[0] = c;
				servo[pointer].lt = temp.lt;
				TXString("\x50 ");
				TXDec(pointer+1);
				TXChar(' ');
				TXDec_Int(servo[pointer].lt);
				TXString("\x0A\x0D");	

				count = 0;			
			} else if (c == 0x30)
			{
				Reset();
			}
					
		}		
	}
}
