SPARC-Auburn/IEEE-SoutheastCon-2009/Code/Firmware/PIC/ARRAY/main.h

#ifndef MAIN_H
#define MAIN_H

#define SLAVE
#define ADC_DELAY	500			// Delay between readings in microseconds.
#define ARS_SAMPLES	8


void	high_isr 		(void);
void	high_vec 		(void);
void 	low_vec  		(void);
void 	low_isr  		(void);

void 	Refresh_EEPROM	(void);

void	read_antennas	(void);
void	read_ars		(void);
void	interrupt		(char);
void	cal_ars			(void);
void	cal_ant			(void);
void	line_follow		(void);
void	corner_detection(void);
void	line_detection	(void);
void    get_angle       (void);
void	zero_angle		(void);
void	monitor_angle	(void);



union int_byte
{
	unsigned int lt;
	unsigned char bt[2];
};	
struct proc_status {
    unsigned ProcessInProgress              :1;
    unsigned cal_ant_enabled                :1;
    unsigned line_follow_enabled            :1;
    unsigned corner_detection_enabled       :1;
    unsigned line_detection_enabled         :1;
    unsigned get_angle_enabled				:1;
    unsigned zero_angle_enabled				:1;
    unsigned monitor_angle_enabled			:1;
};
