SPARC-Auburn/IEEE-SoutheastCon-2009/Code/Firmware/PIC/ARRAY/eealloc.h

#define	EE_SWITCH_THRESHOLD_H		0x0000
#define	EE_SWITCH_THRESHOLD_L		0x0001
#define EE_SONAR_DIVIDER_H			0x0002
#define EE_SONAR_DIVIDER_L			0x0003
#define EE_FF_THRESHOLD_H			0x0004
#define EE_FF_THRESHOLD_L			0x0005
#define EE_FB_THRESHOLD_H			0x0006
#define EE_FB_THRESHOLD_L			0x0007
#define	EE_BACK_THRESHOLD_H			0x0008
#define EE_BACK_THRESHOLD_L			0x0009


#define	EE_LINE_THRESHOLD_H			0x0010
#define EE_LINE_THRESHOLD_L			0x0011
#define EE_LINE_FOLLOW_THRESHOLD_H	0x0012
#define EE_LINE_FOLLOW_THRESHOLD_L	0x0013
#define EE_CORNER_THRESHOLD_H		0x0014
#define EE_CORNER_THRESHOLD_L		0x0015
