SPARC-Auburn/IEEE-SoutheastCon-2009/(commit log)

2008-09-06 Added a Test directory in Code, it will contain (you guessed it) test scripts. Also made a simple laser script that makes the laser do a full sweep and print it to the screen, given that the laser is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
2008-09-06 Added another test to laser_test.py in the Test directory.
2008-09-06 Modified laser_test.py with a test that uses read() rather than readline().
2008-09-16 Added some iterative testing to laser_test.py, I think it is going to be fast enough...
2008-09-16 Added a C based laser utility module, I think I will do the translation and analysis(maybe kalman filter) of the laser data in C in these modules, for now I was playing around with reading data in C.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
2008-09-22 Removed misnamed lasermodule.c
2008-09-22 Updated Modules/setup.py to compile Modules/laserutilmodule.c into a python module.
2008-09-23 Changed capitalization of the class/module laser to be laser.Laser rather than Laser.laser, not really important but more correct and more easily done early.
    [laser.py]
2008-09-28 Added Concepts to Mechanical folder.
    [sparc-idea-1.cfg]
2008-09-29 scoop drafted
    [Scoop and Track Assembly.cfg]
2008-09-29 Modified the gripper design.
    [sparc-idea-1.cfg]
2008-10-01 Draft of Scoop and Track system is done...
    [Scoop and Track Assembly.cfg]
2008-10-01 new jpgs of Scoop and Track system...
2008-10-01 Found problem with my design....no room for center mounted wheels
    [Scoop and Track Assembly.cfg]
2008-10-01 Added updated Documentation to laser.py.
2008-10-01 Changed the format of the laser.py documentation slightly.
2008-10-01 Added gripper asm and pictures.
    [gripper.cfg]
2008-10-05 Filled out the scan() function in laser.py, also added safe_scan() and __init__ to Laser of laser.py.
2008-10-05 Netbeans is messing with the indentions... I fixed them, I need to figure out a more stable development environment...
    [laser.py]
2008-10-05 Fixes to laser.py found during testing.
    [laser.py]
2008-10-05 Implemented the clear() function in Laser of laser.py, and used it to implement a 'primer' in the __init__ function. I send the status command to the lrf and sleep 10ms and clear the I/O, this preven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
    [laser.py]
2008-10-05 Fixed a problem with the last commit
    [laser.py]
2008-10-05 Another bug fix, forgot to import time.
    [laser.py]
2008-10-06 Added Robot Mechanical Concept Models. Drafts and add-ons to concept to follow.
    [ARM - ASSY.cfg, CHASSIS - ASSY.cfg, CHASSIS - MOTOR BRACKET.psm, ROBOT ASSY.cfg, SORTER - ASSY.cfg]
2008-10-12 Added CAD files for mechanical chasis and sorting rack.
2008-10-12 Added CAD files for mechanical chasis
    [CHAS-ASSY.cfg]
2008-10-12 Added CAD files for mechanical sorting rack
    [SR-01.psm, SR-04.psm, SR-ASSY.cfg, SR-Assembly.cfg]
2008-10-12 CURRENT PROGRESS ON CHASIS DESIGN
2008-10-12 CURRENT PROGRESS ON SORTING RACK
2008-10-13 ADDED UPDATED CHASSIS CAD FILES WITH PART DRAWINGS
    [CHAS-ASSY.cfg]
2008-10-13 ADDED UPDATED SORTING RACK CAD FILES WITH PART DRAWINGS
    [SR-ASSY.cfg]
2008-10-13 CHANGED THICKNESS ON MOTOR MOUNTS. REALIZED THE MENTAL SCALING WAS OFF.
    [CHAS-ASSY.cfg]
2008-10-14 Added End Effector Directory and the drafts of the RH and LH side grippers.
2008-10-14 Added more parts to the gripper and updated others.
    [GRIPPER.cfg]
2008-10-14 Reduced thicknesses on materials and modified arm strut
    [CHAS-ASSY.cfg, Chassis BOM.xlsx]
2008-10-14 Reduced thicknesses, modified parts, and assembled tentative BOM
    [SR-ASSY.cfg, Sorting Rack BOM.xlsx]
2008-10-16 Cleaning up folder structure.
    [CHAS-ASSY.cfg, Chassis BOM.xlsx, Scoop and Track Assembly.cfg]
2008-10-16 One more clean up.
    [Scoop and Track Assembly.cfg]
2008-10-17 Added assembly of chassis and sorting rack
    [CHAS-SR-ASSY.cfg]
2008-10-17 Updated part and draft files
    [SR-ASSY.cfg, Sorting Rack BOM.xlsx, Sorting Rack Movement.xlsx]
2008-10-17 Added TEBTATIVE BOMs for chassis and sorting rack
    [Chassis BOM.xlsx, Sorting Rack BOM.xlsx]
2008-10-19 ADDED LASER RANGE FINDER MODEL.
2008-10-19 ADDED MOTORS TO ASSEMBLY.
    [CHAS-ASSY.cfg]
2008-10-19 ADDED MOTORS TO ASSEMBLY
2008-10-19 ADDED COMPLETED WHEEL ASSEMBLIES AND MOTORS.
2008-10-19 ADDED COMPLETED MOTOR AND WHEEL ASSEMBLIES.
    [CHAS-ASSY.cfg, CHAS-SR-ASSY.cfg, RIGHT ANGLE MOTOR - L.cfg, WHEEL ASSY.cfg]
2008-10-19 Updated chassis assembly
    [CHAS-ASSY.cfg]
2008-10-19 updated chassis bom
    [Chassis BOM.xlsx]
2008-10-19 Updated chassis files
    [CHAS-06.psm, CHAS-ASSY.asm.cfg, CHAS-ASSY.cfg]
2008-10-19 updated mating and alignment issues.
    [CHAS-06.psm, CHAS-ASSY.cfg]
2008-10-20 Added ball casters; everything except for hole location and total caster height are not exact, but roughly modeled by eye
    [CHAS-06.psm, CHAS-ASSY.cfg, CHAS-SR-ASSY.cfg, Chassis BOM.xlsx]
2008-10-21 DIFFERENT VIEWS OF CURRENT PROGRESS WITH CHASSIS
    [CHAS-07.psm, CHAS-ASSY.cfg, CHAS-SR-ASSY.cfg]
2008-10-22 UPDATED BOMs
    [Chassis BOM.xlsx, Sorting Rack BOM.xlsx]
2008-10-23 Updated part and assembly files as well as cleaned and organized chassis directory; aggregated all hardware references into one folder; aggregated all model images into one folder; added folder for P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
    [CHAS-07.psm, CHAS-ASSY.cfg]
2008-10-24 Added motor controller and batteries to the BOM
    [Chassis BOM.xlsx]
2008-10-26 Shortened scoop. Beginning on Design of fold-out arm/guides.
    [CHAS-SR-ASSY.cfg]
2008-10-29 Adjusted hole diameters to account for machine screw clearances
2008-10-30 Added some models for arm and end effector assemblies. Still putting everything together.
    [CHAS-ASSY.cfg]
2008-10-30 Added Arm Parts.
2008-10-30 Added End Effector model pieces. It's a work in progress.
    [END EFFECTOR ASSY.cfg, END-01.psm]
2008-10-30 Arm parts and assemblies.
    [ARM ASSY.cfg]
2008-10-30 Added a modified version of the top strut component that will connect to the sorting rack and the arm towers
    [CHAS-03a.psm, CHAS-SR-ASSY.cfg]
2008-10-30 Added locking mechanism concept
    [SR-ASSY.cfg]
2008-10-30 Added i2c.h header file. This is mainly a check of MPLAB's VCS capabilities.
2008-11-01 Added an I2C master and slave template.
2008-11-01 Master program is correctly outputing the character 'a' on the I2C bus. My best guess is that this is operating at 50kHz, but I need to use a better probe in order to be sure.
    [main.c]
2008-11-11 Added Arm Mounting Mechanism. End Effector and it's interface in progress.
    [END-01.psm]
2008-11-11 Added Arm Assembly
    [ARM ASSY.cfg, Arm Motor Assembly.cfg]
2008-11-11 Modified Chassis Wall to accomodate Arm Servo.
    [CHAS-ASSY.cfg, CHAS-SR-ASSY.cfg]
2008-11-11 Lowered Sorting Rack.
    [SR-Assembly.cfg]
2008-11-11 Repositioned arm assembly in chassis.
2008-11-11 Fixed Arm to allow end effector to pivot.
2008-11-11 End effector connection interface to arm complete. Need to add servo and control lever.
    [END EFFECTOR ASSY.cfg, END-01.psm, END-02.psm, END-03.psm]
2008-11-11 SHOWING POSITION OF AMD BOARD
2008-11-12 Updated and deleted part files
    [SR-ASSY.cfg]
2008-11-12 Updated changes made during fabrication; opened arm tower span to mount the motherboard
    [CHAS-03a.psm, CHAS-SR-ASSY.cfg]
2008-11-12 Added Arm Motor, Arm, and End Effector into chassis/sorting rack assemblies.
    [CHAS-ASSY.cfg, CHAS-SR-ASSY.cfg]
2008-11-12 Added rubber cushioning
    [END-01.psm]
2008-11-12 Effector modified.
    [CHAS-SR-ASSY.cfg]
2008-11-13 Completed design of end effector.
    [END-01.dxf, END-04.psm]
2008-11-13 Added pictures and Arm/End Effector BOM.
    [Arm and End Effector BOM.xlsx, CHAS-SR-ASSY.cfg, END EFFECTOR ASSY.cfg, END-01.psm, END-03.psm, Scoop and Track Assembly.cfg]
2008-11-13 Lowered motors on motor mounts.
2008-11-13 Quick little update.
    [Arm and End Effector BOM.xls]
2008-11-18 Revised locking mechanism and finger rack
    [SR-05-ASSY.cfg, SR-ASSY.cfg]
2008-11-18 Phase 2 - Bill of materials for chassis and sorting rack
    [Chassis BOM - PHASE 2.xlsx, Sorting Rack BOM - PHASE 2.xlsx]
2008-11-19 Adjustments to chassis and sorting rack BOM
    [Chassis BOM - PHASE 2.xlsx, Chassis BOM - Rev 2.xlsx, Sorting Rack BOM - PHASE 2.xlsx, Sorting Rack BOM - Rev 2.xlsx]
2008-11-19 Minor adjustments to motherboard location
    [CHAS-SR-ASSY.cfg]
2008-11-19 Updated current revisions to sorting rack
    [SR-ASSY.cfg, SR-CRANK-ARM.cfg]
2008-11-21 Updated chassis part drawings and pdf directory
2008-11-21 Updated sorting rack part drawings and pdf directory
    [SR-ASSY.cfg, SR-CRANK-ARM.cfg]
2008-11-21 chassis part drawing pdf
2008-11-27 Added my Arduino code for the sonar array prototype I built in the lab...
2008-12-29 Finished drafts for end effector components.
    [END-01a.psm, END-02a.psm, END-03a.psm, END-04a.psm]
2008-12-31 Added Several new folders in preperation for adding configurations.
    [robot.cfg]
2009-01-01 Fixed a problem with the hex evaluation being 256 which is a no no...
    [sabertooth2x10.py]
2009-01-01 Fixed some conditional statements to be and insted of or and also changed my hex roll over fix to work properly.
    [sabertooth2x10.py]
2009-01-02 Changed drive_left right and both to just left right and both. Also fixed an issue with the swap_motors switch. Also an error in the drive_both function.
    [sabertooth2x10.py]
2009-01-02 Made it so that the first motor doesn't go to 128 for full speed forward.
    [robot.py, sabertooth2x10.py]
2009-01-13 Added Playing Field Files.
    [Playing Field.cfg]
2009-01-13 Robot.py now imports and initializes the sabertooth2x10 module and the sabertooth2x10 module now uses config and logging. Addtionally I put the very basic config information for the sabertooth module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
    [robot.cfg]
2009-01-13 ADDED ELECTRONICS COMPONENTS AND MOUNTS.
2009-01-13 Added logging.cfg config file.
    [logging.cfg]
2009-01-13 Fixed some issues that come up when running on Windows and/or with out the hardware present.
    [robot.py, sabertooth2x10.py]
2009-01-13 Added a new SVN property, and I also have a working Serial connection in Master_Template.
    The key was that the PIC WriteUSART function didn't actually wait for the bus to be free before it started to write. I resolved this by adding a while(BusyUSART()); before each of the WriteUSART() functions.
    This seems to work.
    [main.c, main.h, serial.c, serial.h]
2009-01-15 Got a working example of networking with the remote_server and remote_client apps. Now I just need to add the motor driving component.
    [logging.cfg]
2009-01-17 Fixed William's queue to be compatible.
    Wrote ISR for I2C slave.
    [init.c, main.c, queue.c]
2009-01-17 Okay.
    This slave currently works with the master. I have turned off clock stretching for the time being, but this is something that may have to be revisited at some point, depending on what sensors we have to implement.
2009-01-18 Creating a new project for the Servo controller slave PIC.
2009-01-20 Slave servo work.
    Not done yet.
2009-01-21 Cleaned up the Utilities folder and added configuration to the remote_client.py app.
    [remote_client.cfg]
2009-01-21 Sorting rack to chassis struts
    [CHAS-03a-L.psm, CHAS-03a-R.psm, CHAS-06.psm, CHAS-ASSY.cfg, CHAS-SR-ASSY.cfg]
2009-01-21 Current iteration of sorting rack locking mechanism
    [SR-01.psm, SR-05-2-ASSY.cfg, SR-ASSY.cfg]
2009-01-22 Updated serial.c with a few more functions:
    TXBin_Int() for printing out integers in binary
    TXDec_Int() for printing out integers in decimal
    TXHex_Int() for printing out integers in hex
    These are still untested.
2009-01-22 Deleted PING_Sonar file folder from Code>Firmware>PIC>.
    Finished my PIC programming for the sonar ID array, my code is in Slave_Sonar and is fully functional.
2009-01-23 finished Hall Effect test program
    update pin assignments in the Slave_Sonar program
2009-01-26 Still no progress, but I'm about to do some damage, so this would be a good place to hold on.
    [init.c, main.c, main.h, serial.c]
2009-01-26 Now works with one servo.
2009-01-27 Added Sonar and microswitches.
    [BATTERY MOUNT L.psm, BATTERY MOUNT R.psm, ELECTRONICS MOUNT ASSY.cfg]
2009-01-27 Fixed remote_server.py and adjusted the default robot.cfg
    [robot.cfg]
2009-01-27 Major structural changes and added many features such as automatic boolean conversion in the config files, standardized modules, and enable/disable modules plus more.
    [logging.cfg, robot.cfg]
2009-01-28 Added Microswitch and rear sonar mounts.
    [MICROSWITCH MOUNT.cfg, REAR SONAR MOUNT.cfg, REAR SONAR MOUNT.psm]
2009-01-29 Added a schematics folder.
    [LIBRARY1.OLB, MASTER_NODE.DSN, Master_Node.opj]
2009-01-30 MCN and Servo Controller are done but need testing.
    [logging.cfg, robot.cfg]
2009-01-30 Added the MCN and Servo into robot.py so it loads now.
2009-01-30 Fixed a bug with enumerating the servos.
    [servo_controller.py]
2009-01-30 Fixed another bug in servo_controller.
    [servo_controller.py]
2009-01-30 Fixed yet another bug in servo_controller.
    [servo_controller.py]
2009-01-30 Fixed a print and a constructor error and another logical error.
    [servo_controller.py]
2009-01-30 Yeah, another bug, big suprise.
    [servo_controller.py]
2009-01-30 Lots of bug fixes.
    [robot.cfg]
2009-01-30 bug fixes.
    [robot.cfg]
2009-01-30 Updated servo.
    Works with 4 servos through I2C.
2009-01-31 added the move function to the Servo class, it takes 1.0 to -1.0.
2009-01-31 Bug fixes for Servo.move().
    [servo_controller.py]
2009-01-31 Updated the default robot.cfg
    [robot.cfg]
2009-01-31 Updated the remote control app, should work with servo's, but needs testing.
    [robot.cfg]
2009-01-31 Bug fixes for remote client update.
    [robot.cfg]
2009-02-01 Sonar mounts.
    [SONAR MOUNT.cfg, SONAR MOUNT.psm]
2009-02-02 Upped the clock frequency to 32MHz, this should fix some of our servo jitter.
    [init.c, main.c]
2009-02-02 Massive Revision Cleanup.
    [CHAS-SR-ASSY.cfg, SR-ASSY.cfg]
2009-02-03 All 4 servos appear to be working more accurately than before.
    I corrected an error with the timer prescalers for Timer 1 and Timer 3
    [init.c, main.c]
2009-02-03 Added wheel encoders and mounts.
    [CHAS-SR-ASSY.cfg, WHEEL ENCODER MOUNT.psm]
2009-02-04 Drafted Wheel Encoder Mount.
2009-02-07 Master Template work.
    Also, schematics for part of our microcontroller circuits.
    [Master_Node.opj]
2009-02-08 Added the schematics for the Antenna Array support hardware
    [DOG_FENCE_DETECTOR_ANTENNA_ARRAY.DSN, Dog_Fence_Detector_Antenna_Array.opj, LIBRARY1.OLB]
2009-02-08 Creating a new project for the encoders.
2009-02-09 Bug fixes in microcontrollernetwork.
    [micro_controller_network.py]
2009-02-10 Made improvements to the remote control app, reducing redundant servo position calls.
    [remote_client.cfg]
2009-02-10 Fixed an error in the shutdown function in robot.py.
    [robot.py]
2009-02-10 Fixed another error in the shutdown function in robot.py.
    [micro_controller_network.py]
2009-02-10 Found the limits of the server and updated the robot.cfg file. Also I changed the remote client to be state oriented as opposed to scalar position with the servos, i.e. up, center, and down are the o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
    [robot.cfg]
2009-02-11 Added external interrupts.
    Cut down on serial verbosity.
    Added the ability to write to the chip's eeprom so that we can set "interrupt addresses"
2009-02-12 Added the ability to invert the axises on the motor controlling joystick.
    [remote_client.cfg, robot.cfg]
2009-02-13 Working external interrupts.
    I2C polling left out for now, but will come when we have stuff to talk to.
2009-02-16 Program now reads encoders, however, the program randomly resets.
    [main.c]
2009-02-16 Working Copy of Angular Rate Sensor committed.
2009-02-17 Should work with antennas over I2C.
2009-02-18 Servo routines changed to use Serial rather than I2C.
2009-02-18 fixed Slave_Sonar to work with 3 sonar
    [main.c]
2009-02-18 Rewrote my stuff to use usb on the micro controllers which changed most everything including the config files, so yeah fuck you michael.
    [robot.cfg]
2009-02-19 Working encoder program.
2009-02-19 Fixed the way messages are sent as hex insted of the string literals for the hex.
    [servo_controller.py]
2009-02-19 Servos updated for serial. Actually working now.
2009-02-19 Fixed an error in the move_to_position command.
    [servo_controller.py]
2009-02-19 Working on handeling the return values of the micros.
    [robot.cfg]
2009-02-19 Fixed axis inversion problem in the remote controll app.
    [remote_client.cfg]
2009-02-19 Renamed the servo microcontroller.
2009-02-19 Made a bunch of changes for reset conditions.
    [init.c, main.c]
2009-02-19 Fixed Slave Array. This one compiles, but hasn't been tested AT ALL yet.
    [init.c, main.c, main.h, queue.c, queue.h, serial.c]
2009-02-19 Trying this thing with interrupts now.
2009-02-19 Major structure changes, implemented object detection but needs to be tested.
    [robot.cfg]
2009-02-19 Fixed errors in micro_controller_network.py
    [micro_controller_network.py]
2009-02-19 Fixed the serial monitor to ignore stray return lines and carrige returns.
    [micro_controller_network.py]
2009-02-19 Code works with interrupt driven ADC
2009-02-20 Added new folder "Sensor Testing Documentation" and Antenna Array Testing Results
    [Experimental Data from Antennas.xls]
2009-02-20 changed object array code to aid in calibration
2009-02-20 Fixed the return codes to compare properly with what the micro controllers are sending.
    [object_detection.py]
2009-02-20 Fixed the way the poll sonar command is issued.
    [object_detection.py]
2009-02-20 Fixed the way the poll sonar command is issued, again.
    [object_detection.py]
2009-02-20 Added state machine to ARRAY
    [Experimental Data from Antennas.xls]
2009-02-20 Added state machine and all antenna related functions to ARRAY
    [Experimental Data from Antennas.xls]
2009-02-21 Loads of changes...
    [logging.cfg, robot.cfg]
2009-02-21 Finished the events module, for now, and fixed up object detection.
    [events.py, object_detection.py]
2009-02-21 Fixed some issues with object_detection.
    [object_detection.py]
2009-02-21 I feel good about this ars code, and it has the correct state machine setup which allows for function enables to be set with keyboard characters!
    [main.c, main.h, op_codes.h]
2009-02-21 Added all of William's desired current state functionality...
2009-02-21 Implemented Antenna Array and started Angular Accelerometer.
    [logging.cfg, robot.cfg]
2009-02-21 Fixed some problems with the ARRAY functions, specifically the interrupt func that was being used to notify over serial wasn't actually sending anything...
    [main.c]
2009-02-21 Commented out the back sonar readings...
2009-02-22 Fixed some issues with events.
    [events.py]
2009-02-24 Lots of changes, tried to shore up the shutdown procedures, finished Angular Rate Sensors and Laser stuff, also made some changes to events, every thing needs to be tested still.
    [logging.cfg, robot.cfg]
2009-02-24 Fixed an error in laser.py
    [laser.py]
2009-02-24 Fixed an error in robot.py
    [robot.py]
2009-02-24 Robot.py has logging functions for gripper, arm, motor, sorter and networking capability.
2009-02-24 Fixed it so dash board messages won't propagate to the console.
    [robot.py]
2009-02-25 Print statements taken out. Event added.
2009-02-25 More print statments taken out.
2009-02-25 Turned the Debug msges from the Servo's off by default.
    [logging.cfg]
2009-02-25 Adjusted gripper servo positions.
    [robot.cfg]
2009-02-25 This is the updated servo routine with opcode madness.
2009-02-25 Made the laser module enabled/disabled proof.
2009-02-26 Fixed bugs in EEPROM util.
    [EEPROM.py]
2009-02-26 Updated the ability to start and stop the spinner servo.
    [robot.cfg]
2009-02-26 Hopefully stopped zombie threads...
2009-02-26 Fixed a typo in the robot.py file.
    [robot.py]
2009-02-26 Changing the way configs work.
    [logging.cfg]
2009-02-26 Configs now work like this: If the <config>.cfg file is in the Configurations folder then it will use that otherwise it will try to use <config>.cfg.default, which is the only thing kept in subversio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
    [robot.py]
2009-02-26 Changed events to use a sequential locking mechanism rather than a threaded polling approach.
2009-02-27 Some bug fixes.
    [remote_client.cfg]
2009-02-27 Changed Op Codes to ox01, 0x02 for Michael's EEprom Op-Codes; and changed get_angle() functionality to match Op_Code wiki page description. All angle functions tested and working with my board.
2009-02-28 Updated laser to include the ability to watch for objects infront of the robot and create an event when there is one.
2009-02-28 Okay, looks like all of our ducks are in a row on the antenna business.
    It is IMPORTANT to remember that the EEPROM for the ARRAY uC actually starts at 0x10 (That's HEX 10, or DECIMAL 16, depending on your lingo).
2009-02-28 Fixed laser, now works, haven't tested the new functionality.
    [laser.py]
2009-02-28 Trying to smooth out issues with laser, like noise in the data, I suspect logic errors from moving it from testing to implementation.
    [laser.py, object_detection.py]
2009-02-28 Possibly fixed problems with laser.py, needs testing.
    [laser.py]
2009-02-28 Bug fixes, seems to be working as expected, now im going to change the format of the data returned and start on control code.
    [laser.py]
2009-02-28 Added translation to robot coordinates in teh laser module's check_for_object function.
2009-02-28 Fixed a bug in laser.py .
    [laser.py]
2009-02-28 Fixed a problem where I was using degrees insted of radians.
    [laser.py]
2009-02-28 Still validating and fixing laser translation.
    [laser.py]
2009-02-28 Updated the laser-robot vector offsets.
2009-02-28 Refreshed Angular Accelerometer code, needs testing now.
2009-02-28 Changed how the monitor settings work in laser.
2009-02-28 Changed ARS filter to +/- 6 (from previous value of +/- 4)...should help stop the drift
    [main.c]
2009-02-28 Laser seems to be working well.
2009-03-01 Fixed a problem where laser was incorrectly detecting empty space as an object under special conditions.
    [laser.py]
2009-03-01 Altered the object detection microcontroller to take advantage of the new IR sensor.
    Connections are now:
    Pin 2 - IR
    Pin 3 - Sonar
    Pin 5 - Switch
    EEPROM values are updated as well, recorded in [wiki:EepromAlloc]
2009-03-02 fix to laser
2009-03-02 Added the reset command for all the micros.
    [micro_controller_network.py]
2009-03-03 Removed Lee's print statements...
2009-03-03 Added CALIBRATE_ARS_OP functionality...
2009-03-03 Added the ARS calibrate functionality in.
2009-03-03 Added the start button functionality.
2009-03-03 Added start button functionality
2009-03-04 Updates to seek&destroy, problems still: Gripper is not reopening after sorting, arm is BOR, When sorting on the line, we will always run into the wall, forever....
2009-03-04 Ok, went over all the threads, they should now always exit cleanly... Also I tried soem things to aleviate the LRF dieing randomly after use. You can now register a function to do your shutdown stuff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
2009-03-06 This is a not-really-better, but working version.
    We are reverting back to the dual sonar method to see how it works.
    Let's hope that this was actually worth it.
